valenjess/CubeSat/README.md

# CubeSat
El proyecto consiste en diseñar el hardware electrónico de un nanosatélite académico de formato 1U, tipo CubeSat.
