valenjess/CubeSat/P4/README.md

Esta sección presenta la segunda entrega del proyecto CubeSat.

OBJETIVOS

• Seleccionar y dimensionar los componentes y circuitos de la PCB asignada, justificando su capacidad para cumplir con las especificaciones y las interfaces definidas en la práctica 3.

• Capturar y verificar el diseño electrónico en Altium Designer mediante una estructura jerárquica que facilite su comprensión y reutilización, utilizando símbolos y huellas de componentes validados.

• Establecer las restricciones eléctricas y de fabricación que orientarán el diseño de la PCB, documentarlas en el proyecto y estimar el costo de sus componentes para diferentes volúmenes de producción.

CONTENIDO

• Proyecto nativo de Altium con todas las hojas esquemáticas y las dependencias necesarias para abrirlo.

• Librerías propias editables y modelos utilizados, con símbolos y huellas verificados.

• Todas las hojas de datos y las notas de aplicación utilizadas como soporte.

• Matriz de restricciones, cálculos y análisis de costos en formato editable, con fórmulas cuando corresponda.

• BOM exportada en formato tabular editable y esquemas completos en PDF.

• Informe final.
