valenjess/CubeSat/P3/Diagrama_Arquitectura.pptx

CubeSat 1U — Diagrama funcional de referencia

Arquitectura seleccionada · Trazabilidad con interfaces IF-01 a IF-15

LEYENDA

Potencia

ESTACIÓN
TERRESTRE

IF-15: C&DH ↔ estación terrestre
(a través de TT&C)

IF-14

ANTENA

IF-15

PCB 2 — AVIÓNICA

IF-13

IF-12

TRANSCEPTOR
TT&C

Datos / control

RF

HW + software futuro

C&DH
centralizado

IF-08

ALMACENAMIENTO

IF-04

Trazabilidad:
IF-01 … IF-15
conexiones principales
definidas en la tabla.

IF-11

IF-07

IF-05

CÁMARA
MULTIESPECTRAL

IF-09

ADCS
SENSORES

IF-10

IF-06

PANELES
SOLARES

IF-01

BATERÍA

IF-02

PCB 1 — EPS
Potencia

IF-03

DRIVERS /
MAGNETORQUERS

Nota: protocolos, tensiones y componentes concretos permanecen TBD cuando la documentación de esta etapa no permite cerrarlos.
