valenjess/CubeSat/P4/Entregables/LAB4_DPE.pdf

Diseno electr ˜ | onico y captura esquem ´ | atica de una ´

# tarjeta ADCS para un CubeSat 1U

Valentina Gaviria Samboni¹

, Sebastian Zuluaga Correa¹
1Departamento de Ingeniería Electronica y Telecomunicaciones, Programa de Ingenier ´ | ía Electronica, ´
Universidad de Antioquia, Medellín, Colombia
Abstract—Este informe presenta el diseno electr ˜ | onico y la ´
captura esquematica de una tarjeta dedicada al sistema de deter- ´ minacion y control de actitud (ADCS) de un CubeSat 1U. A partir ´ de la arquitectura definida en la practica anterior, se restringe el ´ alcance a una PCB ADCS autonoma que adquiere variables de ´ actitud, ejecuta el procesamiento necesario para la determinacion´ y el control, acciona tres ruedas de reaccion y tres magnetorquers, ´ y entrega informacion de estado a una tarjeta principal externa. ´ El diseno integra un microcontrolador STM32G474RET6, una ˜ IMU ICM-42670-P, un magnetometro MMC5983MA, seis sen- ´ sores solares BPW34 con acondicionamiento transimpedancia, un ADC ADS8166, controladores DRV8833 para los magnetorquers,
interfaces para ruedas de reaccion, memoria FRAM, supervisi ´ | on´
de reset, alimentacion local y una interfaz externa CAN-FD. Se ´ documentan las decisiones de seleccion, los circuitos auxiliares, el ´ presupuesto preliminar de potencia, las restricciones electricas y ´
de fabricacion, la validaci ´ | on ERC y la BOM. El costo estimado ´
de componentes por tarjeta disminuye de USD 71.57 para un lote de 10 unidades a USD 49.81 para 1000 unidades, bajo el criterio de compra documentado. El resultado corresponde al cierre del
diseno esquem ˜ | atico de la tarjeta; el enrutamiento y la fabricaci ´ | on´
física permanecen como etapas posteriores.
Index Terms—CubeSat 1U, ADCS, determinacion de actitud, ´ control de actitud, STM32G474, magnetometro, IMU, sensores ´ solares, CAN-FD, Altium Designer.
I. INTRODUCCION Y ALCANCE ´

La Practica 4 establece como objetivo seleccionar y di- ´ mensionar los componentes de la PCB asignada, justificar su capacidad frente a las especificaciones e interfaces de la
practica anterior, capturar y verificar el dise ´ | no en Altium ˜
Designer y documentar las restricciones que condicionaran´ la futura implementacion f ´ ísica [1]. La entrega debe permitir que otra persona comprenda la tarjeta y continue con el ´
diseno de PCB, manteniendo expl ˜ | ícitos los límites del trabajo
academico. ´
En esta practica el alcance fue redefinido por el profesor ´ para concentrarse exclusivamente en la tarjeta ADCS. Por tanto, la tarjeta principal externa no se disena: ˜ unicamente ´ se define la interfaz que permitira intercambiar comandos, ´
configuracion, estado y telemetr ´ | ía. Quedan fuera del alcance
el payload, camara, TT&C/RF, almacenamiento de im ´ | agenes, ´
OBC completo, EPS completo del CubeSat, antena y estacion´ terrestre. Esta delimitacion es fundamental para evitar incor- ´ porar funciones que pertenecen a otras tarjetas del sistema.
La solucion final se implement ´ | o como una PCB ADCS ´
dedicada, con un procesamiento centralizado y bloques de
sensado, actuacion, alimentaci ´ | on, supervisi ´ | on y comunicaci ´ | on. ´
La Figura I debe corresponder al diagrama funcional final del
diseno y mostrar expl ˜ | ícitamente la frontera entre la ADCS y
la tarjeta principal externa.

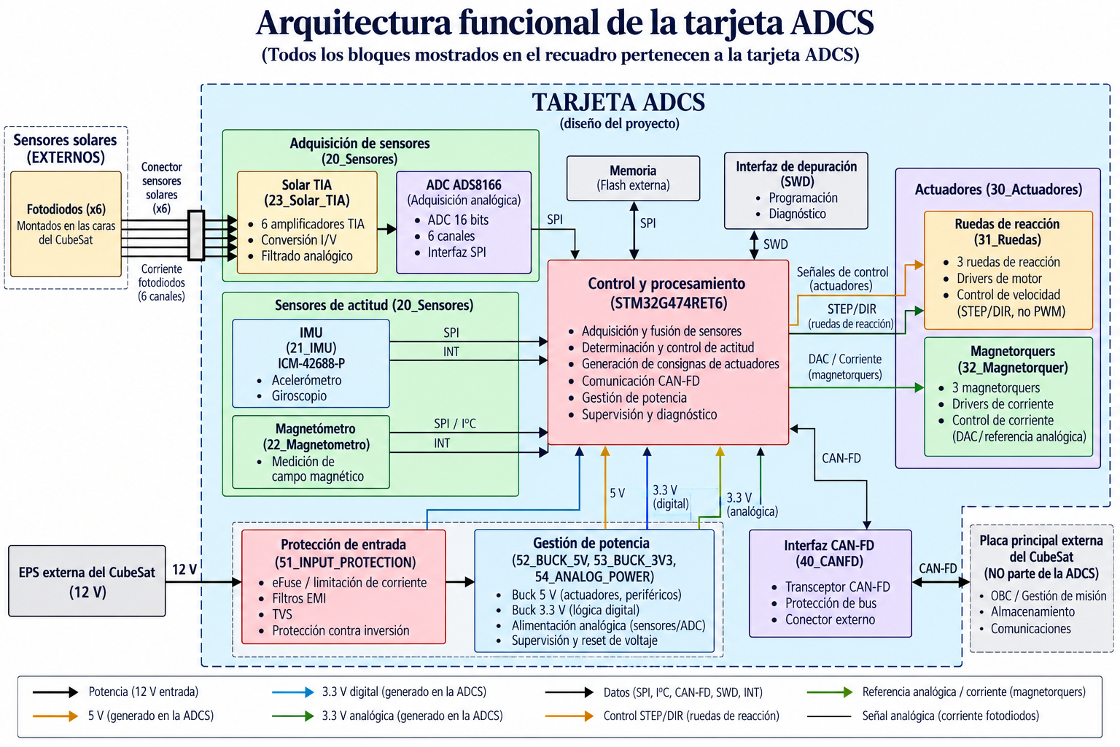
[picture p20: figure]

Fig. 1. Arquitectura funcional de la tarjeta ADCS y su interfaz con la tarjeta principal externa.

II. REQUISITOS APLICABLES Y TRAZABILIDAD CON LA
PRACTICA ´ | 3

La línea base de P4 conserva los requisitos de P3 que afectan directamente a la ADCS. En particular, RF-007 exige
la determinacion de actitud, RF-008 el control y estabilizaci ´ | on, ´
RF-018 la deteccion y recuperaci ´ | on de fallos, RF-019 la ´
supervision, y ET-35, ET-38, ET-39 y ET-40 condicionan ´ interfaces, rieles, niveles logicos y protocolos. ET-45 se utiliza ´ como criterio funcional de cierre del control de actitud y ET-
46 mantiene la consideracion del entorno de radiaci ´ | on en la ´
evaluacion de componentes. ´
La principal modificacion frente a P3 es el cambio de nivel ´
de abstraccion: mientras P3 establec ´ | ía una arquitectura global
del CubeSat, P4 convierte el bloque ADCS en una tarjeta
electronica concreta. En consecuencia, par ´ | ametros globales ´
como el desempeno angular final, el perfil orbital completo o el ˜ enlace TT&C no se vuelven requisitos electricos de esta PCB; ´ unicamente se conservan como entradas para dimensionar la ´ funcion ADCS y su interfaz. ´

III. DESCRIPCION FUNCIONAL Y ARQUITECTURA DE LA ´

TARJETA
La arquitectura seleccionada es un ADCS integrado en una
unica PCB dedicada. El MCU central concentra adquisici ´ | on, ´

TABLE I
TRAZABILIDAD DE REQUISITOS DE P3 APLICABLES AL DISENÕ ADCS
ID | Requisito / especificacion | Aplicaci ´ | on en la PCB ADCS | Tratamiento en P4 ´
RF-007 | Determinacion de actitud | Sensores inerciales, magnet ´ | ometro, sensores solares, ´
adquisicion y procesamiento ´

Seleccion de sensores, ADC, MCU e inter- ´ faces; captura de los circuitos asociados.
RF-008 | Control y estabilizacion de actitud | Procesamiento, drivers y actuadores | Tres ruedas de reacci ´ | on y tres magnetorquers; ´
drivers y temporizacion definidos. ´
RF-009 | Apuntamiento de la camara | Objetivo global de desempe ´ | no del ADCS | Se conserva como criterio de desempe ˜ | no; no ˜
genera hardware de camara en esta PCB. ´
RF-018 | Deteccion, aislamiento y recuperaci ´ | on | Fallos propios de la tarjeta | Supervisor de tensi ´ | on, reset, watchdog in- ´
| | | | | | terno, senales de fallo y telemetr ˜ | ía.
RF-019 | Supervision de subsistemas | Estado y salud del ADCS | Entrega de estado, mediciones y telemetr ´ | ía a
| | | | | | la tarjeta principal.
RNF-006 | Interfaces y compatibilidad | Sensores, actuadores y enlace externo | Verificacion de niveles, protocolos y compat- ´
| | | | | | ibilidad electrica. ´
RNF-007 | Robustez / operacion | Protecci ´ | on y supervisi ´ | on | Protecci ´ | on de entrada, supervisi ´ | on de poten- ´
| | | | | | cia y estados seguros.
RNF-008 | Mantenibilidad / verificabilidad | Debug, pruebas y diagnostico | SWD, test points y separaci ´ | on de funciones ´
| | | | | | de verificacion. ´
ET-35 | Interfaces críticas | Interconexiones internas y externas | Interfaces reales derivadas de los compo-
| | | | | | nentes seleccionados.
ET-38 | Rieles de alimentacion | Entrada y regulaci ´ | on local | +12V ´ | PROT, +5V ACT, +5V ANA y +3V3.
ET-39 | Niveles logicos | MCU y perif ´ | ericos digitales | Verificaci ´ | on de compatibilidad de 3.3 V y 5 ´
V segun dispositivo. ´
ET-40 | Protocolos | SPI, I²C, FDCAN y GPIO/timers | Definidos a partir de los componentes final-
| | | | | | mente seleccionados.
ET-45 | Capacidad funcional de control de actitud | Procesamiento + actuacion | Arquitectura cerrada y verificada a nivel es- ´
quematico. ´
ET-46 | Entorno de radiacion | Componentes cr ´ | íticos ADCS | Considerado como criterio de evaluacion; no ´
| | | | | | constituye certificacion espacial. ´
determinacion/estimaci ´ | on, control, gesti ´ | on de actuadores y ´
comunicacion externa. El flujo funcional es: ´

Sensores → Adquisicion´ → Estimacion´
→ Control → Drivers → Actuadores.

(1)

La informacion de estado y telemetr ´ | | ía se entrega a la tarjeta
principal mediante la interfaz externa CAN-FD.

TABLE II
BLOQUES FUNCIONALES DE LA PCB ADCS
Bloque | Interfaz principal | Funcion´
Procesamiento | SPI, | I²C, | FDCAN,
GPIO, timers

Determinacion, control, estados y ´ comunicacion. ´
Sensado
inercial
| SPI1 + INT | | IMU de 6 ejes.
Sensado magnetico ´ | SPI1 + DRDY | | Campo magnetico terrestre en 3 ´
ejes.
Sensado solar | TIA + ADC/SPI2 | Seis canales de irradiancia.
Ruedas | de
reaccion´
SPI3 + CS/ENABLE | Interfaz de tres RW0.
Magnetorquers | PWM/GPIO + H-bridge | Accionamiento de tres torquer.
Interfaz externa | FDCAN1 | | Comunicacion bidireccional con tar- ´ jeta principal.
Alimentacion | +12 V, +5 V, +3.3 V | Protecci ´ | on y regulaci ´ | on local. ´
Supervision/debug NRST, | SWD, | test ´
| points
Reset, diagnostico y programaci ´ | on. ´

La estructura jerarquica se organiza en hojas funcionales ´ para facilitar lectura y reutilizacion. Las hojas de sen- ´
sores, actuadores, alimentacion, adquisici ´ | on y comunicaci ´ | on´
se conectan mediante puertos jerarquicos y nombres de red ´ consistentes. Esta estrategia reduce conexiones largas, facilita
la revision por bloques y permite que el dise ´ | no f ˜ | ísico posterior
mantenga una correspondencia directa con el esquematico. ´

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
D | D
C | C
B | B
A | A

Title

Size | Number | Revision

A4

Date: | 10/26/2026 | Sheet of
File: | C:\Users\..\00_ADCS_TOP.SchDoc | Drawn By:

CTRL_10
10_Control.SchDoc

SNS_20
20_Sensores.SchDoc

ACTS_30
30_Actuadores.SchDoc

CAN_40
40_CANFD.SchDoc

PWR_50
50_POWER.SchDoc

ADCS ESTRUCTURA PCB

Cannot open file ClipboardPicture24/10/2026 9:08:14 p. m.. File does not exist.

Fig. 2. Hoja superior y estructura jerarquica del proyecto ADCS exportada ´ directamente desde Altium Designer.

IV. SELECCION DE COMPONENTES ´

El criterio de seleccion seguido fue consolidar primero las ´ necesidades de sensores y actuadores y, a partir de ellas, derivar los recursos requeridos por el MCU. De esta manera, el procesador no se selecciono arbitrariamente antes de conocer ´ los buses, temporizadores, GPIO, interrupciones, memoria y recursos de comunicacion exigidos por el ADCS. ´

A. Procesamiento y memoria

El STM32G474RET6 fue seleccionado como nucleo de ´ procesamiento. La eleccion se sustenta en la disponibilidad ´ de SPI multiples, I ´

2C, FDCAN, temporizadores para PWM,

GPIO, interrupciones, watchdog, SWD y recursos de procesamiento suficientes para la funcion de ADCS. La memoria ´ FRAM MB85RC256V se incorpora mediante I²C para almacenar parametros, calibraciones, sesgos, eventos y otros datos ´ no volatiles. ´

B. Sensores de actitud
La IMU ICM-42670-P proporciona acelerometro y ´
giroscopo de tres ejes mediante SPI. El magnet ´ | ometro ´
MMC5983MA proporciona medicion magn ´ | etica de tres ´
ejes y comparte SPI1 con la IMU mediante líneas CS
independientes. La separacion f ´ | ísica respecto a fuentes
magneticas y etapas de potencia queda como una restricci ´ | on´
crítica del futuro layout.

TABLE III
SENSORES SELECCIONADOS
Elemento | Seleccion | Justificaci ´ | on´
IMU | ICM-42670-P | Integracion de aceler ´ | ometro y gir ´ | oscopo, ´
interfaz SPI, bajo consumo y CAD
| | disponible.
Magnetometro | MMC5983MA | Alta sensibilidad para determinaci ´ | on de ´
actitud e interfaz digital compatible con
| | el MCU.
Sensores solares | 6 × BPW34 | Arquitectura discreta de coarse sun sen-
sors; permite implementar TIA y ADC
| | propios.
C. Sensado solar y adquisicion anal ´ | ogica ´
Se adoptan seis BPW34, uno por cara del CubeSat, como sensores solares gruesos. Cada fotodiodo entrega una corriente
fotoelectrica que se convierte a tensi ´ | on mediante un canal ´
de transimpedancia. Dos OPA4322AIPWR proporcionan ocho amplificadores disponibles, de los cuales seis se destinan a los canales solares y dos quedan como reserva. El valor preliminar
de la resistencia de realimentacion se fij ´ | o en ´ | Rf = 220 Ω y el
capacitor Cf permanece DNP hasta validar estabilidad, ruido y ancho de banda mediante simulacion o ensayo. ´
El ADC ADS8166IRHBT convierte los seis canales y conserva dos entradas adicionales disponibles. Se emplea SPI2
para datos y control, con una senal ADC ˜ | READY hacia PA15
que debe verificarse durante la revision final de asignaci ´ | on de ´
funciones alternativas.
D. Actuadores y drivers
Se integran tres ruedas de reaccion NanoAvionics RW0 ´ como modulos externos y tres magnetorquers CubeSpace ´ CR0002. Las ruedas utilizan una interfaz SPI compartida, con CS y ENABLE individuales. Para los magnetorquers se utilizan dos DRV8833PWPR, proporcionando tres puentes H efectivos para las tres bobinas. Cada puente recibe dos senales ˜ de entrada y se dispone de nSLEEP y nFAULT para estados seguros y diagnostico. ´
E. Interfaz externa CAN-FD
La interfaz externa se implementa mediante el transceptor TCAN1042HGVDRQ1, con VCC de 5 V y VIO de 3.3 V. Se adopta una velocidad de arbitraje de 500 kbit/s y una

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
D | D
C | C
B | B
A | A

Title

Size | Number | Revision

A4

Date: | 10/26/2026 | Sheet of
File: | C:\Users\..\31_Ruedas.SchDoc | Drawn By:

RUEDAS DE REACCIÓN

IN 1

NC 4

ON 3

OUT | 6
QOD | 5
GND | 2

SW1

TPS22919DCKR

IN 1

NC 4

ON 3

OUT | 6
QOD | 5
GND | 2

SW2

TPS22919DCKR

IN 1

NC 4

ON 3

OUT | 6
QOD | 5
GND | 2

SW3

TPS22919DCKR

1 2 R18

1 2 R19

1 2 R20

1 2 R21

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
Cannot open file ClipboardPicture25/10/2026 1:31:44 p. m.. File does not exist.

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
530470710

+5V_ACT

+5V_ACT

+5V_ACT

GND

GND

GND

10_Control[3B] | RW1_PWR_EN
10_Control[3B] | RW2_PWR_EN
10_Control[3B] | RW3_PWR_EN

+5V_RW1

+5V_RW2

+5V_RW3

+5V_RW1

GND

GND

GND

GND

Cannot open file ClipboardPicture25/10/2026 7:43:58 p. m.. File does not exist.

10_Control[1C] | RW1_ENABLE
10_Control[3B], 31_Ruedas[3C], 31_Ruedas[4B] | SPI3_MISO
10_Control[3B], 31_Ruedas[2C], 31_Ruedas[4B] | SPI3_MOSI
10_Control[3B], 31_Ruedas[2C], 31_Ruedas[4B] | SPI3_SCK
10_Control[1C] | RW1_CS

GND

1 2 R23

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
530470710

+5V_RW3

GND

10_Control[1C] | RW3_ENABLE
10_Control[3B], 31_Ruedas[3B], 31_Ruedas[4B] | SPI3_MISO
10_Control[3B], 31_Ruedas[3B], 31_Ruedas[4B] | SPI3_MOSI
10_Control[3B], 31_Ruedas[2B], 31_Ruedas[4B] | SPI3_SCK
10_Control[1C] | RW3_CS

GND

1 2 R22

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
530470710

+5V_RW2

GND

10_Control[1C] | RW2_ENABLE
10_Control[3B], 31_Ruedas[3B], 31_Ruedas[3C] | SPI3_MISO
10_Control[3B], 31_Ruedas[2C], 31_Ruedas[3B] | SPI3_MOSI
10_Control[3B], 31_Ruedas[2B], 31_Ruedas[2C] | SPI3_SCK
10_Control[1C] | RW2_CS

GND

Fig. 3. Etapa de ruedas de reaccion y conexiones hacia los m ´ | odulos externos. ´

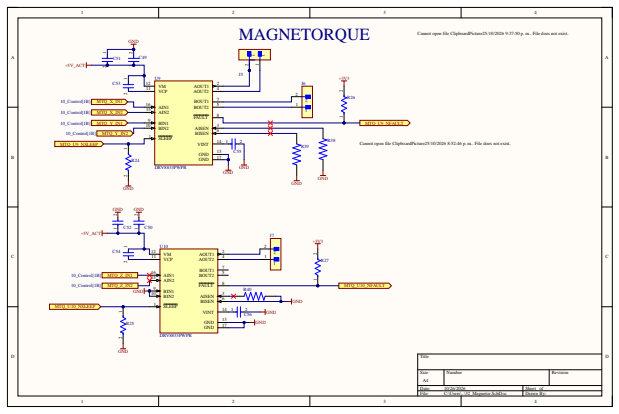
[picture p21: figure]
Title; Size; Number; Revision; Date:; Sheet of; File:; C:\Users\..\32_Magnetor.SchDoc; Drawn By:; MAGNETORQUE; VINT; AOUT1; AOUT2; BOUT1; BOUT2; BIN1 9 BIN2 10; AIN1 16 AIN2 15; FAULT; SLEEP 1; AISEN; BISEN; VCP 11; GND; DRV8833PWPR; 10_Control[1B]; MTQ_X_IN1; MTQ_X_IN2; MTQ_Y_IN2; MTQ_Y_IN1; MTQ_Z_IN1; MTQ_Z_IN2; MTQ_U9_NSLEEP; MTQ_U10_NSLEEP; MTQ_U9_NFAULT; MTQ_U10_NFAULT; +5V_ACT

Cannot open file ClipboardPicture25/10/2026 8:52:46 p. m.. File does not exist.

Cannot open file ClipboardPicture25/10/2026 9:37:50 p. m.. File does not exist.

Fig. 4. Etapa de magnetorquers y sus drivers de potencia.

velocidad de datos de 2 Mbit/s. La cadena física incorpora una
CMC, proteccion ESD, terminaci ´ | on de 120 ´ | Ω seleccionable y
conector externo. La terminacion se implementa mediante R28 ´ y un selector R29 de 0 Ω/DNP.
V. DISENO ELECTR ˜ | ONICO DE LOS BLOQUES CR ´ | ÍTICOS
A. Mapa de recursos del MCU

La asignacion principal de recursos se muestra en la ´ Tabla V. La distribucion mantiene buses independientes donde ´ la arquitectura lo requiere y evita compartir senales de se- ˜ leccion entre dispositivos con necesidades distintas. ´

B. Reset, arranque y supervision´

El supervisor TPS3839K33DBZR genera el reset del MCU sin requerir un pull-up externo en NRST, de acuerdo con la configuracion push-pull adoptada. PB8 se utiliza como ´ I

2C1 SCL; por ello no se utiliza como configuracion de ´ BOOT0 y la dependencia de arranque se gestiona mediante option bytes. El watchdog interno IWDG queda disponible para recuperacion ante bloqueo del software futuro. ´

TABLE IV
ACTUADORES Y ELECTRONICA DE ACCIONAMIENTO ´
Elemento | Seleccion | Cantidad | Interfaz / electr ´ | onica | Observaci ´ | on´
Rueda de reaccion | NanoAvionics RW0 | 3 | SPI3 | compartido | + | CS/ENABLE ´
individual; | alimentacion | mediante ´
TPS22919DCKR

El modulo incorpora su propia ´ electronica de control; el ICD de ´ harness debe cerrarse antes del layout.
Magnetorquer | CubeSpace CubeTorquer CR0002 | 3 | H-bridge DRV8833, PWM/GPIO | El driver de potencia se imple-
menta localmente; deben verificarse los límites electricos y el ICD defini- ´ tivo.
Driver MTQ | DRV8833PWPR | 2 | Seis IN1/IN2, nSLEEP y nFAULT | Se utilizan tres de los cuatro puentes
disponibles.
Load switch RW | TPS22919DCKR | 3 | PWR EN individual | Permite conmutacion y aislamiento ´
de cada rueda.

TABLE V
ASIGNACION PRINCIPAL DE PINES E INTERFACES DEL ´ | STM32G474RET6
Recurso | Pines / senales | Destino | Funci ˜ | on´
SPI1 | PA5/PA6/PA7 | ICM-42670-P + MMC5983MA | Bus de sensores de actitud; CS independientes en PC0/PC1.
Interrupciones | PC2, PC4, PC5 | Magnetometro / IMU | DRDY e INT1/INT2. ´
SPI2 | PB13/PB14/PB15 + PB12 | | ADS8166 | Conversion solar; ADC ´ | READY en PA15.
SPI3 | PC10/PC11/PC12 | RW1–RW3 | Comunicacion con ruedas de reacci ´ | on. ´
I
2C1 | PB8/PB9 | | MB85RC256V | FRAM de parametros/calibraciones. ´
FDCAN1 | PA11/PA12 | TCAN1042HGVDRQ1 | Interfaz CAN-FD externa.
PWM/timers | PA0–PA3, PB0/PB1 | DRV8833 U9/U10 | Seis comandos IN1/IN2 para tres magnetorquers.
Supervision | PC3/PA4/PB7 | PG ´ | 5V, PG 3V3, POWER FAULT | Supervision de alimentaci ´ | on. ´
SWD | PA13/PA14 | | ST-LINK | Programacion y depuraci ´ | on. ´
Reset | PG10 | | TPS3839K33DBZR | Reset supervisado.

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
D | D
C | C
B | B
A | A

Title

Size | Number | Revision

A4

Date: | 10/26/2026 | Sheet of
File: | C:\Users\..\40_CANFD.SchDoc | Drawn By:
VCC 3 | CANH | 7
| CANL | 6

RXD 4

STB 8

TXD 1

VIO | 5
GND | 2

U11

TCAN1042HGVDRQ1

1

2 | 3

4 L1

ACT1210D-101-2P-TL00

2

1

3

D7
NUP2105LT1G

R28
RC0402FR-07120RL

1 2 R29

RC0402FR-070RL

R30
RC0402FR-0710KL

C57
GRM155R71A104KA01J

C58
GRM155R71A104KA01J

1 2
C59
CL10A475KP8NNNC

2
1

3

J8

TSW-103-07-T-S +3V3

GND

+5_ACT

10_Control[1B] | FDCAN1_TX
10_Control[1B] | FDCAN1_RX

CAN_H

CAN_L

Fig. 5. Interfaz física CAN-FD con transceptor, proteccion, terminaci ´ | on y ´
conector externo.
C. Entrada de alimentacion y protecci ´ | on´

La tarjeta recibe una alimentacion externa nominal de +12 ´ V, con un rango de diseno de 10–15 V. La entrada incor- ˜ pora TVS, capacitor bulk, capacitor de alta frecuencia y un eFuse TPS26600RHFR segun la BOM exportada. El eFuse ´
proporciona proteccion frente a sobrecorriente, subtensi ´ | on, ´
sobretension y polaridad inversa. La red RILIM se dimension ´ | ó
preliminarmente en 6.78 kΩ para un límite cercano a 1.8 A; las redes de UVLO/OVLO utilizan 357 kΩ, 18.0 kΩ y 30.1 kΩ. Nota de consistencia documental: el inventario actualizado del proyecto identifica U12 como TPS26601RHFR, mientras

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
D | D
C | C
B | B
A | A

Title

Size | Number | Revision

A4

Date: | 10/26/2026 | Sheet of
File: | C:\Users\..\10_Control.SchDoc | Drawn By:

CONTROL

VDD 16
VDD 32
VDD 48
VDD 64
VDDA 29
PC0 | 8
PC1 | 9
PC2 | 10
PC3 | 11
PC4 | 22
PC5 | 23
PC6 | 38
PC7 | 39
PC8 | 40
PC9 | 41
PC10 | 52
PC11 | 53
PC12 | 54
PC13 | 2
PC14-OSC32 IN | 3
PC15-OSC32 OUT | 4
PF0-OSC IN | 5
PF1-OSC OUT | 6

PA0 12
PA1 13
PA2 14
PA3 17
PA4 18
PA5 19
PA6 20
PA7 21
PA8 42
PA9 43
PA10 44
PA11 45
PA12 46
PA13 49
PA14 50
PA15 51
PD2 | 55
PG10/RST | 7

VBAT 1

VREF+ 28

PB0 24
PB1 25
PB2 26
PB3 56
PB4 57
PB5 58
PB6 59
PB7 60
PB8-BOOT0 61
PB9 62
PB10 30
PB11 33
PB12 34
PB13 35
PB14 36
PB15 37
VSS | 15
VSS | 31
VSS | 47
VSS | 63
VSSA | 27

U1

STM32G474RET6

GND | 1
RESET_N | 2 VDD 3

U2

TPS3839K33DBZR

WP | 7
VSS | | 4
SDA | 5 SCL | 6

VDD 8

A0 1
A1 2
A2 3

U3

FM24W256-GTR

1 2
C7

1 2
C5

1 2
C3

1 2

C2 ¹ 2
C4 | 1 2
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
01 01
02 02
03 03
04 04
05 05

J1

TSW-105-07-L-S

+3V3

GND

GND

AGND

Capacitores de 0.1uF para respuestas rápidas de HF, y el de 4.7uF para desacoplo general y reserva de energía

1 2
C78

+3V3A

AGND
AGND
+3V3A | +3V3

+3V3

GND

GND

+3V3

GND

+3V3

GND

I2C1_SCL | 10_Control[1C]
I2C1_SDA | 10_Control[1C]
10_Control[4A] | I2C1_SDA

I2C1_SCL

10_Control[4A]

R1

R2

+3V3

+3V3

10_Control[3C] | SWDIO
10_Control[3C] | SWCLK
10_Control[1B] | SWDIO
10_Control[1C] | SWCLK

GND

PG10-NRST
10_Control[3C], 10_Control[4B], Adquicision_Analogica[4A]

PG10-NRST
10_Control[2C], 10_Control[4B], Adquicision_Analogica[4A]
1 | 2

D1

PG10-NRST
10_Control[2C], 10_Control[3C], Adquicision_Analogica[4A]

1 2
C11
IMU_CS | 21_IMU[2A]
MAG_CS | 22_Magnetometro[2A]
MAG_DRDY | 22_Magnetometro[2A]
IMU_INT1 | 21_IMU[2A]
IMU_INT2 | 21_IMU[2A]
21_IMU[3A], 22_Magnetometro[2A] | SPI1_SCK
21_IMU[3A], 22_Magnetometro[3A] | SPI1_MISO
21_IMU[3A], 22_Magnetometro[2B] | SPI1_MOSI
Adquicision_Analogica[4B] | ADC_CS
Adquicision_Analogica[4B] | SPI2_SCK
Adquicision_Analogica[4A] | SPI2_MISO
Adquicision_Analogica[4B] | SPI2_MOSI
Adquicision_Analogica[4A] | ADC_READY
40_CANFD[1B] | FDCAN1_RX
40_CANFD[1B] | FDCAN1_TX
51_INPUT_PROTECTION[4A] | POWER_FAULT
RW1_PWR_EN | 31_Ruedas[1A]
RW2_PWR_EN | 31_Ruedas[1C]
RW3_PWR_EN | 31_Ruedas[1D]
SPI3_SCK | 31_Ruedas[2B], 31_Ruedas[2C], 31_Ruedas[4B]
31_Ruedas[2B] | RW1_ENABLE
31_Ruedas[3B] | RW2_ENABLE
31_Ruedas[2C] | RW3_ENABLE
SPI3_MISO | 31_Ruedas[3B], 31_Ruedas[3C], 31_Ruedas[4B]
SPI3_MOSI | 31_Ruedas[2C], 31_Ruedas[3B], 31_Ruedas[4B]
31_Ruedas[3B] | RW1_CS
31_Ruedas[4B] | RW2_CS
31_Ruedas[3C] | RW3_CS

32_Magnetor[1A] MTQ_X_IN1
32_Magnetor[1B] MTQ_X_IN2
32_Magnetor[1B] MTQ_Y_IN1
32_Magnetor[1B] | MTQ_Y_IN2
32_Magnetor[1C] | MTQ_Z_IN1
32_Magnetor[1C] | MTQ_Z_IN2

Fig. 6. Hoja de control con el STM32G474RET6, buses y senales principales. ˜

que la BOM exportada identifica TPS26600RHFR. Antes del commit final debe verificarse el MPN real colocado en el esquematico y sincronizar ambos documentos. Esta verifi- ´ cacion es obligatoria para mantener la correspondencia BOM– ´ esquematico. ´

D. Regulacion de potencia ´

El riel +12V PROT alimenta dos convertidores buck. U13 TPS62133A-Q1 genera +5V ACT y U14 TPS62162DSGT
genera +3V3. El riel analogico +5V ´ | ANA se obtiene medi-
ante una ferrita desde +5V ACT y se filtra localmente para alimentar los amplificadores y el ADC.

TABLE VI
Á RBOL DE ALIMENTACION DE LA TARJETA ´
Etapa | | Salida | Carga principal
Entrada + proteccion | +12V ´ | PROT | Toda la tarjeta.
Buck U13 | | +5V ACT | Ruedas, magnetorquers, drivers y logica de 5 V. ´
Filtro analogico | +5V ´ | ANA | OPA4322 y ADS8166.
Buck U14 | +3V3 | MCU, sensores, FRAM, transceptor y
| | | logica. ´
E. Presupuesto preliminar de potencia
El peor caso conservador de las ruedas de reaccion domina ´ el presupuesto. Para tres RW0 se consideran hasta 0.65 A por unidad a 5 V, resultando:
PRW = 3(5 V)(0.65 A) = 9.75W. | (2)

Para tres CR0002 se adopta preliminarmente una corriente promedio equivalente a 5/51 A por actuador con un ciclo de trabajo del 80%, resultando aproximadamente 1.18
W. Sumando OPA4322, ADS8166, drivers, MCU, sensores, FRAM, CAN y logica se obtiene un presupuesto preliminar ´ de aproximadamente 11.36 W antes de perdidas. Con 20% de ´

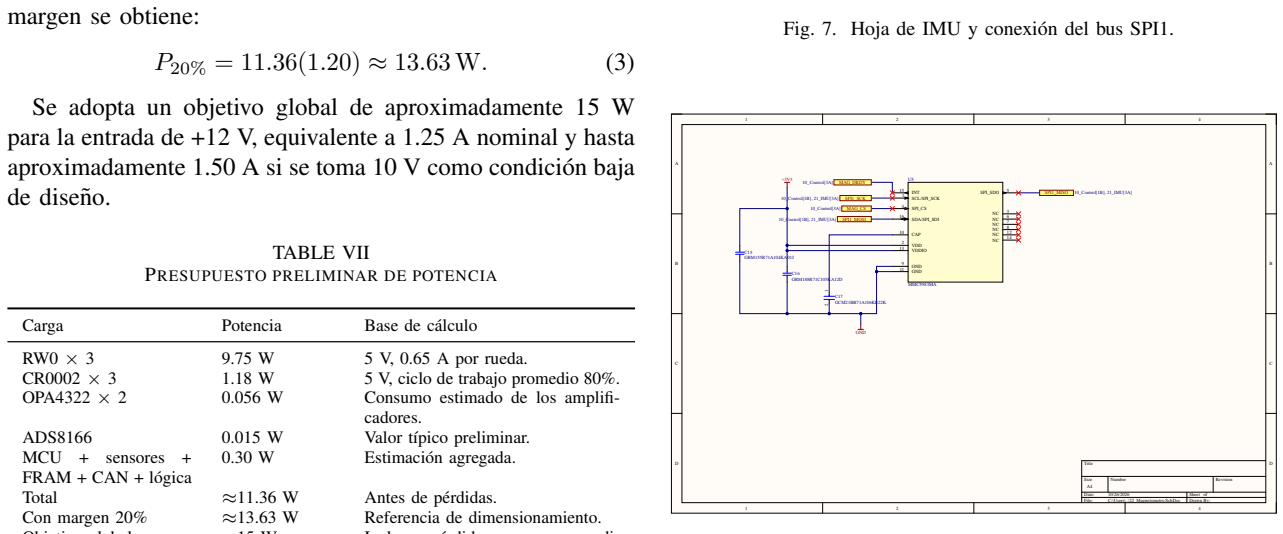
[picture p22: figure]
margen se obtiene:; de diseno. ˜; TABLE VII; PRESUPUESTO PRELIMINAR DE POTENCIA; Carga; Potencia; Base de calculo ´; 5 V, 0.65 A por rueda.; OPA4322 × 2; Consumo estimado de los amplifi-; cadores.; ADS8166; Valor típico preliminar.; MCU + sensores + FRAM + CAN + logica ´; Estimacion agregada. ´; Total; Antes de perdidas. ´; Con margen 20%; Referencia de dimensionamiento.; Title; Size; Number; Revision; Date:; Sheet of; File:; C:\Users\..\22_Magnetometro.SchDoc; Drawn By:; INT 15 SCL/SPI_SCK 1; SPI_CS 4; SDA/SPI_SDI 16; CAP 10; VDD 2 VDDIO 13; GND 9 GND 11; SPI_SDO; MMC5983MA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

Se adopta un objetivo global de aproximadamente 15 W para la entrada de +12 V, equivalente a 1.25 A nominal y hasta aproximadamente 1.50 A si se toma 10 V como condicion baja ´

CR0002 × 3 | 1.18 W | 5 V, ciclo de trabajo promedio 80%.
Objetivo global | ≈15 W | Incluye perdidas y margen adi- ´ cional.
VI. ADQUISICION SOLAR Y C ´ | ALCULOS DE CIRCUITOS ´

Cada BPW34 se conecta a un canal de transimpedancia.
Para un canal ideal, la relacion de primera aproximaci ´ | on es: ´
Vout ≈ −IphRf , | (4)
donde Iph es la corriente fotoelectrica y ´ | Rf = 220 Ω es
el valor preliminar adoptado. El capacitor Cf permanece DNP porque su valor depende de la capacitancia total del fotodiodo, capacitancias parasitas, estabilidad del OPA4322, ´ ruido y ancho de banda deseado. Esta decision evita fijar un ´ valor sin una validacion suficiente. ´
Los seis canales llegan al ADS8166, un ADC SAR de 16 bits y ocho entradas. La capacidad de dos canales adicionales permite reservar entradas para futuras necesidades o mediciones auxiliares. La referencia y los desacoplos se implemen-
tan segun las recomendaciones de aplicaci ´ | on del fabricante: ´
REFIO y REFby2 con 1 µF, y red REFP–REFM con 22 µF.
El ADC incorpora ademas el capacitor de desacoplo de 1 ´ | µF
indicado en la arquitectura del proyecto.

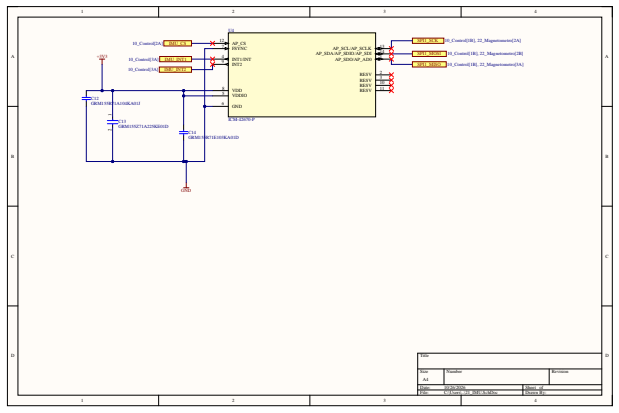
[picture p23: figure]
Title; Size; Number; Revision; Date:; Sheet of; File:; C:\Users\..\21_IMU.SchDoc; Drawn By:; AP_CS 12 FSYNC 7; INT1/INT 4 INT2 9; VDD 8 VDDIO 5; GND 6; AP_SCL/AP_SCLK; AP_SDA/AP_SDIO/AP_SDI; AP_SDO/AP_AD0; RESV; ICM-42670-P; C12 GRM155R71A104KA01J; C13 GRM155Z71A225KE01D; C14 GRM155R71E103KA01D; GND; SPI1_SCK; 10_Control[1B], 22_Magnetometro[2A]; SPI1_MOSI; 10_Control[1B], 22_Magnetometro[2B]; SPI1_MISO; 10_Control[1B], 22_Magnetometro[3A]; 10_Control[2A]; IMU_CS; 10_Control[3A]; IMU_INT1; IMU_INT2

Fig. 7. Hoja de IMU y conexion del bus SPI1. ´

Fig. 8. Hoja de magnetometro y conexi ´ | on al bus SPI1. ´

VII. RESTRICCIONES DE PCB Y CONDICIONES DE FABRICACION´

La guía exige distinguir entre límites del fabricante y
criterios de diseno. Para el proyecto se seleccion ˜ | o PCBWay ´
como referencia de fabricacion. Se adopta una PCB r ´ | ígida
de cuatro capas, FR-4, espesor de 1.60 mm y cobre de 1 oz en capas exteriores e interiores. El stackup preliminar es
L1 senales/componentes, L2 GND, L3 potencia y L4 se ˜ | nales ˜
secundarias. El stackup dielectrico definitivo debe confirmarse ´ antes de cerrar cualquier regla dependiente de impedancia. El criterio de ancho de pistas de potencia se derivo del ´ presupuesto de corriente, no del mínimo de fabricacion. Con ´ cobre de 1 oz, capa externa y un criterio termico preliminar ´

TABLE VIII
CONDICIONES PRINCIPALES DE FABRICACION Y DISE ´ | NO ADOPTADAS ˜
Parametro | Capacidad / l ´ | ímite | Objetivo ADCS | Aplicacion´
Capas | 1–14 disponibles | 4 capas | Separacion de se ´ | nales, GND y potencia. ˜
Material | FR-4 | FR-4 | PCB rígida academica. ´
Espesor | 0.2–3.2 mm | 1.60 mm | Valor estandar de referencia. ´
Cobre | 1–8 oz exterior | 1 oz | Base del calculo de potencia. ´
Trace mínimo | 0.10 mm | ≥0.20 mm | No disenar al l ˜ | ímite manufacturable.
Clearance mínimo | 0.10 mm | ≥0.20 mm | Margen DFM.
Taladro mínimo | 0.15 mm | ≥0.25 mm | Evitar taladros innecesariamente pequenos. ˜
Anillo anular | 0.15 mm | ≥0.15 mm | Mantener margen de fabricacion. ´
Cobre a borde | 0.25 mm publicado | ≥0.50 mm | Margen mecanico adicional. ´
Vías | Through-via | Through-via | No se requieren microvías inicialmente.
Acabado | ENIG disponible | ENIG | Adecuado para SMD y contactos.
Impedancia | Servicio disponible | No requerida preliminarmente | Se recalculara si el layout posterior la exige. ´

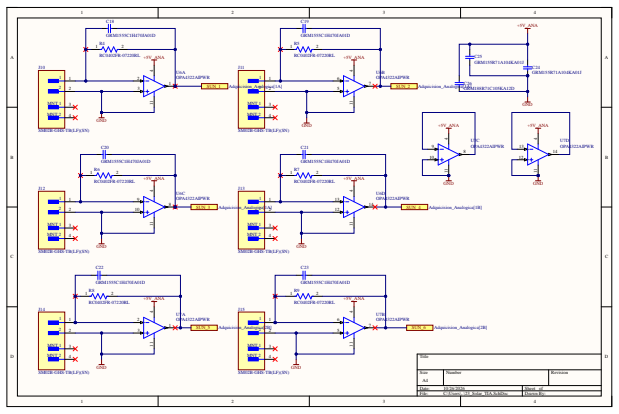
[picture p24: figure]
Title; Size; Number; Revision; Date:; Sheet of; File:; C:\Users\..\23_Solar_TIA.SchDoc; Drawn By:; MNT 1; MNT 2; SM02B-GHS-TB(LF)(SN); U6A OPA4322AIPWR; U6B OPA4322AIPWR; U6C OPA4322AIPWR; U6D OPA4322AIPWR; U7A OPA4322AIPWR; U7B OPA4322AIPWR; U7C OPA4322AIPWR; U7D OPA4322AIPWR; GRM1555C1H470JA01D; C24 GRM155R71A104KA01J; C25 GRM155R71A104KA01J; GRM188R71C105KA12D SUN_1; Adquicision_Analogica[1A]; GND; +5V_ANA; SUN_2; SUN_3; SUN_5; Adquicision_Analogica[2B]; SUN_4; Adquicision_Analogica[1B]; SUN_6

Fig. 9. Acondicionamiento analogico de los sensores solares y adquisici ´ | on´
mediante ADC.

de ∆T = 10 ◦C, se obtuvieron aproximadamente 0.166 mm para 0.65 A y 0.755 mm para 1.95 A. Por margen se adoptan ≥0.20 mm para ramas de hasta 0.65 A y ≥0.80 mm para la troncal +5V ACT de 1.95 A.

I5V,trunk = 3(0.65 A) = 1.95 A. | (5)

La caída de tension no se considera cerrada: debe calcularse ´ cuando se conozca la longitud real de cada tramo, incluyendo vías, conectores y retornos. De forma general,

∆V = IR, | (6)
por lo que la verificacion final requiere la geometr ´ | | ía física.
Las restricciones de colocacion m ´ | as cr ´ | íticas son la proximi-
dad de los capacitores de entrada/salida a los convertidores, la
compactacion de los lazos SW, el aislamiento de las se ´ | | nales ˜
VOS/FB respecto a nodos de alto dV /dt, la continuidad de
retornos, la separacion de sensores magn ´ | | eticos respecto a ´
actuadores y potencia, y la ubicacion local de los desacoplos ´ de IMU, magnetometro, ADC y drivers. ´

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
D | D
C | C
B | B
A | A

Title

Size | Number | Revision

A4

Date: | 10/26/2026 | Sheet of
File: | C:\Users\..\50_POWER.SchDoc | Drawn By:

PWR51
51_INPUT_PROTECTION.SchDoc

PWR52
52_BUCK_5V.SchDoc

PWR53
53_BUCK_3V3.SchDoc

PWR54
54_ANALOG_POWER.SchDoc

POTENCIA

Fig. 10. Hoja de potencia, proteccion de entrada y distribuci ´ | on de rieles. ´

VIII. INCORPORACION DE RESTRICCIONES AL ´ ESQUEMATICO ´

Las restricciones de diseno se clasificaron seg ˜ | un el mecan- ´
ismo disponible en Altium Designer. Las condiciones que pueden comprobarse electricamente se expresan mediante re- ´ glas/directivas asociadas a las redes y tipos de pin cuando corresponde; las condiciones que dependen de la geometría física, la ubicacion o el stackup permanecen en la matriz ´ de restricciones como requisitos para la etapa de PCB. Esta separacion evita confundir una nota descriptiva con una regla ´ efectivamente comprobable.
La matriz consolidada es, por tanto, la fuente de control para las restricciones que no pueden cerrarse en el esquematico. ´ En particular, los anchos de pista de potencia de 0.20 mm y 0.80 mm son objetivos preliminares derivados de corriente y cobre, no simples copias del mínimo manufacturable del proveedor.
IX. VERIFICACION EL ´ | ECTRICA Y REVISI ´ | ON MANUAL ´

La guía exige ejecutar la validacion del proyecto, corregir ´ errores reales, documentar excepciones y complementar ERC
con una revision manual [1]. En el dise ´ | no se realiz ˜ | o la ´
validacion el ´ | ectrica y se corrigieron conexiones incorrectas y ´
asociaciones de terminales. Tambien se ajustaron reglas ERC ´

TABLE IX
TRATAMIENTO DE RESTRICCIONES EN EL PROYECTO
Categoría | Mecanismo | Estado para P4

Tipos de pin y alimentacion´

Reglas ERC / configuracion el ´ ectrica ´

Aplicado y revisado durante la validacion. ´
Redes y buses | Nombres | jerarquicos, ´
puertos | y | reglas | de
conectividad

Incorporado en las hojas
esquematicas. ´
Ancho de pistas | Matriz de restricciones /
regla de PCB posterior
Objetivo | definido;
pendiente de configuracion´ física.
Clearance y taladros Matriz / reglas DRC posteriores

Objetivos definidos segun´ fabricante; pendiente de
PCB.
Ubicacion | y ´
desacoplamiento

Notas de diseno y matriz Debe verificarse durante ˜ placement.
Retornos y separacion´
magnetica ´
Matriz de restricciones | Pendiente | de
implementacion f ´ | ísica.
Stackup e impedancia | Matriz / configuracion de ´
PCB
Stackup | preliminar
definido; valores finales
pendientes.

para controlar condiciones de tipos de pin y alimentacion que ´ no estaban suficientemente definidas en determinados nodos. Los unicos warnings residuales aceptados corresponden a ´ puertos fuera de cuadrícula (Off grid Port). Estos mensajes
son geometricos/documentales y no indican una desconexi ´ | | on´
electrica. Se mantuvieron como excepci ´ | on expl ´ | ícita en lugar
de desactivar globalmente ERC. El mensaje de U1 relacionado
con la validacion de estado de revisi ´ | on frente al servidor de ´
Altium no se contabiliza como error electrico. ´

TABLE X
RESUMEN DE VERIFICACION DEL ESQUEM ´ | ATICO ´
Verificacion | Resultado | Evidencia / observaci ´ | on´
ERC del proyecto | Ejecutado y depurado | Mensajes revisados.
Errores | electricos ´
reales
Corregidos | Conexiones incorrectas corregi-
das.
Terminales / asociaciones
Corregidas | Revision ERC + manual. ´

Reglas de tipos de
pin
Aplicadas | Reglas adicionales configuradas.
Revision manual | Completada | Alimentaci ´ | on, | se ´ | nales, | pines, ˜
buses y auxiliares.
Off grid Port | Aceptados | Excepcion geom ´ | etrica documen- ´
tada.
Estado final | Cerrado | | Sin errores electricos pendientes. ´

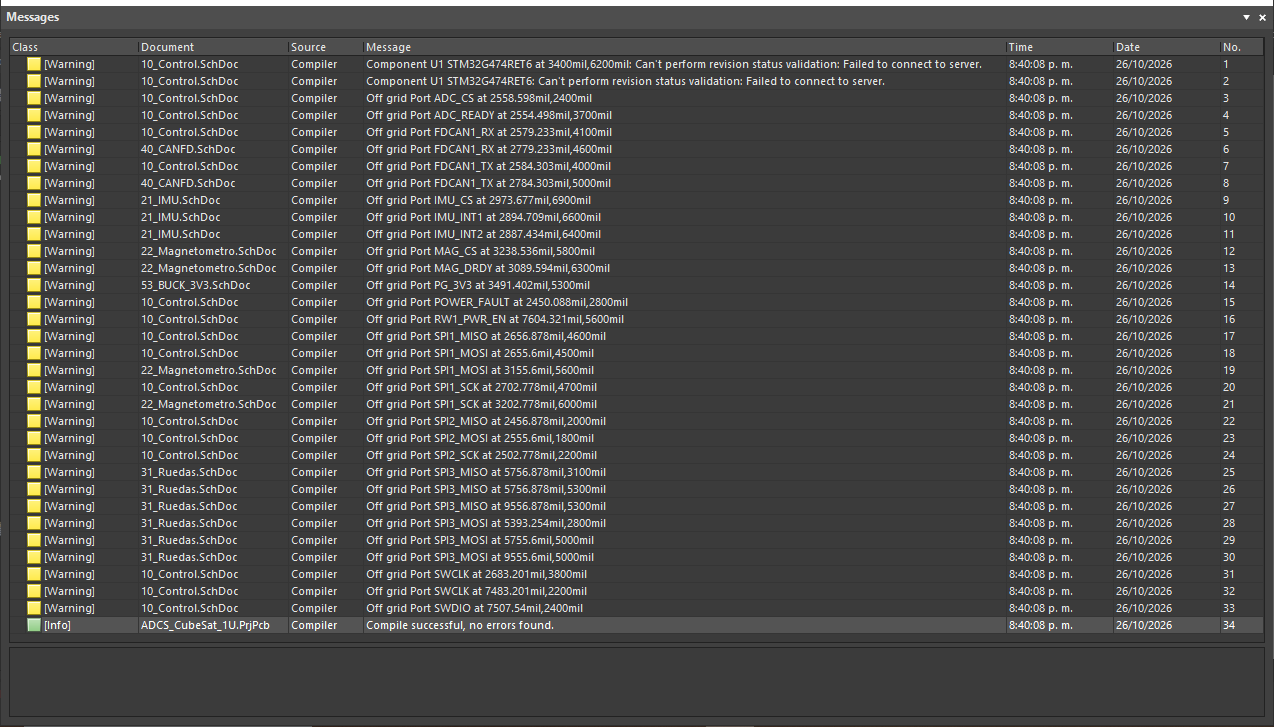
[picture p25: figure]

Fig. 11. Evidencia de validacion ERC y warnings residuales aceptados. ´

La verificacion no equivale a una demostraci ´ | on de fun- ´
cionamiento físico. La guía establece que un esquema sin mensajes de error no demuestra por sí solo que el circuito funcione; por ello, la validacion realizada se interpreta como ´
cierre del diseno esquem ˜ | atico y no como certificaci ´ | on de ´
desempeno. ˜
X. BOM Y ANALISIS DE COSTOS ´
La BOM se genero desde Altium con 62 l ´ | | íneas agrupadas
y un total de 151 componentes por tarjeta. Se incluyeron designadores, descripcion, cantidad, fabricante, MPN exacto, ´ footprint y LibRef. El analisis de costos utiliza solamente ´ componentes de la PCB; no incluye fabricacion, ensamblaje, ´ transporte ni impuestos, de acuerdo con la guía [1].

TABLE XI
RESUMEN DE COSTOS DE COMPONENTES
Lote | Costo lote [USD] | USD/tarjeta | Observacion´
10 | 715.69 | 71.57 | Compra de componentes para 10 tar-
| | | jetas.
100 | 5850.21 | 58.50 | Escalones de cantidad aplicados.
1000 | 49810.60 | 49.81 | Escalones de cantidad y multiplos ´
| | | aplicados.

La reduccion del costo unitario se explica principalmente ´ por los escalones de precio de los componentes de mayor valor. Para el lote de 10 unidades, los mayores contribuyentes son el ADS8166, el STM32G474RET6, el inductor XFL4020, los DRV8833, el eFuse, los OPA4322 y el magnetometro. ´ En lotes grandes, el ADS8166 continua siendo el compo- ´ nente dominante del costo. Esta concentracion implica que ´ una revision futura de alternativas del ADC puede tener un ´ impacto economico considerable, siempre que no se degrade ´ el desempeno requerido. ˜

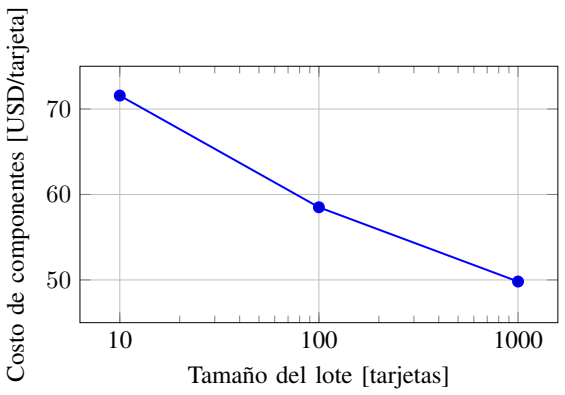
[picture p26: figure]
Costo de componentes [USD/tarjeta]; Tamano del lote [tarjetas] ˜

Fig. 12. Costo estimado de componentes por tarjeta frente al tamano del lote. ˜

La metodología de compra considera MOQ y multiplos ´ cuando se conocen. Los componentes sin precio exacto no se asignan a cero: se marcan como estimados/interpolados. En el
analisis actual, 43 l ´ | íneas tienen precio publicado o exacto y 19
utilizan una estimacion expl ´ | ícita. El MPN generico SMBJ18A ´

permanece con fabricante pendiente. Esta separacion evita ´
presentar una estimacion como una cotizaci ´ | on firme. ´

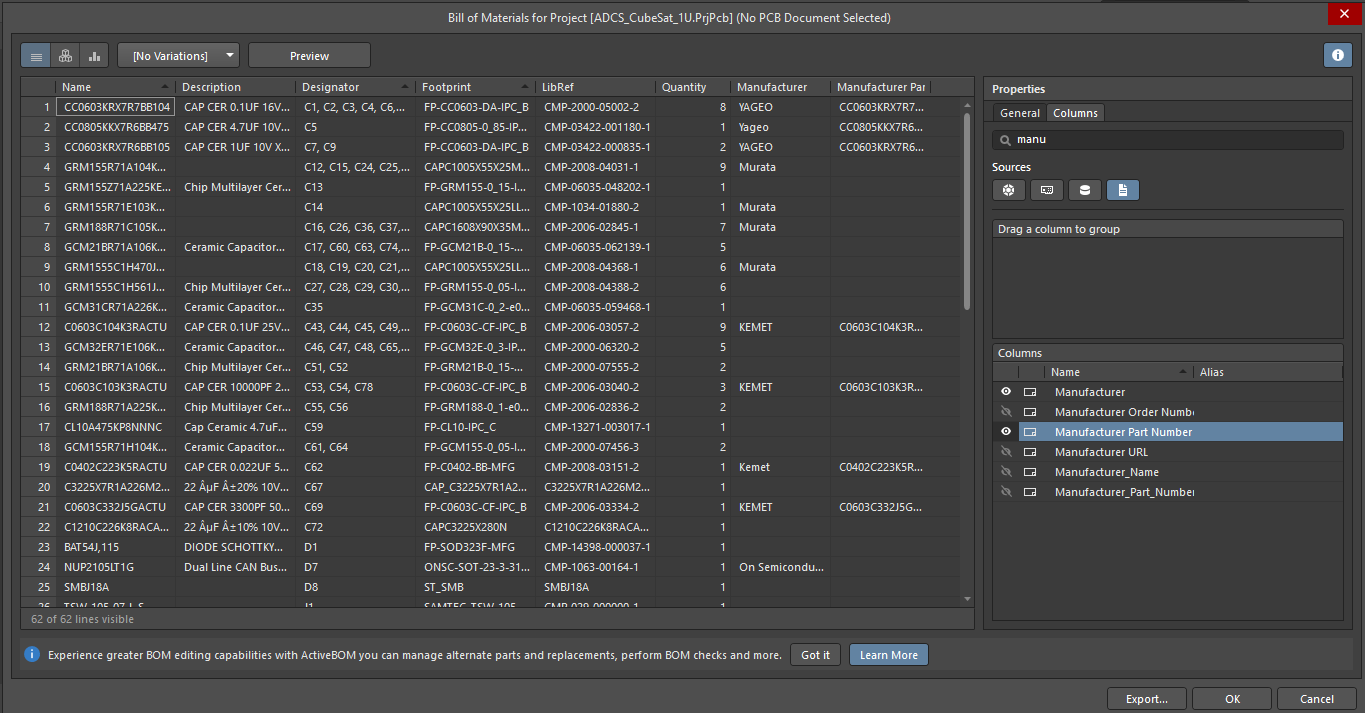
[picture p27: figure]

Fig. 13. Ventana BOM de Altium con fabricante, MPN, footprint, designadores y cantidades.

XI. COHERENCIA DOCUMENTAL Y ASUNTOS PENDIENTES
El cierre de P4 no significa que todos los parametros de ´ diseno f ˜ ísico esten congelados. Permanecen abiertos aquellos ´ que dependen del ICD mecanico de conectores y actuadores, ´ del stackup real, de la geometría del layout o de validaciones experimentales. Los principales son:
- verificar la asignacion definitiva de funciones alternativas ´
del STM32G474, especialmente senales de temporizaci ˜ | on´
para los DRV8833 y ADC READY;
- cerrar el ICD de los conectores de RW0 y CR0002 antes de crear keepouts y posiciones mecanicas; ´
- validar Rf y Cf de los TIA mediante simulacion/ensayo; ´
- verificar el encapsulado y la correspondencia de footprint del DRV8833PWPR antes del layout;
- calcular la caída de tension de las redes de potencia con ´ longitudes reales;
- confirmar el stackup de cuatro capas antes de definir reglas dependientes de impedancia;
- sincronizar el MPN de U12 entre inventario y BOM, ya que el inventario registra TPS26601RHFR y la BOM exportada registra TPS26600RHFR.
El ultimo punto es especialmente importante para la traz- ´ abilidad de fabricacion. El informe adopta como referencia ´ de costos el MPN presente en la BOM exportada, pero el esquematico y el inventario deben ser consistentes antes de la ´ entrega final.
XII. EVIDENCIA DE ORGANIZACION Y REUTILIZACI ´ | ON´

La estructura jerarquica de Altium separa control, sensores, ´
actuadores, alimentacion, adquisici ´ | on y CAN-FD. Esta sepa- ´
racion permite reutilizar bloques funcionales y simplifica la ´
revision. Los componentes seleccionados tienen s ´ | ímbolo y
footprint asociados cuando se dispone de modelo verificado, mientras que los elementos externos como RW0 y CR0002 se representan mediante sus interfaces y conectores, sin convertir
sus modulos mec ´ | anicos en huellas arbitrarias de la PCB. ´
La estrategia de reutilizacion tambi ´ | en se refleja en el ´
uso de buses compartidos con seleccion individual: SPI1 ´
para IMU/magnetometro, SPI3 para las ruedas de reacci ´ | on´
y FDCAN1 para la interfaz externa. Las etapas de potencia se mantienen como bloques independientes para facilitar el
analisis t ´ | ermico y de retorno durante el dise ´ | no f ˜ | ísico.

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
D | D
C | C
B | B
A | A

Title

Size | Number | Revision

A4

Date: | 10/26/2026 | Sheet of
File: | C:\Users\..\00_ADCS_TOP.SchDoc | Drawn By:

CTRL_10
10_Control.SchDoc

SNS_20
20_Sensores.SchDoc

ACTS_30
30_Actuadores.SchDoc

CAN_40
40_CANFD.SchDoc

PWR_50
50_POWER.SchDoc

ADCS ESTRUCTURA PCB

Cannot open file ClipboardPicture24/10/2026 9:08:14 p. m.. File does not exist.

Fig. 14. Vista general de la hoja superior del esquematico ADCS y sus ´ interconexiones jerarquicas. ´

XIII. LIMITACIONES DEL RESULTADO

El diseno corresponde a una soluci ˜ | on acad ´ | emica de captura ´
esquematica y no constituye una demostraci ´ | on de aptitud ´
para vuelo espacial. La guía de P4 establece explícitamente que no se exige enrutar la PCB ni generar archivos de
fabricacion, y que las simplificaciones acad ´ | emicas deben man- ´
tenerse explícitas [1]. Por ello, no se presenta el diseno como ˜ una PCB fabricable o calificada para vuelo.
Asimismo, la seleccion de componentes se realiz ´ | o para ´
cumplir las funciones y facilitar el diseno electr ˜ | onico dentro ´
del alcance academico. La calificaci ´ | on espacial, radiaci ´ | on, vi- ´
bracion, vac ´ | ío, outgassing, confiabilidad de mision y disponi- ´
bilidad de largo plazo requieren analisis espec ´ | íficos que exce-
den esta practica. ´

XIV. CONCLUSIONES

Se completo el dise ´ | no esquem ˜ | atico de una tarjeta ADCS ´
dedicada para un CubeSat 1U. La solucion integra sensores ´ inerciales y magneticos, seis sensores solares con acondi- ´
cionamiento analogico, ADC, memoria no vol ´ | atil, proce- ´
samiento central, tres ruedas de reaccion, tres magnetorquers, ´
drivers de potencia, supervision, protecci ´ | on de entrada, regu- ´
lacion local y una interfaz CAN-FD con la tarjeta principal ´ externa.
La seleccion del STM32G474RET6 se realiz ´ | o despu ´ | es de ´
consolidar los recursos exigidos por los bloques del ADCS. La arquitectura de interfaces utiliza SPI1 para los sensores de actitud, SPI2 para adquisicion solar, SPI3 para las ruedas, ´ I

2C para FRAM y FDCAN1 para la interfaz externa. El
arbol de potencia se cerr ´ | o preliminarmente con +12V ´ | PROT,
+5V ACT, +5V ANA y +3V3, y el presupuesto de diseno se ˜
establecio alrededor de 15 W incluyendo m ´ | argenes. ´

Las restricciones de fabricacion se documentaron tomando ´ PCBWay como referencia y diferenciando claramente los mínimos manufacturables de los objetivos de diseno. Para las ˜ redes de potencia se adoptaron anchos preliminares de 0.20 mm para ramas de hasta 0.65 A y 0.80 mm para la troncal de
1.95 A, quedando la caída de tension para verificaci ´ | on durante ´
el layout.
La validacion el ´ | ectrica y la revisi ´ | on manual permitieron ´
cerrar los errores reales del esquematico y documentar las ´
unicas excepciones residuales. Finalmente, la BOM qued ´ | ó
estructurada con 62 líneas agrupadas y 151 componentes por tarjeta, con costos estimados de USD 71.57, USD 58.50 y USD 49.81 por tarjeta para lotes de 10, 100 y 1000 unidades, respectivamente. El resultado constituye una línea base coherente para continuar con el diseno f ˜ ísico de la PCB.

REFERENCIAS

[1] Universidad de Antioquia, Departamento de Ingeniería Electronica, ´
Practica 4 – Dise ´ | no Electr ˜ | onico y Captura Esquem ´ | atica ´ | , guía sum-
inistrada para el curso, 2026.
[2] V. Gaviria Samboni y S. Zuluaga Correa, P4 ADCS – Entregable
completo, puntos 1–11, hoja de calculo de dise ´ | no, 2026. ˜
[3] STMicroelectronics, STM32G474xx Datasheet and Reference Manual,
documentacion t ´ | ecnica del fabricante. ´
[4] TDK InvenSense, ICM-42670-P Datasheet, documentacion t ´ | ecnica del ´
fabricante.
[5] MEMSIC, MMC5983MA Datasheet, documentacion t ´ ecnica del fabri- ´ cante.
[6] Vishay, BPW34 PIN Photodiode, documentacion t ´ ecnica del fabricante. ´
[7] Texas Instruments, OPA4322 Low-Noise, Rail-to-Rail I/O CMOS Operational Amplifier, documentacion t ´ ecnica del fabricante. ´
[8] Texas Instruments, ADS8166 16-bit, 250-kSPS, 8-Channel SAR ADC, documentacion t ´ ecnica del fabricante. ´
[9] Texas Instruments, DRV8833 Dual H-Bridge Motor Driver, documentacion t ´ ecnica del fabricante. ´
[10] Texas Instruments, TCAN1042HGV High-Speed CAN FD Transceiver,
documentacion t ´ | ecnica del fabricante. ´
[11] Texas Instruments, TPS2660x 60-V eFuse, documentacion t ´ | ecnica del ´
fabricante.
[12] Texas Instruments, TPS62133A-Q1 3-A Step-Down Converter, documentacion t ´ ecnica del fabricante. ´
[13] Texas Instruments, TPS62162 1-A Step-Down Converter, documentacion´ tecnica del fabricante. ´
[14] PCBWay, PCB Capabilities, capacidades de fabricacion consultadas para ´ la practica, 2026. Disponible en: https://www.pcbway.com/capabilities. (https://www.pcbway.com/capabilities.html) ´ html (https://www.pcbway.com/capabilities.html)
