valenjess/CubeSat/P3/README.md

En esta sección se detalla la primera entrega del proyecto CubeSat.

Objetivos:

• Derivar, a partir de la descripción del proyecto, requisitos verificables y especificaciones técnicas que orienten el diseño del hardware electrónico del CubeSat.

• Proponer y comparar alternativas de arquitectura, considerando la distribución de funciones entre hardware y software, la división del sistema en PCBs y las restricciones de potencia, 
de procesamiento, de almacenamiento, de comunicaciones, de masa y de volumen.

• Definir una arquitectura electrónica coherente mediante diagramas de bloques, presupuestos preliminares e interfaces que proporcionen una base suficiente para iniciar el diseño esquemático.

Contenido:

• La hoja de cálculo editable con las matrices, comparaciones y presupuestos.

• Los Diagramas de arquitectura en formato editable y exportados como imagen o en formato PDF.

• Hoja de cálculos para justificar decisiones.

• Las fuentes técnicas consultadas.
