valenjess/CubeSat/P3/Fuentes_Tecnicas_Consultadas_CubeSat_1U.docx

FUENTES TÉCNICAS CONSULTADAS

CubeSat 1U – Monitoreo multiespectral de cultivos de café

Laboratorio 3 – Requisitos, especificaciones y arquitectura electrónica

# 1. Propósito

Este documento reúne las fuentes técnicas utilizadas como base para la definición de requisitos, especificaciones, arquitectura, presupuestos y sustentaciones del Laboratorio 3. Se separan las fuentes entregadas por el curso de las fuentes técnicas externas consultadas.

Los enlaces externos corresponden a páginas oficiales o documentos oficiales de las organizaciones responsables. Las referencias internas se identifican mediante el nombre exacto del archivo y la sección o contenido relevante para que puedan localizarse directamente en el material del proyecto.

# 2. Documentación base proporcionada por el curso

Ref. | Documento | Ubicación / identificación | Uso en el proyecto
INT-01 | lab003_2598575_20262.pdf | Práctica 3 – Requisitos, especificaciones y arquitectura; especialmente descripción, procedimiento y entregables. | Define el método de trabajo, etapas, criterios de requisitos, especificaciones, arquitectura, presupuestos y fuentes que deben utilizarse.
INT-02 | Proyecto CubeSat UD34 2026.pdf | Descripción del proyecto; misión, sistemas electrónicos principales, restricciones y alcance académico. | Fuente primaria de la misión: CubeSat 1U, vida nominal, órbita de referencia, estación en Medellín, cámara multiespectral, energía solar, baterías, ADCS, comunicaciones y ausencia de propulsión.
INT-03 | CDS+REV14_1+2022-02-09.pdf | CubeSat Design Specification Rev. 14.1, Cal Poly SLO; secciones de especificaciones generales y mecánicas. | Sustenta restricciones y criterios CubeSat utilizados en masa/volumen, integración, materiales, venteo y otras condiciones aplicables.
INT-04 | Sustentacion_Especificaciones_Tecnicas_CubeSat(1).docx | Documento de sustentación de especificaciones técnicas; secciones de auditoría, cálculos y fuentes. | Registra la revisión del trabajo previo, correcciones, cálculos preliminares, TBD y trazabilidad utilizada para cerrar la matriz.

# 3. Fuentes técnicas externas oficiales

Ref. | Fuente / referencia | Organización | Localización precisa | Enlace oficial
EXT-01 | ECSS-E-ST-10C Rev.1 – System engineering general requirements (15 February 2017) | European Cooperation for Space Standardization (ECSS) | Documento completo; especialmente requisitos generales de ingeniería de sistemas, especificaciones, arquitectura, trazabilidad y presupuestos técnicos. | https://ecss.nl/standard/ecss-e-st-10c-rev-1-system-engineering-general-requirements-15-february-2017/
EXT-02 | ECSS-E-ST-20C Rev.2 – Electrical and electronic (8 April 2022) | European Cooperation for Space Standardization (ECSS) | Documento completo; requisitos y principios para ingeniería eléctrica, electrónica, EMC, alimentación y equipos electrónicos. | https://ecss.nl/standard/ecss-e-st-20c-rev-2-electrical-and-electronic-8-april-2022/
EXT-03 | CubeSat 101: Basic Concepts and Processes for First-Time CubeSat Developers, Revision dated October 2017 | NASA CubeSat Launch Initiative | Documento completo; conceptos CubeSat, subsistemas, ADCS, interfaces, integración y proceso de desarrollo. | https://science.nasa.gov/wp-content/uploads/2023/06/nasa_csli_cubesat_101_508.pdf
EXT-04 | CubeSat Design Specification Rev. 14.1 | The CubeSat Program, Cal Poly SLO | Sección 1.4 (Non-compliance), 1.6 (terminología normativa), sección 2 (CubeSat Specification), incluidas restricciones generales y mecánicas. | https://www.nasa.gov/kennedy/launch-services-program/cubesat-launch-initiative/cubesat-launch-initiative-resources/
EXT-05 | THEIA – Miniature. Multispectral. Calibrated. | Tartu Observatory Space Exploration Group | Descripción y especificaciones del instrumento THEIA: GSD, FOV, resolución, número de bandas, masa y compatibilidad 1U. | https://tospexgroup.space/projects/theia/
EXT-06 | What are the band designations for the Landsat satellites? | U.S. Geological Survey (USGS) | Tabla de bandas Landsat y rangos espectrales; referencia para la selección y justificación conceptual de bandas de observación. | https://www.usgs.gov/faqs/what-are-band-designations-landsat-satellites
EXT-07 | Sentinel-2 – Instrument | European Space Agency (ESA) | Descripción del instrumento MSI, concepto multiespectral, bandas, red edge, adquisición y datos para observación de vegetación. | https://www.esa.int/Applications/Observing_the_Earth/Copernicus/Sentinel-2/Instrument

# 4. Relación entre las fuentes y las decisiones del proyecto

Tema | Fuentes | Aplicación
Misión y alcance | INT-02 | La descripción oficial del proyecto es la fuente primaria.
Proceso de ingeniería y trazabilidad | INT-01 + EXT-01 | La guía define el procedimiento del laboratorio y ECSS aporta el marco general de ingeniería de sistemas.
Restricciones CubeSat | INT-03 + EXT-03 | CDS Rev. 14.1 y NASA CubeSat 101 sirven como referencias técnicas generales; las condiciones particulares de lanzamiento prevalecerían en una misión real.
Ingeniería eléctrica/electrónica | EXT-02 | Se utiliza como referencia para criterios eléctricos/electrónicos y EMC cuando tienen consecuencia directa en el diseño.
Payload multiespectral | INT-02 + EXT-05 + EXT-06 + EXT-07 | La misión define la necesidad de imagen multiespectral; THEIA aporta un referente de nanosatélite y USGS/ESA aportan contexto espectral y de observación de vegetación.
Cálculos preliminares | INT-04 + fuentes técnicas asociadas | Los cálculos se documentan en la sustentación y se mantienen como exploratorios cuando todavía no corresponden a una especificación cerrada.

# 5. Criterio de uso de fuentes

Las páginas comerciales, blogs y respuestas generadas por herramientas de inteligencia artificial no se utilizaron como sustituto de hojas de datos, normas, artículos técnicos o documentación oficial. Este criterio coincide con la propia guía del laboratorio, que indica que esas fuentes pueden orientar la búsqueda, pero no sustituyen la documentación técnica que sustenta una decisión.

En particular, las fuentes externas de este listado se conservaron porque corresponden a organismos, programas u organizaciones responsables de los documentos o instrumentos descritos. Los documentos INT-01 a INT-04 son los materiales de trabajo del propio curso/proyecto y constituyen la referencia principal para las decisiones específicas de esta práctica.

# 6. Nota sobre enlaces y versiones

Los documentos normativos pueden actualizarse o ser sustituidos por revisiones posteriores. Para esta práctica se conserva la revisión que corresponde a los documentos utilizados durante el desarrollo del Laboratorio 3. En una fase posterior de diseño, cualquier requisito que dependa de una misión de lanzamiento real deberá contrastarse además con el proveedor de lanzamiento y sus requisitos vigentes.

# 7. Referencias web verificadas

- ECSS-E-ST-10C Rev.1: página oficial ECSS con documento y anexos.
- ECSS-E-ST-20C Rev.2: página oficial ECSS con documento y anexos.
- NASA CubeSat Launch Initiative Resources: página oficial que enlaza CubeSat 101 y las CubeSat Design Specifications.
- NASA CubeSat 101: PDF oficial de NASA, revisión de octubre de 2017.
- THEIA: página oficial del Tartu Observatory Space Exploration Group.
- USGS Landsat band designations: página oficial del U.S. Geological Survey.
- ESA Sentinel-2 Instrument: página oficial de la European Space Agency.
