valenjess/CubeSat/P3/Sustentacion_Calculos_CubeSat.docx

CÁLCULOS Y SUSTENTACIÓN TÉCNICA

CubeSat 1U – Monitoreo multiespectral de cultivos de café

Laboratorio 3 – Requisitos, especificaciones y arquitectura

# 1. Objetivo del documento

Este documento reúne los cálculos utilizados para justificar decisiones, relaciones de dimensionamiento y estimaciones preliminares del proyecto. Se ha revisado contra la versión definitiva de la matriz y se separan explícitamente los cálculos que permanecen abiertos de los cálculos exploratorios que no deben interpretarse como valores finales.

La guía solicita que los presupuestos sean consistentes y sustentados y que se entregue cualquier cálculo adicional utilizado para justificar decisiones. Por ello, las ecuaciones de datos, almacenamiento, comunicaciones, potencia, energía, masa, volumen y procesamiento se documentan aquí junto con su trazabilidad.

# 2. Criterio de cierre y control de versiones

La versión definitiva de la matriz mantiene como TBD los parámetros que todavía dependen de la selección de componentes, del plan de observación, del enlace o de la arquitectura detallada. No se introducen valores externos para forzar el cierre de esos parámetros.

Una consecuencia importante de la revisión es que la sustentación anterior no debe presentarse como si 30 m/píxel, las bandas rojo/NIR, 16 bits por muestra o 2.765 MB/imagen fueran especificaciones definitivas. Esos valores se conservan únicamente como cálculos exploratorios auditados, porque la matriz definitiva mantiene ET-02, ET-06 y ET-41–ET-43 abiertos.

# 3. Cadena de cálculo de la arquitectura

La cadena de dependencia utilizada es:

Payload → datos por adquisición → almacenamiento → tiempo de contacto → tasa de bajada → potencia/energía → EPS/batería → procesamiento e interfaces

Esto evita seleccionar memoria, radio, batería u OBC de manera independiente. Los cálculos posteriores deben alimentar las decisiones de arquitectura y mantenerse trazables a las especificaciones correspondientes.

# 4. Cálculos de presupuesto — versión definitiva

ID | Magnitud | Ecuación | Resultado | Trazabilidad | Criterio de cierre
CALC-01 | Datos por imagen | D_img = N_x × N_y × N_bandas × bits/muestra ÷ 8 | TBD | ET-06 | La resolución del sensor, bandas, profundidad radiométrica, formato y eventual compresión todavía deben cerrarse.
CALC-02 | Capacidad de almacenamiento | S_req ≥ D_img × N_capturas_entre_descargas + datos_aux + margen | TBD | ET-07 | No se fija capacidad hasta conocer el volumen por imagen y el número máximo de adquisiciones entre descargas.
CALC-03 | Tasa mínima de bajada | R_min ≥ D_acumulados / t_contacto; posteriormente se incorporan eficiencia y margen | TBD | ET-10 | Depende del volumen acumulado y de la duración efectiva de los pases sobre Medellín.
CALC-04 | Potencia total | P_total = Σ P_subsistemas + pérdidas + margen | TBD | ET-36 / ET-37 | No se adopta como consumo final ninguna cifra de una etapa anterior.
CALC-05 | Energía por modo | E_modo = P_modo × t_modo | TBD | ET-11 / ET-37 | Se requiere el perfil de potencia y duración de cada modo operativo.
CALC-06 | Batería utilizable | E_bat,usable ≥ E_eclipse + margen | TBD | ET-11 / ET-37 | Debe incorporar demanda durante eclipse, eficiencia, profundidad de descarga y margen definido.
CALC-07 | Masa total | M_total = Σ m_componentes + estructura + cableado + margen | ≤ 2.00 kg | ET-12 | La suma real se cerrará cuando existan componentes y distribución física; el límite es una restricción 1U.
CALC-08 | Volumen total | V_total ≤ volumen útil 1U, considerando interfaces, montaje y márgenes | ≤ 1U | ET-13 | La comprobación física se hará con la distribución final de PCB, cámara, batería, radio, antenas y estructura.
CALC-09 | Margen de potencia/energía | P_generación,usable ≥ P_cargas + pérdidas + margen | TBD | ET-27 / ET-36 / ET-37 | El arreglo solar no se dimensiona hasta cerrar el balance energético.
CALC-10 | Margen de procesamiento | Capacidad disponible ≥ demanda prevista × (1 + margen) | TBD | ET-28 / ET-29 | Se cierra con la arquitectura OBC y la carga computacional, memoria y throughput de las interfaces.

# 5. Cálculos exploratorios auditados — NO son especificaciones finales

Estos cálculos provienen de la sustentación previa y se conservan para que quede documentado de dónde salieron determinadas cifras y por qué no se congelaron. No deben utilizarse como valores finales de diseño.

## 5.1 Escalamiento preliminar del GSD

Como ejercicio de referencia se utilizó el valor de 35 m de GSD a 650 km atribuido a THEIA en la sustentación anterior y se escaló proporcionalmente a 550 km:

GSD(550 km) = 35 × (550 / 650) = 29.62 m/píxel ≈ 30 m/píxel.

Estado: EXPLORATORIO. La matriz definitiva no congela 30 m/píxel; ET-02 permanece TBD hasta cerrar cámara, óptica, FOV y criterio de observación.

## 5.2 IFOV asociado al escenario de 30 m/píxel

Para observación nadir y aproximación de ángulo pequeño:

IFOV ≈ GSD / H = 30 / 550000 = 5.454545e-05 rad ≈ 54.5 µrad/píxel.

Estado: EXPLORATORIO. Se utiliza únicamente como condición de diseño preliminar y no como valor final de ET-02/ET-03.

## 5.3 Swath de referencia

Para una cámara con FOV conocido:

Swath = 2H tan(FOV/2)

Usando únicamente como referencia el FOV de THEIA de 2.1° × 2.7° a H = 550 km:

Swath_x = 2(550)tan(2.1°/2) = 20.16 km

Swath_y = 2(550)tan(2.7°/2) = 25.92 km

Resultado exploratorio: aproximadamente 20.2 × 25.9 km. No representa el FOV definitivo de nuestra cámara.

## 5.4 Volumen de datos de un escenario anterior

Se documenta el escenario previamente utilizado de 943 × 733 píxeles, 2 bandas y 16 bits por muestra:

D_img = 943 × 733 × 2 × 16 / 8 = 2764876 bytes ≈ 2.765 MB (decimal).

Estado: EXPLORATORIO. La matriz definitiva mantiene ET-06 como TBD y no congela este volumen.

## 5.5 Periodo orbital y eclipse simplificado

Con radio terrestre R_T = 6378 km, altura H = 550 km y parámetro gravitacional μ = 398600.4418 km³/s²:

r = R_T + H = 6378 + 550 = 6928 km

T = 2π√(r³/μ) = 95.65 min

Para un caso simplificado de eclipse máximo, la aproximación utilizada es t_eclipse = (T/π)·arcsin(R_T/r), que produce 35.61 min.

Estado: EXPLORATORIO. Estos valores sirven para iniciar el presupuesto de energía, pero no cierran ET-08 ni la capacidad de batería; se requiere posteriormente una geometría orbital y una máscara de elevación consistentes con la misión.

## 5.6 Referencia parcial de potencia

En una estimación anterior se sumaron C&DH = 0.46 W, un sensor = 0.04 W y tres magnetorquers de 0.25 W cada uno:

P_parcial = 0.46 + 0.04 + 3(0.25) = 1.25 W

Estado: REFERENCIA PARCIAL. No representa P_total del CubeSat porque faltan cámara, TT&C, otros sensores, pérdidas, conversiones y márgenes, y los componentes aún no están seleccionados. La matriz definitiva mantiene CALC-04 y ET-36/ET-37 abiertos.

# 6. Cálculos que NO deben forzarse en esta etapa

- Latencia de telecomando: depende del OBC, protocolo y carga computacional (ET-01).
- Error de apuntamiento y conocimiento de actitud: dependen de FOV, sensores y estimador ADCS (ET-04 y ET-05).
- Duración efectiva del pase sobre Medellín: requiere máscara de elevación y geometría orbital (ET-08).
- Margen y tasa de enlace: requieren potencia RF, ganancias, pérdidas, sensibilidad, tasa, modulación/codificación y tiempo de contacto (ET-09 y ET-10).
- Batería y potencia solar: requieren perfil de cargas, eclipse, eficiencia, degradación, orientación y margen (ET-11, ET-36 y ET-37).
- Rieles de alimentación, niveles lógicos y protocolos: dependen de los componentes extremos y de la arquitectura final (ET-38 a ET-40).

# 7. Relación con la arquitectura seleccionada

Los cálculos muestran por qué las decisiones de arquitectura no pueden cerrarse de forma independiente. La cámara determina el volumen de datos; ese volumen condiciona almacenamiento y tasa de bajada; la tasa y el sistema TT&C afectan potencia; la potencia y la duración de los modos determinan energía y batería; y la arquitectura C&DH debe disponer de procesamiento, memoria e interfaces suficientes para coordinar estas funciones.

Por tanto, la arquitectura seleccionada mantiene deliberadamente algunos parámetros como TBD. Esto no representa una omisión: cada TBD tiene una dependencia explícita y un próximo paso de cierre.

# 8. Conclusión para el entregable

Con este documento quedan documentadas tanto las relaciones de cálculo utilizadas para el dimensionamiento como las estimaciones exploratorias que dieron origen a cifras anteriores. Las cifras exploratorias están separadas de los valores definitivos para evitar que se interpreten como requisitos congelados.

La versión definitiva debe entenderse como: restricciones cerradas donde existe fundamento documental; TBD justificados donde aún falta una selección o cálculo; y cálculos exploratorios conservados como antecedente auditable.

# 9. Fuentes documentales utilizadas

- lab003_2598575_20262.pdf — guía de la Práctica 3, especialmente presupuestos y revisión interna.
- Proyecto CubeSat UD34 2026.pdf — misión, configuración 1U, órbita de referencia, estación, payload y subsistemas.
- CDS REV14_1 2022-02-09.pdf — restricciones CubeSat de masa, integración, inhibiciones, materiales y venteo.
- ECSS-E-ST-20C-Rev.2 (8 April 2022).pdf — criterios de márgenes de potencia/energía, memoria, throughput y EMC.
- Sustentacion_Especificaciones_Tecnicas_CubeSat(1).docx — sustentación previa y cálculos exploratorios auditados.
- Cubesat_Valentina_Sebastian.xlsx — versión definitiva de matrices, especificaciones, arquitectura y presupuestos.
