valenjess/CubeSat/P3/Informe_LAB3_Diseno.pdf

Documentacion del dise ´ | no conceptual de un ˜

# CubeSat 1U para monitoreo multiespectral de

| cultivos de café

Valentina Gaviria Samboni¹

, Sebastian Zuluaga Correa¹
1Departamento de Ingeniería Electronica y Telecomunicaciones, Programa de Ingenier ´ | ía Electronica, ´
Universidad de Antioquia, Medellín, Colombia C.C. 1005968723 C.C. 1017241237

Abstract—Este documento presenta la documentacion del ´ diseno conceptual de un CubeSat 1U orientado al monitoreo ˜ multiespectral de cultivos de cafe. El trabajo organiza los ´
requisitos de mision, las especificaciones t ´ | ecnicas, la distribuci ´ | on´
de funciones entre hardware y software, las alternativas de
arquitectura, la seleccion de la arquitectura, la divisi ´ | on en tarje- ´
tas electronicas, las interfaces y los presupuestos preliminares. ´ La definicion se mantiene en el nivel conceptual establecido ´ para la Practica 3: las decisiones que pueden cerrarse con la ´ documentacion suministrada se consideran cerradas, mientras ´
que los parametros que dependen de selecci ´ | on de componentes, ´
diseno detallado o informaci ˜ | on todav ´ | ía no definida se conservan
como TBD. Se incluyen calculos de soporte y referencias cuan- ´ titativas de orden de magnitud provenientes exclusivamente de los documentos tecnicos suministrados para el proyecto. ´
Index Terms—CubeSat 1U, diseno conceptual, arquitectura ˜
electronica, monitoreo multiespectral, cultivos de caf ´ | e, requisitos, ´
trazabilidad, ADCS, EPS, C&DH.
I. INTRODUCCION´
El presente trabajo corresponde a la Practica 3 de docu- ´
mentacion y dise ´ | no conceptual de un sistema CubeSat 1U. La ˜
mision considerada tiene como prop ´ | osito realizar monitoreo ´
multiespectral de cultivos de cafe mediante un sistema espacial ´
de pequeno tama ˜ | no, integrando adquisici ˜ | on de im ´ | agenes, ´
procesamiento, almacenamiento, comunicaciones, control de actitud y suministro de energía.
El objetivo de esta etapa no es realizar todavía el disenõ electronico detallado ni seleccionar todos los componentes ´ comerciales. La guía de la practica establece un proceso ´ progresivo que [2] parte de la definicion de requisitos y ´ conduce hacia especificaciones, alternativas, seleccion y ar- ´ quitectura, dejando para etapas posteriores aquellas decisiones que requieren informacion de componentes, hojas de datos o ´ calculos de mayor detalle. ´
En consecuencia, el documento se construye a partir de una
línea base documental unica. El Excel definitivo de la pr ´ | actica ´
constituye la fuente principal para requisitos, especificaciones,
trazabilidad, distribucion HW/SW, alternativas, selecci ´ | on, ar- ´
quitectura, interfaces y presupuestos. Los documentos de
calculos y las fuentes t ´ | ecnicas se utilizan como soporte de las ´
decisiones, sin convertir resultados exploratorios en requisitos cerrados.
Las principales decisiones documentadas son una arquitectura con dos PCBs principales, la separacion entre PCB 1 – ´
EPS y PCB 2 – Avionica, la utilizaci ´ | on de un C&DH central- ´
izado, almacenamiento centralizado, ADCS basado conceptualmente en sensores, estimacion/control y magnetorquers, ´
una camara multiespectral y un enlace TT&C con estaci ´ | on´
terrestre. La arquitectura seleccionada permanece abierta en los aspectos que requieren seleccion posterior de componentes. ´
II. INTERPRETACION DEL PROBLEMA ´ | | , ALCANCE Y
| SUPUESTOS
A. Objetivo de la mision´

La mision se define como un CubeSat 1U para monitoreo ´ multiespectral de cultivos de cafe. El sistema debe permitir ´
la adquisicion de informaci ´ | on de inter ´ | es mediante una carga ´
util multiespectral, almacenar los datos generados, establecer ´
comunicacion bidireccional con una estaci ´ | | on terrestre y man- ´
tener las condiciones de actitud y energía necesarias para la
operacion. Los supuestos base conservados de la descripci ´ | on´
del proyecto son: formato 1U, vida nominal de 6 meses, orbita ´ de referencia aproximadamente circular y heliosíncrona a 550
km, estacion terrestre de referencia en Medell ´ | | ín, camara mul- ´
tiespectral para el analisis experimental de regiones o lotes de ´
cafe, generaci ´ | on mediante paneles solares y almacenamiento ´
en baterías recargables, sensores y actuadores para control de
orientacion, comunicaci ´ | on bidireccional con tierra, ausencia ´
de propulsion, y no implementaci ´ | on del software durante el ´
curso. La estacion terrestre, el veh ´ | ículo de lanzamiento y las
herramientas de analisis agron ´ | omico se consideran elementos ´
externos al alcance de diseno del CubeSat. ˜
B. Alcance de la Practica 3 ´

El alcance comprende la definicion de requisitos, especi- ´
ficaciones tecnicas, trazabilidad, descomposici ´ | | on funcional, ´
alternativas de arquitectura, seleccion de alternativas, arqui- ´ tectura seleccionada, interfaces y presupuestos preliminares.
Tambien comprende la sustentaci ´ | on de los c ´ | alculos utilizados ´
para apoyar las decisiones.
No se considera cerrado en esta etapa la seleccion definitiva ´
de componentes electronicos, el dise ´ | no esquem ˜ | atico completo, ´
el diseno de PCB a nivel de fabricaci ˜ | on, la selecci ´ | on definitiva ´
de camara y ´ | optica, las bandas espectrales concretas, la pro- ´
fundidad radiometrica definitiva, el formato final de imagen, ´

los valores finales de desempeno del ADCS y otros par ˜ | ametros ´
que dependen del diseno detallado. ˜
C. Criterio para parametros TBD ´

Un parametro se conserva como TBD cuando su cierre ´ requiere una decision posterior que no puede sustentarse con ´ la informacion disponible sin introducir supuestos arbitrarios. ´ El TBD no representa una ausencia de trabajo: cada parametro ´ abierto debe relacionarse posteriormente con una decision, ´
calculo, selecci ´ | on de componente o actividad de verificaci ´ | on. ´
| La estrategia de cierre utilizada es:
| Mision´ → Payload → Datos
→ Almacenamiento → TT&C
→ Potencia/Energía → Arquitectura.
| | (1)

Esta secuencia evita seleccionar componentes antes de conocer las necesidades que deben satisfacer.

III. REQUISITOS DEL SISTEMA

La matriz definitiva organiza los requisitos funcionales, no funcionales, ambientales y de restriccion. En el informe se re- ´ sumen aquellos que condicionan directamente la arquitectura; la matriz completa se conserva en el Excel entregable.
Los criterios de aceptacion se plantean mediante revisi ´ | on´
documental, analisis y pruebas posteriores cuando corre- ´
sponda. Los requisitos asociados a parametros todav ´ | ía TBD
no se consideran incumplidos: su cierre es una actividad explícitamente pendiente.

IV. ESPECIFICACIONES TECNICAS Y TRAZABILIDAD ´

Las especificaciones tecnicas traducen los requisitos en ´ parametros verificables. La matriz definitiva distingue entre ´ valores cerrados, criterios cerrados con parametros posteriores ´ TBD y especificaciones completamente TBD.
La trazabilidad se mantiene mediante la cadena:

Requisito → Especificacion´ → Funcion´
→ Arquitectura → Interfaz → Verificacion´ .

(2)

No se conserva como decision definitiva el escenario ex- ´
ploratorio de 30 m/píxel ni una combinacion espec ´ | ífica rojo–
NIR. Dichos valores pueden utilizarse para comprobaciones preliminares, pero la matriz definitiva mantiene GSD, bandas, profundidad radiometrica y formato como TBD. ´
A. ET-35: interfaces críticas

ET-35 se cierra como criterio de arquitectura. El 100% de las interfaces críticas debe documentarse con origen, destino,
senal o protocolo, caracter ˜ | ísticas electricas preliminares y tasa ´
o volumen cuando aplique. El conector físico específico puede permanecer TBD cuando dependa de componentes que todavía no han sido seleccionados.
B. ET-44, ET-45 y ET-46
ET-44 se incorpora para RF-002 y establece la capacidad de
controlar la adquisicion de la c ´ | amara, incluyendo inicio, con- ´
figuracion y finalizaci ´ | on. Las se ´ | nales y el protocolo concreto ˜
permanecen TBD hasta definir la interfaz de la camara. ´ ET-45 se incorpora para RF-008 y establece la capacidad funcional de control de actitud mediante sensores, esti-
macion/control y actuadores. El desempe ´ | no angular cuantita- ˜
tivo permanece TBD.
ET-46 se incorpora para RA-002 y establece una evaluacion´ preliminar de susceptibilidad de componentes críticos al entorno de radiacion y posibles mitigaciones. Los valores cuan- ´ titativos de TID y SEE permanecen TBD hasta la seleccion´
de componentes y el analisis espec ´ | ífico.
V. DISTRIBUCION´ HW/SW
La distribucion funcional identifica qu ´ | e funciones requieren ´
principalmente hardware, cuales requieren software y cu ´ | ales ´
dependen de la interaccion entre ambos. Aunque el software ´ de vuelo no se implementa durante esta practica, sus respon- ´ sabilidades se identifican para dimensionar procesamiento, memoria, almacenamiento, interfaces y temporizacion. ´
El C&DH centralizado concentra las funciones de gestion´ y procesamiento principales. La PCB 1 concentra generacion, ´
almacenamiento, conversion, distribuci ´ | on y protecci ´ | on de en- ´
ergía, mientras que la PCB 2 concentra las funciones de avionica, payload, almacenamiento, ADCS y TT&C. No se ´ fija todavía microcontrolador, frecuencia de reloj, RTOS ni componente específico.

VI. ALTERNATIVAS DE ARQUITECTURA
Las alternativas se construyeron por decisiones arqui-
tectonicas independientes. La comparaci ´ | on busca identificar ´
compromisos entre cumplimiento, complejidad, integracion, ´ potencia, masa/volumen, interfaces y riesgo, sin seleccionar componentes comerciales.
Las subdecisiones sobre paneles fijos/desplegables, filtros, protocolos internos, bandas/frecuencias de TT&C y niveles
logicos/rieles de alimentaci ´ | on se mantienen subordinadas a ´
la arquitectura y permanecen abiertas cuando dependen de seleccion o dimensionamiento posterior. ´
VII. CRITERIOS DE COMPARACION Y SELECCI ´ | ON´

Las alternativas se compararon mediante matrices ponderadas. Los criterios incluyen cumplimiento funcional, complejidad, integracion, potencia, interfaces, masa/volumen, modular- ´ idad, riesgo y distribucion de recursos. Los pesos constituyen ´ una herramienta de decision del equipo y no representan mag- ´ nitudes físicas ni una calificacion universal de las alternativas. ´ La arquitectura resultante es C&DH centralizado, dos PCB, comunicaciones internas centralizadas, payload integrado, EPS centralizado, un enlace TT&C bidireccional condicionado y ADCS basado en magnetorquers. La seleccion de componentes ´ concretos permanece fuera del cierre de esta practica. ´
Las calificaciones de cada matriz fueron acompanadas en el ˜
Excel por una justificacion espec ´ | ífica para ambas alternativas

TABLE I
RESUMEN DE REQUISITOS QUE CONDICIONAN LA ARQUITECTURA
ID | Tipo | Requisito resumido | Prioridad | Criterio de aceptacion / verificaci ´ | on´
RF-001 | Funcional | Recibir, validar, decodificar y ejecutar telecomandos autorizados
provenientes de la estacion terrena. ´
Alta | Analisis de capacidad del C&DH y pos- ´
terior prueba funcional.
RF-002 | Funcional | Iniciar, configurar y finalizar las adquisiciones de la camara multi- ´
| | espectral mediante el sistema de procesamiento. | | Alta | | Arquitectura e interfaces de control iden-
tificadas.
RF-003 | Funcional | Recibir los datos generados por la camara durante una adquisici ´ | on´
| | valida y entregarlos al almacenamiento. ´ | | Alta | | Compatibilidad entre camara, camino de ´
| | | | | | datos y almacenamiento.
RF-004 | Funcional | Almacenar imagenes y metadatos entre oportunidades de descarga sin ´
| | exceder la capacidad disponible. | | Alta | | Presupuesto de almacenamiento con mar-
gen.
RF-005 | Funcional | Gestionar los modos de operacion y sus transiciones. | Alta | M ´ | aquina de estados con modos y condi- ´
ciones de transicion. ´
RF-008 | Funcional | Modificar y estabilizar la orientacion mediante los actuadores selec- ´
| | cionados, sin propulsion. ´ | | Alta | | Arquitectura de sensores, control, actu-
| | | | | | adores, potencia e interfaces.
RF-010 | Funcional | Generar energía mediante paneles solares suficiente para las fases de
| | operacion definidas. ´ | | Alta | | Balance de potencia y energía con mar-
gen.
RF-011 | Funcional | Almacenar energía en baterías recargables para periodos sin gen-
| | eracion y picos de carga. ´
Alta | Presupuesto energetico del peor caso. ´
RF-013 | Funcional | Convertir, distribuir y proteger las tensiones requeridas por los sub-
| | sistemas. | | Alta | | Diagrama de distribucion y presupuesto ´
de potencia.
RF-015 | Funcional | Adquirir imagenes multiespectrales de regiones productoras de caf ´ | e. | Alta | Compatibilidad de c ´ | amara con ADCS, ´
| | | | | | almacenamiento, potencia y comunica-
ciones.
RF-016 | Funcional | Generar telemetría suficiente para supervisar el estado de los subsis-
| | temas. | | Alta | | Matriz de telemetría y variables de estado.
RF-018 | Funcional | Detectar condiciones de fallo relevantes y ejecutar acciones de recu-
| | peracion definidas. ´
Alta | FDIR y maquina de estados. ´
RA-002 | Ambiental | Considerar la susceptibilidad de componentes críticos al entorno de
| | radiacion. ´
Media | Evaluacion preliminar y mitigaciones doc- ´
umentadas.
RR-001 | Restriccion | Mantener el sistema dentro de las restricciones del formato CubeSat ´
| | 1U y del dispensador.
Alta | Verificacion dimensional, de masa e inter- ´
faces.
RR-002 | Restriccion | Especificar las funciones de software sin exigir su implementaci ´ | on´
| | durante esta practica. ´ | | Alta | | Matriz HW/SW completa.
RR-007 | Restriccion | Incorporar al menos tres inhibiciones independientes para transmisi ´ | on´
| | RF.
Alta | Revision del dise ´ | no RF y prueba fun- ˜
cional posterior.

TABLE II
ESPECIFICACIONES TECNICAS ´ | , TRAZABILIDAD Y VERIFICACION´
ID | Req. | Parametro | Valor / unidad | Estado | Fundamento | Verificaci ´ | on´
ET-01 | RF-001 | Ejecucion de telecomando | TBD ms | TBD | Depende de OBC, protocolo y temporizaci ´ | on. | An ´ | alisis/prueba ´
ET-02 | RF-015 | GSD | TBD m/píxel | TBD | Depende de camara, ´ | optica y FOV. | An ´ | alisis ´
ET-03 | RF-015 | Swath | TBD | TBD | Depende de FOV y geometría. | Analisis ´
ET-04 | RF-009 | Error de apuntamiento | TBD◦ | TBD | Se deriva de FOV y desempeno ADCS. | An ˜ | alisis/prueba ´
ET-05 | RF-007/RF-008 | Conocimiento de actitud | TBD◦ (3σ) | TBD | Depende de sensores y estimador. | Analisis/prueba ´
ET-06 | RF-003/RF-004 | Datos por imagen | TBD MB/imagen | TBD | Depende de resolucion, bandas, bits y formato. | An ´ | alisis ´
ET-07 | RF-004 | Almacenamiento | TBD MB/GB | TBD | Depende de datos y capturas entre descargas. | Analisis ´
ET-08 | RF-004/RF-015 | Pase efectivo sobre Medellín | TBD min/pase | TBD | Requiere geometría orbital y mascara. | An ´ | alisis ´
ET-10 | RF-004 | Tasa de bajada | TBD kbps | TBD | Depende de datos, contacto y eficiencia. | Analisis ´
ET-11 | RF-011 | Batería mínima | TBD Wh | TBD | Depende de perfil de carga, eclipse y margen. | Analisis ´
ET-12 | RR-001 | Masa maxima ´ | ≤ 2.00 kg | Cerrado | Restriccion CubeSat 1U suministrada. | Inspecci ´ | on´
ET-13 | RR-001 | Envolvente 1U | Segun CDS/dispensador | Cerrado | Restricci ´ | on geom ´ | etrica. | Inspecci ´ | on´
ET-27 | RNF-003 | Margen potencia/energía | ≥ 5% | Cerrado | Criterio de dimensionamiento adoptado. | Analisis ´
ET-35 | RF/RNF | Interfaces críticas documentadas | 100% | Cerrado | Origen, destino, senal/protocolo, el ˜ | ectricos y ´
tasa/volumen.

Inspeccion´

ET-44 | RF-002 | Control de adquisicion de c ´ | amara | Capacidad funcional | Cerrado | Inicio, configuraci ´ | on y finalizaci ´ | on; protocolo ´
TBD.

Analisis/prueba ´

ET-45 | RF-008 | Control de actitud | Capacidad funcional | Cerrado | Sensores, control y actuadores; desempeno TBD. | An ˜ | alisis/prueba ´
ET-46 | RA-002 | Evaluacion preliminar de radiaci ´ | on | Actividad requerida | Cerrado | Susceptibilidad y mitigaciones. | An ´ | alisis ´

y para cada criterio. Los criterios y pesos se definieron para
cada decision de forma independiente; las restricciones obli- ´
gatorias no se compensan mediante otros criterios y los TBD permanecen abiertos cuando la documentacion no permite ´ cerrarlos.

VIII. ARQUITECTURA SELECCIONADA Y DIVISION EN ´
PCBS

La arquitectura seleccionada se organiza en dos tarjetas principales, de acuerdo con la matriz definitiva del proyecto. [1]

A. PCB 1 – EPS
La PCB 1 concentra generacion/entrada solar, gesti ´ | on de ´
batería, conversion, distribuci ´ | on, protecci ´ | on y supervisi ´ | on de ´
potencia. La batería pertenece funcionalmente al EPS y la
alimentacion hacia la avi ´ | onica se realiza mediante IF-03. ´
B. PCB 2 – Avionica ´

La PCB 2 integra C&DH, almacenamiento, interfaces de payload, ADCS, EPS y TT&C. El C&DH actua como coor- ´ dinador central; los protocolos concretos se definiran posteri- ´ ormente.

TABLE III
DISTRIBUCION FUNCIONAL ´ | HW/SW
ID | Funcion | Impl. | Recursos HW | Responsabilidad SW futura | Recursos / observaci ´ | on´

HW/SW-01

Recepcion, decodificaci ´ | on y eje- ´
cucion de telecomandos ´
| | HW+SW | Unidad de procesamiento, inter- faz TT&C, memoria/buffers.
Recepcion, validaci ´ | on, identifi- ´
cacion, ejecuci ´ | on y confirmaci ´ | on. ´
Procesamiento | medio;
buffers y registros.
HW/SW-02
Gestion de modos, detecci ´ | on y recu- ´
| peracion de fallos ´ | HW+SW | C&DH y senales de EPS, ADCS, ˜ payload, almacenamiento y co- municaciones.
Maquina de estados, detecci ´ | on, ´
| | | | modo seguro, recuperacion y re- ´ porte. | | Procesamiento medio; esta-
dos y parametros. ´

HW/SW-03

Determinacion/estimaci ´ | on de actitud | HW+SW | Sensores, | adquisici ´ | on/interfaz, ´
| | | procesamiento y alimentacion. ´
Adquisicion, | validaci ´ | on, ´
estimacion/fusi ´ | on y actualizaci ´ | on´
| | | | de actitud. | | Procesamiento medio/alto.

HW/SW-04

Control de actitud | HW+SW | Actuadores, | drivers,
procesamiento e interfaces.

Calculo de error, algoritmo de ´ control y comandos a actuadores.

Procesamiento medio/alto.

HW/SW-05

Gestion y supervisi ´ | on de potencia | HW+SW | Solar, bater ´ | ía, carga, conversion, ´
distribucion, | protecci ´ | on | y ´
medicion. ´
Supervision, adquisici ´ | on, estados, ´
anomalías y coordinacion con ´ modo seguro.

Procesamiento bajo/medio.

HW/SW-06

Control y adquisicion de im ´ | agenes ´
multiespectrales
HW+SW | Camara, ´ | optica, elementos espec- ´
trales, interfaz, alimentacion y ´ camino de datos.
Configuracion, | ini- ´
cio/finalizacion, | recepci ´ | on | y ´
entrega al almacenamiento.

Procesamiento medio/alto;
almacenamiento alto.

HW/SW-07

Gestion y almacenamiento de datos | HW+SW | Memoria no vol ´ | atil, interfaz, ali- ´
mentacion y protecci ´ | on. ´

Lectura, escritura, organizacion, ´ espacio, integridad y preparacion´ para transmision. ´

Almacenamiento
alto/crítico.

HW/SW-08

Comunicacion TT&C | HW+SW | Transceptor(es), antena(s), RF, in- ´
terfaz digital y alimentacion. ´
Protocolo, | framing,
transmision/recepci ´ | on, comandos, ´
telemetría y datos.
Buffers | de | trans-
mision/recepci ´ | on. ´

HW/SW-09

Adquisicion | y | generaci ´ | on | de ´
telemetría
HW+SW | Canales de tension, corriente, ´
temperatura y estados.
Adquisicion, | conversi ´ | on, ´
validacion, | empaquetado | y ´
reporte.

Procesamiento bajo/medio.

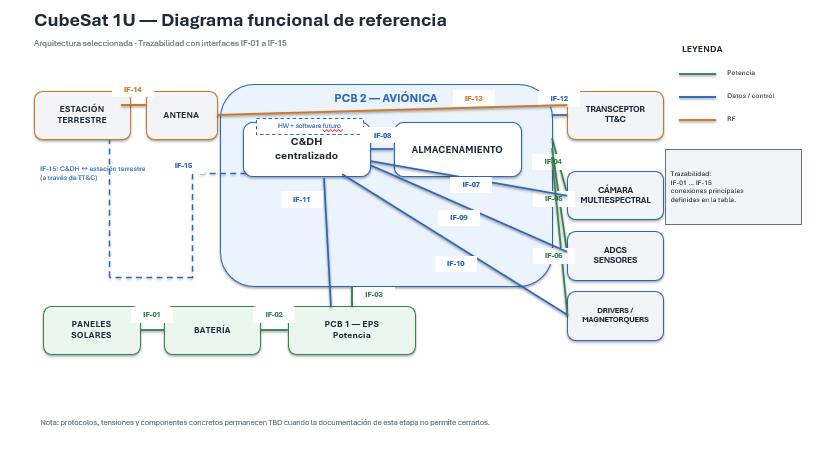
[picture p28: figure]

Fig. 1. Diagrama funcional de referencia de la arquitectura seleccionada.

IX. INTERFACES DEL SISTEMA

Las interfaces IF-01 a IF-15 representan las conexiones funcionales principales de la arquitectura. Los protocolos, niveles
electricos, tensiones y tasas que dependen de componentes a ´ | un´
no seleccionados permanecen TBD, de acuerdo con ET-35. IF-03 es la interfaz crítica de alimentacion entre las dos ´
tarjetas. IF-11 representa el enlace logico de supervisi ´ | on y ´
posibles comandos entre C&DH y EPS. IF-10 conecta directamente C&DH con los drivers de los magnetorquers. La tabla mantiene como TBD los parametros que dependen de ´ componentes aun no seleccionados. ´
X. PRESUPUESTOS PRELIMINARES Y CALCULOS DE ´

SOPORTE

Los presupuestos se mantienen en el nivel preliminar requerido para la practica. Los valores que dependen de deci- ´ siones todavía abiertas se conservan como TBD; por tanto, las tablas no representan todavía un dimensionamiento final de componentes.

A. Presupuesto preliminar de potencia y recursos
B. Presupuesto de informacion´
C. Relaciones de calculo y trazabilidad ´
La relacion general para el volumen de una imagen es: ´

Dimg = NxNyNb

b
8
, | (3)

donde Nx y Ny son las dimensiones de la imagen, Nb el
numero de bandas y ´ | b la profundidad en bits por muestra.
La capacidad de almacenamiento requerida se expresa como:
Sreq ≥ DimgNcapturas + Daux + M, | (4)

donde M representa el margen correspondiente.
La tasa mínima de bajada puede plantearse como:

Rmin ≥

Dacumulados

tcontacto

| , | (5)
para despues incorporar eficiencia de protocolo, codificaci ´ | on, ´
modulacion, p ´ | erdidas y margen. ´
La potencia total se representa mediante:

Ptotal =

∑︂Psubsistemas + Pperdidas + Pmargen, (6)

y la energía de cada modo mediante:

Emodo = Pmodotmodo. | (7)

Para la batería se utiliza como criterio conceptual:

Ebat,usable ≥ Eeclipse + Emargen. | (8)

Para masa y volumen se mantienen las restricciones:

Mtotal ≤ 2 kg, | Vtotal ≤ V1U, util. | (9)

TABLE IV
ALTERNATIVAS PRINCIPALES CONSIDERADAS
ID | Decision | Alternativa | Ventajas principales | Limitaciones / compromisos ´
A-01 | Procesamiento | C&DH centralizado | | Menor cantidad de procesadores y menor com-
plejidad de sincronizacion. ´
| | | | | | Mayor concentracion de funciones e in- ´
terfaces en C&DH.
A-02 | Procesamiento | C&DH central + procesamiento local
Distribuye carga y permite tareas locales. | Anade | electr ˜ | onica, | sincronizaci ´ | on, ´
FDIR e interfaces.
A-03 | HW/PCB | Arquitectura integrada de 2 PCB | Menos tarjetas y conectores; integracion directa. | Mayor densidad electr ´ | onica y concen- ´
tracion funcional. ´
A-04 | HW/PCB | Arquitectura modular de 3 o mas´ PCB
Mayor modularidad y separacion de dominios. | M ´ | as conectores, interconexiones y com- ´
plejidad.
A-05 | Comunicaciones internas | Organizacion centralizada | Estructura sencilla y coordinaci ´ | on central. | Mayor concentraci ´ | on de interfaces y ´
trafico en C&DH. ´
A-06 | Comunicaciones internas | Organizacion modular | Mayor modularidad y posibilidad de distribuir ´
trafico. ´
Mayor | arbitraje, | sincronizacion | y ´
gestion de fallos. ´
A-07 | Payload | Payload integrado | Menor electronica independiente y coordinaci ´ | on´
sencilla.
| | | | | | Mayor dependencia del C&DH y carga
central de datos.
A-08 | Payload | Electronica local | Descarga tareas del C&DH y permite preproce- ´
samiento local.
Mas electr ´ | onica, consumo e interfaces ´
de datos.
A-09 | EPS | Distribucion centralizada | Menor cantidad de bloques y supervisi ´ | on cen- ´
tralizada.
| | | | | | Mayor concentracion funcional en EPS. ´
A-10 | EPS | Modular/distribuido | Flexibilidad y posible aislamiento por carga. | Mas convertidores, componentes y com- ´
plejidad.
A-11 | TT&C | Un enlace bidireccional | | Menor hardware, consumo potencial y comple-
jidad.
| | | | | | La misma cadena atiende operacion y ´
datos de payload.
A-12 | TT&C | Enlaces diferenciados | Permite separar trafico cr ´ | ítico y datos de carga
util. ´
Mayor | hardware | RF, | consumo,
| | | | | | masa/volumen e integracion. ´
A-13 | ADCS | Activo con magnetorquers | Menor complejidad mecanica y ausencia de ´
actuadores rotativos.

Desempeno condicionado por campo ˜
magnetico y din ´ | amica orbital. ´
A-14 | ADCS | Magnetorquers + actuacion iner- ´ cial | | Mayor capacidad y flexibilidad potencial de
control.
| | | | | | Mayor masa, consumo, complejidad y
partes moviles. ´

TABLE V
RESULTADOS DE LAS COMPARACIONES Y DECISIONES DE ARQUITECTURA
ID | Decision | Puntaje A | Puntaje B | Resultado y condici ´ | on´
8.1 | Procesamiento | 4.60 | 3.60 | A-01, C&DH centralizado. Puede reabrirse si el dimensionamiento
posterior demuestra insuficiencia.
8.2 | Division HW/PCB | 4.10 | 4.00 | A-03, 2 PCB. El layout debe preservar dominios de potencia, digital, ´
camara, memoria y RF. ´
8.3 | Comunicaciones internas | 4.35 | 3.55 | A-05, organizacion centralizada. El protocolo concreto permanece TBD. ´
8.4 | Payload | 4.60 | 3.80 | A-07, payload integrado. Puede reabrirse si la carga supera la capacidad
razonable del C&DH.
8.5 | EPS | 4.40 | 3.95 | A-09, distribucion centralizada. No define todav ´ | ía paneles fijos o
| | | | desplegables.
8.6 | TT&C | 4.40 | 3.80 | A-11, un enlace bidireccional condicionado. Debe validarse con datos,
pases y tasa de bajada.
8.7 | ADCS | 4.60 | 3.40 | A-13, magnetorquers. El desempeno final debe demostrarse posterior- ˜
| | | | mente.

TABLE VI
DIVISION F ´ | ÍSICA DE LA ARQUITECTURA
Elemento | PCB | Justificacion´
Generacion y gesti ´ | on´
de potencia
PCB 1 – EPS | Separa la gestion de potencia y con- ´
centra conversion, distribuci ´ | on y pro- ´
teccion. ´
Batería / interfaz de
batería

PCB 1 – EPS Pertenece funcionalmente al sistema de potencia.
C&DH | PCB | 2 | –
| Avionica ´

Nucleo de procesamiento y coordi- ´ nacion del sistema. ´
Almacenamiento | PCB | 2 | –
| Avionica ´

Proximo al procesamiento y al flujo de ´ datos del payload.
Interfaces de camara | PCB | 2 | – ´
| Avionica ´

Proximas al procesamiento y almace- ´ namiento; requieren atencion a integri- ´ dad de senal. ˜
Interfaces ADCS | PCB | 2 | –
| Avionica ´

Centralizan adquisicion de sensores y ´ control de actuacion. ´
Interfaz TT&C | PCB | 2 | –
| Avionica ´

Centraliza comunicaciones y conexion´ al sistema RF/antena.

D. Calculos exploratorios auditados ´

Se conserva un escenario exploratorio de 943×733 píxeles, dos bandas y 16 bits por muestra, que produce aproximadamente 2.765 MB por imagen. Este resultado no cierra ET-
06 porque resolucion, n ´ | umero de bandas, profundidad ra- ´
diometrica y formato contin ´ | uan TBD. ´
Con parametros orbitales de referencia utilizados previa- ´ mente se estimaron aproximadamente 95.65 min de período orbital y 35.61 min de eclipse maximo simplificado. Estos ´ valores sirven como orden de magnitud para iniciar el presupuesto energetico, pero no sustituyen el escenario orbital ´ requerido para cerrar ET-08 y el dimensionamiento de batería.
Un calculo parcial de referencia utiliz ´ | o 0.46 W para C&DH, ´
0.04 W para un sensor y 0.25 W por cada uno de tres magnetorquers, obteniendo 1.25 W. Esta cifra se conserva
unicamente como referencia parcial porque faltan c ´ | amara, ´
TT&C, otros sensores, perdidas y m ´ | argenes, y no se han ´

TABLE VII
INTERFACES FUNCIONALES IF-01 A IF-15
ID | Origen | Destino | Funcion | Tipo | Se ´ | nal/protocolo | El ˜ | ectricas | Tasa/observaciones ´
IF-01 | Paneles solares | PCB 1 – EPS | Entrada de energía generada | Potencia | Interfaz electrica | TBD | V/I TBD; panel no selec- ´
cionado.
IF-02 | Batería | PCB 1 – EPS | Almacenamiento y entrega de
energía
| | | | | | | Potencia | | Interfaz de batería | TBD | | V/I TBD; batería no selec-
cionada.
IF-03 | PCB 1 – EPS | PCB 2 – Avionica | Alimentaci ´ | on de avi ´ | onica | Potencia | Riel(es) de alimentaci ´ | on | TBD | V/I TBD; rieles no congela- ´
dos.
IF-04 | PCB 2 – Avionica | C ´ | amara multiespectral | Alimentaci ´ | on de c ´ | amara | Potencia | Interfaz el ´ | ectrica | TBD | V/I TBD; depende de c ´ | amara. ´
IF-05 | PCB 2 – Avionica | ADCS / sensores | Alimentaci ´ | on de sensores | Potencia | Interfaz el ´ | ectrica | TBD | V/I TBD; sensores no selec- ´
cionados.
IF-06 | PCB 2 – Avionica | ADCS / actuadores | Alimentaci ´ | on de actuaci ´ | on | Potencia | Interfaz el ´ | ectrica | TBD | V/I/pulsos TBD; actuadores ´
no seleccionados.
IF-07 | C&DH | Camara multiespectral | Configuraci ´ | on, disparo y re- ´
cepcion´
| | | | | | | Datos/control | | Protocolo TBD | Niveles TBD | | Volumen TBD; depende de
camara. ´
IF-08 | C&DH | Almacenamiento | Escritura/lectura de imagenes ´
y datos
| | | | | | | Datos | | Protocolo TBD | Niveles TBD | | Volumen TBD; memoria no
seleccionada.
IF-09 | Sensores ADCS | C&DH | Mediciones | para
| | | | | determinacion de actitud ´ | | Datos | | Protocolo TBD | Niveles TBD | | Tasa TBD; sensores no selec-
cionados.
IF-10 | C&DH | Drivers / magnetorquers | Comandos de actuacion | Control | Interfaz TBD | Niveles TBD | Tasa TBD; driver no selec- ´
cionado.
IF-11 | C&DH | PCB 1 – EPS | Supervision y posibles coman- ´
| | | | | dos de potencia | | Datos/control | | Protocolo TBD | Niveles TBD | | Tasa TBD; control se detallara.´
IF-12 | C&DH | Transceptor TT&C | Telemetría, comandos y datos
| | | | | de payload | | Datos/control | | Interfaz TBD | Niveles TBD | | Tasa TBD; radio no selec-
cionado.
IF-13 | Transceptor TT&C | Antena | Transmision/recepci ´ | on RF | RF | Interfaz RF TBD | RF TBD | Tasa TBD; frecuencia no cer- ´
rada.
IF-14 | Antena | Estacion terrestre | Enlace TT&C | RF | Enlace inal ´ | ambrico TBD | RF TBD | Tasa TBD; estaci ´ | on externa. ´
IF-15 | C&DH | Estacion terrestre, v ´ | ía TT&C | Comandos y telemetría de sis-
tema
Datos/control | A traves de TT&C | N/A en tramo l ´ | ogico | Tasa TBD; conexi ´ | on l ´ | ogica ex- ´
tremo a extremo.

TABLE VIII
PRESUPUESTO PRELIMINAR DE POTENCIA Y RECURSOS
ID | Subsistema | Pnom | Pmax | Ciclo | Energía | Masa | Volumen | Fuente / estado
P10-01 | C&DH / OBC | TBD | TBD | Alta / segun modo | TBD | TBD | TBD | Arquitectura ´
+ | avionica; ´
TBD | por
OBC, | memoria,
interfaces | y
temporizacion. ´
P10-02 | EPS | TBD | TBD | Continua | TBD | TBD | TBD | Proyecto | +
arquitectura EPS
+ potencia; TBD
por | conversion, ´
distribucion | y ´
proteccion. ´
P10-03 | ADCS / sensores | TBD | TBD | Variable | TBD | TBD | TBD | Arquitectura
ADCS + GNC;
sensores | y
parametros ´
electricos TBD. ´
P10-04 | Magnetorquers | TBD | TBD | Intermitente | TBD | TBD | TBD | GNC
suministrado;
torque, actuador
y driver TBD.
P10-05 | Payload / camara | TBD | TBD | Adquisici ´ | on | TBD | TBD | TBD | Proyecto + matriz ´
definitiva; GSD,
bandas, formato,
datos y potencia
TBD.
P10-06 | Almacenamiento | TBD | TBD | Adquisicion / descarga | TBD | TBD | TBD | Matriz definitiva ´
+ C&DH; capacidad depende de
datos y descargas.
P10-07 | TT&C | TBD | TBD | Pases / transferencia | TBD | TBD | TBD | Proyecto + SOA
suministrado;
enlace
condicionado.
P10-08 | Batería | TBD | TBD | Carga/descarga | TBD | TBD | TBD | EPS + matriz; de-
pende de potencia, eclipse y margen.
P10-09 | Generacion solar | TBD | TBD | Iluminaci ´ | on | TBD | TBD | TBD | EPS + potencia; ´
depende de iluminacion, p ´ erdidas y ´
margen.
P10-10 | Estructura / integracion | – | – | – | – | TBD | TBD | Restricci ´ | on´
1U/CDS; depende
de componentes,
PCB y cableado.

TABLE IX
PRESUPUESTO PRELIMINAR DE INFORMACION PARA PAYLOAD Y COMUNICACIONES ´
ID | Fuente | Datos/adquisicion | Adquisiciones | Volumen | Almacenamiento | Tasa m ´ | ínima | Fuente | /
estado
D10-01 | Camara multiespectral | TBD MB/imagen | TBD | TBD MB | TBD MB/GB | TBD kbps | ET-06– ´
ET-10;
resolucion, ´
bandas,
bits,
formato,
compresion, ´
capturas y
contacto.
D10-02 | Telemetría | TBD | TBD | TBD | TBD | TBD | Arquitectura
C&DH/TT&C;
variables y
frecuencia
TBD.
D10-03 | Telecomandos / ACK | TBD | TBD | TBD | No aplica como payload | TBD | Arquitectura
C&DH/TT&C;
latencia
depende
de OBC,
protocolo
y carga.

seleccionado componentes.

E. Trazabilidad del presupuesto

TABLE X
TRAZABILIDAD DE LOS PRESUPUESTOS
Elemento | Estado | Proximo cierre ´
Camara | TBD | Seleccionar c ´ | amara/ ´ | optica y cerrar ´
GSD, datos e interfaz.
Almacenamiento | TBD | Definir capturas entre descargas y ca-
| | pacidad.
TT&C | Condicionado | Cerrar pase, volumen de datos y tasa
antes del transceptor.
ADCS | Condicionado | Cerrar sensores, estimador, actuadores
| | y desempeno. ˜
EPS | TBD | Cerrar perfil de potencia, energía,
batería y generacion solar. ´
Masa/volumen | Restriccion | Actualizar | al | seleccionar ´
| | componentes.
F. Referencias cuantitativas de orden de magnitud
Los siguientes datos se incorporan unicamente como refer- ´ encias documentales de escala y no constituyen seleccion de ´ componentes.

TABLE XI
REFERENCIAS CUANTITATIVAS DE ORDEN DE MAGNITUD
Area | Referencia documental | Dato ´
Procesamiento | NASA SOA 2026, Table 8-4 – C3S
| Electronics OBC

0.46 W

Procesamiento | NASA SOA 2026, Table 8-4 – Alen´
| Space DARA OBC

0.28 W maximo ´

ADCS | NASA SOA 2026, Table 5-4 – NewS-
pace Systems NCTR-M003

0.25 W

ADCS | NASA SOA 2026, Table 5-4 – ZARM
| Technik MT0.2-1

0.135–0.25 W

EPS | NASA SOA 2026, Table 3-8 –
| GomSpace P31U

30 W maximo; 96% ´
eficiencia maxima ´
Comunicaciones | NASA SOA 2025, Table 9-3 – ISIS-
| PACE TRXVU

9.6 kbps mínimo

Comunicaciones NASA SOA 2025, Table 9-3 –
NanoAvionics SatCOM UHF

2.4–38.4 kbps

Los valores anteriores se utilizan unicamente como com- ´ probaciones de orden de magnitud obtenidas de los documentos SOA suministrados. No representan componentes seleccionados, no sustituyen el presupuesto propio y no cierran especificaciones TBD.

XI. RIESGOS, LIMITACIONES Y ASUNTOS PENDIENTES

Los principales asuntos pendientes son la seleccion de ´
camara y ´ | optica, GSD, swath, bandas espectrales, profundidad ´
radiometrica, formato de imagen, almacenamiento final, tasa ´
de bajada, desempeno del ADCS, rango t ˜ | ermico, rieles de ´
alimentacion, niveles l ´ | ogicos, protocolos internos y selecci ´ | on´
de componentes.
El entorno de radiacion se incorpora mediante ET-46 como ´ actividad preliminar. La evaluacion se plantea al nivel re- ´
querido para esta practica y no como certificaci ´ | on espacial. ´
[6] El analisis cuantitativo de TID y SEE debe realizarse una ´ vez seleccionados los componentes críticos.
La arquitectura ADCS A-13 tambien requiere un an ´ | alisis de ´
desempeno para verificar que los magnetorquers y los sensores ˜ seleccionados permitan cumplir los objetivos de actitud que finalmente se definan.
La principal limitacion de esta etapa es que varios ´
parametros dependen de componentes a ´ | un no seleccionados. ´
Forzar valores definitivos introduciría supuestos que no estan´ respaldados por la documentacion suministrada. ´

XII. FUENTES TECNICAS Y TRAZABILIDAD DOCUMENTAL ´

La lista completa de fuentes tecnicas consultadas se entrega ´ como documento de soporte independiente, con identificacion, ´ localizacion precisa y enlaces oficiales. Las principales famil- ´ ias documentales utilizadas son:
- Documento de proyecto Proyecto CubeSat UD34 2026.
- Guía de la Practica 3: ´ | lab003 2598575 20262.
- CubeSat Design Specification Rev. 14.1.
- Documentos ECSS suministrados para requisitos y disenõ electrico. ´
- NASA Small Spacecraft State of the Art 2026: potencia, GNC y avionica. ´
- NASA Small Spacecraft State of the Art 2025: comunicaciones.

- NASA CubeSat 101 y documentacion de integraci ´ | on sum- ´
inistrada.
Las referencias cuantitativas comerciales incluidas en los presupuestos son unicamente referencias de orden de mag- ´
nitud. La seleccion definitiva y la consulta sistem ´ | atica de ´
hojas de datos corresponden a la etapa posterior de disenõ electronico. ´

XIII. CONCLUSIONES
La Practica 3 establece una l ´ | ínea base coherente para el
diseno conceptual de un CubeSat 1U destinado al monitoreo ˜
multiespectral de cultivos de cafe. La documentaci ´ | on integra ´
requisitos, especificaciones, trazabilidad, distribucion HW/SW, ´ alternativas, seleccion, arquitectura, interfaces y presupuestos ´ preliminares.
La arquitectura seleccionada se organiza en una PCB de EPS y una PCB de avionica, con C&DH centralizado, al- ´ macenamiento, camara multiespectral, ADCS y TT&C. La ´ definicion de interfaces IF-01 a IF-15 permite mantener la traz- ´ abilidad entre los bloques funcionales y las especificaciones.
Los parametros que dependen de selecci ´ | on de componentes ´
o de analisis detallados se mantienen expl ´ | | | | | | ícitamente como
TBD. De esta forma, el resultado de esta practica constituye ´ una línea base de diseno conceptual sin adelantar decisiones ˜ que corresponden a etapas posteriores.

REFERENCIAS

[1] Proyecto CubeSat UD34 2026, documento de proyecto suministrado para la Practica 3, 2026. ´
[2] Practica 3 – Requisitos, especificaciones y arquitectura electr ´ | onica ´ | , guía
suministrada para el curso, 2026.
[3] Cal Poly SLO, CubeSat Design Specification Rev. 14.1, 2022. Disponible en: https://www.cubesat.org/cds-announcement
[4] European | Cooperation | for | Space | Standardization, | ECSS-E-ST-
20C | Rev. | 2, | 2022. | Disponible | en: | https://ecss.nl/standards/
ecss-e-st-20c-rev-2-electrical-and-electronic-engineering/ (https://ecss.nl/standards/ecss-e-st-20c-rev-2-electrical-and-electronic-engineering/)
[5] European Cooperation for Space Standardization, ECSS-E-ST-20-07C Rev. 2, 2022.
[6] European Cooperation for Space Standardization, ECSS-Q-ST-70-12C Rev. 1, 2025.
[7] NASA, Small Spacecraft State of the Art – Power Systems, 2026. Documento suministrado para el proyecto.
[8] NASA, Small Spacecraft State of the Art – Guidance, Navigation and Control, 2026. Documento suministrado para el proyecto.
[9] NASA, Small Spacecraft State of the Art – Avionics, 2026. Documento suministrado para el proyecto.
[10] NASA, Small Spacecraft State of the Art – Communications, 2025. Documento suministrado para el proyecto.
[11] NASA, CubeSat 101: Basic Concepts and Processes for First-Time CubeSat Developers.
