valenjess/CubeSat/P4/BOM_Costos/BOM_ADCS_CubeSat_1U_COMPLETADO.xlsx

Sheet: BOM_ADCS_CubeSat_1U
Name | Description | Designator | Footprint | LibRef | Quantity | Manufacturer | Manufacturer Part Number
CC0603KRX7R7BB104 | CAP CER 0.1UF 16V X7R 0603 | C1, C2, C3, C4, C6, C8, C10, C11 | FP-CC0603-DA-IPC_B | CMP-2000-05002-2 | 8 | YAGEO | CC0603KRX7R7BB104
CC0805KKX7R6BB475 | CAP CER 4.7UF 10V X7R 0805 | C5 | FP-CC0805-0_85-IPC_C | CMP-03422-001180-1 | 1 | YAGEO | CC0805KKX7R6BB475
CC0603KRX7R6BB105 | CAP CER 1UF 10V X7R 0603 | C7, C9 | FP-CC0603-DA-IPC_B | CMP-03422-000835-1 | 2 | YAGEO | CC0603KRX7R6BB105
GRM155R71A104KA01J | CAP CER 0.1UF 10V X7R 0402 | C12, C15, C24, C25, C41, C42, C57, C58, C76 | CAPC1005X55X25ML05T10 | CMP-2008-04031-1 | 9 | Murata Electronics | GRM155R71A104KA01J
GRM155Z71A225KE01D | Chip Multilayer Ceramic Capacitors for General Purpose, 0402, 2.2uF, X7R, 15%, 10%, 10V | C13 | FP-GRM155-0_15-IPC_A | CMP-06035-048202-1 | 1 | Murata Electronics | GRM155Z71A225KE01D
GRM155R71E103KA01D | CAP CER 10000PF 25V X7R 0402 | C14 | CAPC1005X55X25LL05T10 | CMP-1034-01880-2 | 1 | Murata Electronics | GRM155R71E103KA01D
GRM188R71C105KA12D | CAP CER 1UF 16V X7R 0603 | C16, C26, C36, C37, C38, C39, C40 | CAPC1608X90X35ML10T15 | CMP-2006-02845-1 | 7 | Murata Electronics | GRM188R71C105KA12D
GCM21BR71A106KE22K | Ceramic Capacitor for Automotive 10uF ±10% 10VDC X7R 0805 Embossed T/R | C17, C60, C63, C74, C75 | FP-GCM21B-0_15-MFG | CMP-06035-062139-1 | 5 | Murata Electronics | GCM21BR71A106KE22K
GRM1555C1H470JA01D | CAP CER 47PF 50V C0G/NP0 0402 | C18, C19, C20, C21, C22, C23 | CAPC1005X55X25LL05T10 | CMP-2008-04368-1 | 6 | Murata Electronics | GRM1555C1H470JA01D
GRM1555C1H561JA01D | Chip Multilayer Ceramic Capacitors for General Purpose, 0402, 560pF, C0G, 30ppm/°C, 5%, 50V | C27, C28, C29, C30, C31, C32 | FP-GRM155-0_05-IPC_C | CMP-2008-04388-2 | 6 | Murata Electronics | GRM1555C1H561JA01D
GCM31CR71A226KE02K | Ceramic Capacitor for Automotive 22uF ±10% 10VDC X7R 1206 Embossed T/R | C35 | FP-GCM31C-0_2-e0_3_0_8-IPC_A | CMP-06035-059468-1 | 1 | Murata Electronics | GCM31CR71A226KE02K
C0603C104K3RACTU | CAP CER 0.1UF 25V X7R 0603 | C43, C44, C45, C49, C50, C66, C68, C71, C73 | FP-C0603C-CF-IPC_B | CMP-2006-03057-2 | 9 | KEMET | C0603C104K3RACTU
GCM32ER71E106KA57K | Ceramic Capacitor for Automotive 10uF ±10% 25VDC X7R 1210 Embossed T/R | C46, C47, C48, C65, C70 | FP-GCM32E-0_3-IPC_B | CMP-2000-06320-2 | 5 | Murata Electronics | GCM32ER71E106KA57K
GRM21BR71A106KA73L | Chip Multilayer Ceramic Capacitors for General Purpose, 0805, 10uF, X7R, 15%, 10%, 10V | C51, C52 | FP-GRM21B-0_15-MFG | CMP-2000-07555-2 | 2 | Murata Electronics | GRM21BR71A106KA73L
C0603C103K3RACTU | CAP CER 10000PF 25V 10% X7R 0603 | C53, C54, C78 | FP-C0603C-CF-IPC_B | CMP-2006-03040-2 | 3 | KEMET | C0603C103K3RACTU
GRM188R71A225KE15D | Chip Multilayer Ceramic Capacitors for General Purpose, 0603, 2.2uF, X7R, 15%, 10%, 10V | C55, C56 | FP-GRM188-0_1-e0_2_0_5-IPC_A | CMP-2006-02836-2 | 2 | Murata Electronics | GRM188R71A225KE15D
CL10A475KP8NNNC | Cap Ceramic 4.7uF 10V X5R ±10% Pad SMD 0603 +85°C T/R | C59 | FP-CL10-IPC_C | CMP-13271-003017-1 | 1 | Samsung Electro-Mechanics | CL10A475KP8NNNC
GCM155R71H104KE02D | Ceramic Capacitor for Automotive 100nF ±10% 50VDC X7R 0402 Paper T/R | C61, C64 | FP-GCM155-0_05-IPC_A | CMP-2000-07456-3 | 2 | Murata Electronics | GCM155R71H104KE02D
C0402C223K5RACTU | CAP CER 0.022UF 50V 10% X7R 0402 | C62 | FP-C0402-BB-MFG | CMP-2008-03151-2 | 1 | KEMET | C0402C223K5RACTU
C3225X7R1A226M230AC | 22 µF Â±20% 10V Ceramic Capacitor X7R 1210 (3225 Metric) | C67 | CAP_C3225X7R1A226M230AC | C3225X7R1A226M230AC | 1 | TDK | C3225X7R1A226M230AC
C0603C332J5GACTU | CAP CER 3300PF 50V 5% NP0 0603 | C69 | FP-C0603C-CF-IPC_B | CMP-2006-03334-2 | 1 | KEMET | C0603C332J5GACTU
C1210C226K8RACAUTO | 22 µF Â±10% 10V Ceramic Capacitor X7R 1210 (3225 Metric) | C72 | CAPC3225X280N | C1210C226K8RACAUTO | 1 | KEMET | C1210C226K8RACAUTO
BAT54J,115 | DIODE SCHOTTKY 30V 200MA SOD323F | D1 | FP-SOD323F-MFG | CMP-14398-000037-1 | 1 | Nexperia | BAT54J,115
NUP2105LT1G | Dual Line CAN Bus Protector, 3-Pin SOT-23, Pb-Free, Tape and Reel | D7 | ONSC-SOT-23-3-318-08_V | CMP-1063-00164-1 | 1 | onsemi | NUP2105LT1G
SMBJ18A | TVS DIODE 18V SMB | D8 | ST_SMB | SMBJ18A | 1 | PENDIENTE — fabricante no determinado por el MPN genérico | SMBJ18A
TSW-105-07-L-S | CONN HEADER VERT 5POS 2.54MM | J1 | SAMTEC_TSW-105-07-L-S | CMP-029-000000-1 | 1 | Samtec | TSW-105-07-L-S
530470710 | Conn Shrouded Header (4 Sides) HDR 7 POS 1.25mm Solder ST Top Entry Thru-Hole PicoBladeâ„¢ Tray | J2, J3, J4 | CONN07_530470710_MOL | 530470710 | 3 | Molex | 530470710
53047-0210 | CONN HEADER VERT 2POS 1.25MM | J5, J6, J7 | FP-53047-0210-MFG | CMP-2000-05628-3 | 3 | Molex | 53047-0210
TSW-103-07-T-S | 0.025" SQ Post Header, Through-hole, Vertical, -55 to 105 degC, 2.54 mm Pitch, 3-Pin, Male, RoHS | J8 | SMTC-TSW-103-07-X-S | CMP-1024-00332-1 | 1 | Samtec | TSW-103-07-T-S
TSW-102-07-T-S | CONN HEADER VERT 2POS 2.54MM | J9 | CON2_1X2_TU_TSW | TSW-102-07-T-S | 1 | Samtec | TSW-102-07-T-S
SM02B-GHS-TB(LF)(SN) | CONN HEADER SMD R/A 2POS 1.25MM | J10, J11, J12, J13, J14, J15 | FP-SM02B-GHS-TB_LF_SN-MFG | CMP-2000-07076-2 | 6 | JST | SM02B-GHS-TB(LF)(SN)
ACT1210D-101-2P-TL00 | CMC 100UH 150MA 2LN SMD AEC-Q200 | L1 | FP-ACT1210D-MFG | CMP-08256-000008-1 | 1 | TDK | ACT1210D-101-2P-TL00
XFL4020-222MEC | INDUCTOR, 2.2UH, 8A, 20%, 38MHZ, REEL | L2 | FP-XFL4020-MFG | CMP-2000-05090-4 | 1 | Coilcraft | XFL4020-222MEC
VLS3012HBX-2R2M-N | INDUCTORS FOR POWER CIRCUITS, WO | L3 | IND_VLS3012HBX-2R2M-N | VLS3012HBX-2R2M-N | 1 | TDK | VLS3012HBX-2R2M-N
BLM31PG121SN1L | Chip Ferrite Bead Array, 1206, 120Ω @ 100MHz, 0.02Ω, 25%, 3.5A | L4 | FP-BLM31-0_2-t1_1-MFG | CMP-0686-00732-3 | 1 | Murata Electronics | BLM31PG121SN1L
RC0603FR-074K7L | Chip Resistor, 4.7 KOhm, +/- 1%, 0.1 W, -55 to 155 degC, 0603 (1608 Metric), RoHS, Tape and Reel | R1, R2 | RESC1608X55X25NL10T15 | CMP-2000-06942-1 | 2 | YAGEO | RC0603FR-074K7L
RC0402FR-07220RL | RES 220 OHM 1% 1/16W 0402 | R4, R5, R6, R7, R8, R9 | FP-RC0402-0_4-MFG | CMP-2002-07511-2 | 6 | YAGEO | RC0402FR-07220RL
RC0402FR-07107RL | RES 107 OHM 1% 1/16W 0402 | R10, R11, R12, R13, R14, R15 | RESC1005X40X25ML05T10 | CMP-2002-07349-1 | 6 | YAGEO | RC0402FR-07107RL
RC0603FR-07100KL | RES SMD 100K OHM 1% 1/10W 0603 | R18, R19, R20, R21, R22, R23, R36, R37 | FP-RC0603-0_55-MFG | CMP-2100-03662-2 | 8 | YAGEO | RC0603FR-07100KL
RC0603FR-0747KL | RES SMD 47K OHM 1% 1/10W 0603 | R24, R25 | FP-RC0603FR-0747KL-MFG | CMP-1659-00055-2 | 2 | YAGEO | RC0603FR-0747KL
RC0603FR-0710KL | RES 10K OHM 1% 1/10W 0603 | R26, R27 | FP-RC0603-0_55-IPC_B | CMP-2100-03664-2 | 2 | YAGEO | RC0603FR-0710KL
RC0402FR-07120RL | RES 120 OHM 1% 1/16W 0402 | R28 | RESC1005X40X25NL05T10 | CMP-2002-07370-1 | 1 | YAGEO | RC0402FR-07120RL
RC0402FR-070RL | RES SMD 0 OHM JUMPER 1/16W 0402 | R29 | FP-RC0402-0_4-IPC_A | CMP-2002-07342-2 | 1 | YAGEO | RC0402FR-070RL
RC0402FR-0710KL | RES 10K OHM 1% 1/16W 0402 | R30, R35 | RESC1005X40X25LL05T10 | CMP-2002-07353-1 | 2 | YAGEO | RC0402FR-0710KL
RC0402FR-076K8L | RES 6.8K OHM 1% 1/16W 0402 | R31 | RESC1005X40X25ML05T10 | CMP-2002-07004-1 | 1 | YAGEO | RC0402FR-076K8L
RC0402FR-07357KL | RES 357K OHM 1% 1/16W 0402 | R32 | RESC1005X40X25LL05T10 | CMP-2002-07627-1 | 1 | YAGEO | RC0402FR-07357KL
RC0402FR-0718KL | RES 18K OHM 1% 1/16W 0402 | R33 | RESC1005X40X25LL05T10 | CMP-1011-00650-2 | 1 | YAGEO | RC0402FR-0718KL
RC0402FR-0730K1L | RES 30.1K OHM 1% 1/16W 0402 | R34 | RESC1005X40X25NL05T10 | CMP-2002-07600-1 | 1 | YAGEO | RC0402FR-0730K1L
RL1206FR-070R4L | 400 mOhms Â±1% 0.25W, 1/4W Chip Resistor 1206 (3216 Metric) Automotive AEC-Q200, Current Sense, Moisture Resistant Thick Film | R38, R39, R40 | RESC3116X65N | RL1206FR-070R4L | 3 | YAGEO | RL1206FR-070R4L
TPS22919DCKR | POWER MANAGEMENT | SW1, SW2, SW3 | FP-DCK0006A-IPC_A | CMP-04912-000027-1 | 3 | Texas Instruments | TPS22919DCKR
STM32G474RET6 | MCU 32-bit ARM Cortex M4 RISC 512KB Flash 1.8V/2.5V/3.3V 64-Pin LQFP Tray | U1 | FP-LQFP64-5W-IPC_C | CMP-00030-00001-1 | 1 | STMicroelectronics | STM32G474RET6
TPS3839K33DBZR | Ultra-low power, supply voltage supervisor 3-SOT-23 -40 to 85 | U2 | DBZ0003A_N | CMP-022-000000-1 | 1 | Texas Instruments | TPS3839K33DBZR
FM24W256-GTR | 256-Kbit Serial I2C F-RAM | U3 | SOIC127P602X173-8N-1-V | FM24W256-GTR | 1 | Infineon Technologies | FM24W256-GTR
ICM-42670-P | 6-axis MEMS IMU, 3-axis gyroscope + 3-axis accelerometer | U4 | LGA14_2.5X3X0.76_IVS | ICM-42670-P | 1 | TDK InvenSense | ICM-42670-P
MMC5983MA | 3-axis magnetic sensor / magnetometer | U5 | MMC5983MA_MEM | MMC5983MA | 1 | MEMSIC | MMC5983MA
OPA4322AIPWR | 20 MHz, Low Noise, RRIO, CMOS Operational Amplifier, 1.8 to 5.5 V, -40 to 125 degC, 14-pin SOP (PW14), Green (RoHS & no Sb/Br) | U6, U7 | PW0014A_N | CMP-0272-01739-3 | 2 | Texas Instruments | OPA4322AIPWR
ADS8166IRHBT | 16-bit, 250-kSPS, 8-ch SAR ADC with VREF, VREF buffer and direct sensor interface 32-VQFN -40 to 125 | U8 | RHB32_TEX | ADS8166IRHBT | 1 | Texas Instruments | ADS8166IRHBT
DRV8833PWPR | IC MOTOR DRIVER PAR 16HTSSOP | U9, U10 | FP-PWP0016C-IPC_A | CMP-1529-00004-3 | 2 | Texas Instruments | DRV8833PWPR
TCAN1042HGVDRQ1 | IC TRANSCEIVER 1/1 8SOIC | U11 | FP-D0008B-IPC_A | CMP-04872-000094-1 | 1 | Texas Instruments | TCAN1042HGVDRQ1
TPS26600RHFR | IC PWR MGMT EFUSE 60V 24VQFN | U12 | FP-RHF0024A-IPC_A | CMP-04913-000047-1 | 1 | Texas Instruments | TPS26600RHFR
TPS62133AQRGTRQ1 | 3V - 17V 3A AUTOMOTIVE Step-Down Converter In 3X3 QFN Package | U13 | QFN50P300X300X100-17N | TPS62133AQRGTRQ1 | 1 | Texas Instruments | TPS62133AQRGTRQ1
TPS62162DSGT | Buck Step Down Regulator with 3 to 17 V Input and 3.3 V Output, -40 to 85 degC, 8-Pin WSON (DSG), Green (RoHS & no Sb/Br) | U14 | DSG0008A_V | CMP-0323-00319-3 | 1 | Texas Instruments | TPS62162DSGT

Sheet: Verificación comercial
Name | Designator | Manufacturer | Manufacturer Part Number | Estado | Base de identificación
CC0603KRX7R7BB104 | C1, C2, C3, C4, C6, C8, C10, C11 | YAGEO | CC0603KRX7R7BB104 | IDENTIFICADO POR MPN | Fabricante determinado por la referencia comercial/serie del componente; revisar contra la fuente de selección original antes de compra.
CC0805KKX7R6BB475 | C5 | YAGEO | CC0805KKX7R6BB475 | IDENTIFICADO POR MPN | Fabricante determinado por la referencia comercial/serie del componente; revisar contra la fuente de selección original antes de compra.
CC0603KRX7R6BB105 | C7, C9 | YAGEO | CC0603KRX7R6BB105 | IDENTIFICADO POR MPN | Fabricante determinado por la referencia comercial/serie del componente; revisar contra la fuente de selección original antes de compra.
GRM155R71A104KA01J | C12, C15, C24, C25, C41, C42, C57, C58, C76 | Murata Electronics | GRM155R71A104KA01J | VERIFICADO | DigiKey exact MPN
GRM155Z71A225KE01D | C13 | Murata Electronics | GRM155Z71A225KE01D | VERIFICADO | DigiKey exact MPN
GRM155R71E103KA01D | C14 | Murata Electronics | GRM155R71E103KA01D | VERIFICADO | DigiKey exact MPN
GRM188R71C105KA12D | C16, C26, C36, C37, C38, C39, C40 | Murata Electronics | GRM188R71C105KA12D | IDENTIFICADO POR MPN | Fabricante determinado por la referencia comercial/serie del componente; revisar contra la fuente de selección original antes de compra.
GCM21BR71A106KE22K | C17, C60, C63, C74, C75 | Murata Electronics | GCM21BR71A106KE22K | IDENTIFICADO POR MPN | Fabricante determinado por la referencia comercial/serie del componente; revisar contra la fuente de selección original antes de compra.
GRM1555C1H470JA01D | C18, C19, C20, C21, C22, C23 | Murata Electronics | GRM1555C1H470JA01D | VERIFICADO | DigiKey exact MPN
GRM1555C1H561JA01D | C27, C28, C29, C30, C31, C32 | Murata Electronics | GRM1555C1H561JA01D | VERIFICADO | DigiKey exact MPN
GCM31CR71A226KE02K | C35 | Murata Electronics | GCM31CR71A226KE02K | VERIFICADO | DigiKey exact MPN
C0603C104K3RACTU | C43, C44, C45, C49, C50, C66, C68, C71, C73 | KEMET | C0603C104K3RACTU | IDENTIFICADO POR MPN | Fabricante determinado por la referencia comercial/serie del componente; revisar contra la fuente de selección original antes de compra.
GCM32ER71E106KA57K | C46, C47, C48, C65, C70 | Murata Electronics | GCM32ER71E106KA57K | VERIFICADO | DigiKey exact MPN
GRM21BR71A106KA73L | C51, C52 | Murata Electronics | GRM21BR71A106KA73L | VERIFICADO | LCSC exact MPN
C0603C103K3RACTU | C53, C54, C78 | KEMET | C0603C103K3RACTU | IDENTIFICADO POR MPN | Fabricante determinado por la referencia comercial/serie del componente; revisar contra la fuente de selección original antes de compra.
GRM188R71A225KE15D | C55, C56 | Murata Electronics | GRM188R71A225KE15D | VERIFICADO | DigiKey exact MPN
CL10A475KP8NNNC | C59 | Samsung Electro-Mechanics | CL10A475KP8NNNC | VERIFICADO | DigiKey exact MPN
GCM155R71H104KE02D | C61, C64 | Murata Electronics | GCM155R71H104KE02D | IDENTIFICADO POR MPN | Fabricante determinado por la referencia comercial/serie del componente; revisar contra la fuente de selección original antes de compra.
C0402C223K5RACTU | C62 | KEMET | C0402C223K5RACTU | IDENTIFICADO POR MPN | Fabricante determinado por la referencia comercial/serie del componente; revisar contra la fuente de selección original antes de compra.
C3225X7R1A226M230AC | C67 | TDK | C3225X7R1A226M230AC | VERIFICADO | TDK official exact MPN
C0603C332J5GACTU | C69 | KEMET | C0603C332J5GACTU | IDENTIFICADO POR MPN | Fabricante determinado por la referencia comercial/serie del componente; revisar contra la fuente de selección original antes de compra.
C1210C226K8RACAUTO | C72 | KEMET | C1210C226K8RACAUTO | VERIFICADO | LCSC exact MPN
BAT54J,115 | D1 | Nexperia | BAT54J,115 | VERIFICADO | LCSC exact MPN
NUP2105LT1G | D7 | onsemi | NUP2105LT1G | IDENTIFICADO POR MPN | Fabricante determinado por la referencia comercial/serie del componente; revisar contra la fuente de selección original antes de compra.
SMBJ18A | D8 | PENDIENTE — fabricante no determinado por el MPN genérico | SMBJ18A | PENDIENTE | El MPN SMBJ18A es genérico y puede ser fabricado por varios fabricantes; no se fija uno sin la fuente de selección original.
TSW-105-07-L-S | J1 | Samtec | TSW-105-07-L-S | VERIFICADO | DigiKey exact MPN
530470710 | J2, J3, J4 | Molex | 530470710 | VERIFICADO | Molex official exact MPN
53047-0210 | J5, J6, J7 | Molex | 53047-0210 | IDENTIFICADO POR MPN | Fabricante determinado por la referencia comercial/serie del componente; revisar contra la fuente de selección original antes de compra.
TSW-103-07-T-S | J8 | Samtec | TSW-103-07-T-S | VERIFICADO | Samtec official/DigiKey exact MPN
TSW-102-07-T-S | J9 | Samtec | TSW-102-07-T-S | VERIFICADO | Samtec official/DigiKey exact MPN
SM02B-GHS-TB(LF)(SN) | J10, J11, J12, J13, J14, J15 | JST | SM02B-GHS-TB(LF)(SN) | IDENTIFICADO POR MPN | Fabricante determinado por la referencia comercial/serie del componente; revisar contra la fuente de selección original antes de compra.
ACT1210D-101-2P-TL00 | L1 | TDK | ACT1210D-101-2P-TL00 | VERIFICADO | TDK official/DigiKey exact MPN
XFL4020-222MEC | L2 | Coilcraft | XFL4020-222MEC | VERIFICADO | LCSC exact MPN
VLS3012HBX-2R2M-N | L3 | TDK | VLS3012HBX-2R2M-N | VERIFICADO | TDK official exact MPN
BLM31PG121SN1L | L4 | Murata Electronics | BLM31PG121SN1L | VERIFICADO | DigiKey exact MPN
RC0603FR-074K7L | R1, R2 | YAGEO | RC0603FR-074K7L | IDENTIFICADO POR MPN | Fabricante determinado por la referencia comercial/serie del componente; revisar contra la fuente de selección original antes de compra.
RC0402FR-07220RL | R4, R5, R6, R7, R8, R9 | YAGEO | RC0402FR-07220RL | VERIFICADO | LCSC exact MPN
RC0402FR-07107RL | R10, R11, R12, R13, R14, R15 | YAGEO | RC0402FR-07107RL | IDENTIFICADO POR MPN | Fabricante determinado por la referencia comercial/serie del componente; revisar contra la fuente de selección original antes de compra.
RC0603FR-07100KL | R18, R19, R20, R21, R22, R23, R36, R37 | YAGEO | RC0603FR-07100KL | IDENTIFICADO POR MPN | Fabricante determinado por la referencia comercial/serie del componente; revisar contra la fuente de selección original antes de compra.
RC0603FR-0747KL | R24, R25 | YAGEO | RC0603FR-0747KL | IDENTIFICADO POR MPN | Fabricante determinado por la referencia comercial/serie del componente; revisar contra la fuente de selección original antes de compra.
RC0603FR-0710KL | R26, R27 | YAGEO | RC0603FR-0710KL | IDENTIFICADO POR MPN | Fabricante determinado por la referencia comercial/serie del componente; revisar contra la fuente de selección original antes de compra.
RC0402FR-07120RL | R28 | YAGEO | RC0402FR-07120RL | VERIFICADO | YAGEO official/DigiKey exact MPN
RC0402FR-070RL | R29 | YAGEO | RC0402FR-070RL | IDENTIFICADO POR MPN | Fabricante determinado por la referencia comercial/serie del componente; revisar contra la fuente de selección original antes de compra.
RC0402FR-0710KL | R30, R35 | YAGEO | RC0402FR-0710KL | VERIFICADO | DigiKey exact MPN
RC0402FR-076K8L | R31 | YAGEO | RC0402FR-076K8L | VERIFICADO | LCSC/DigiKey exact MPN
RC0402FR-07357KL | R32 | YAGEO | RC0402FR-07357KL | VERIFICADO | DigiKey exact MPN
RC0402FR-0718KL | R33 | YAGEO | RC0402FR-0718KL | VERIFICADO | DigiKey exact MPN
RC0402FR-0730K1L | R34 | YAGEO | RC0402FR-0730K1L | VERIFICADO | DigiKey exact MPN
RL1206FR-070R4L | R38, R39, R40 | YAGEO | RL1206FR-070R4L | VERIFICADO | LCSC exact MPN
TPS22919DCKR | SW1, SW2, SW3 | Texas Instruments | TPS22919DCKR | VERIFICADO | TI EVM BOM exact MPN
STM32G474RET6 | U1 | STMicroelectronics | STM32G474RET6 | IDENTIFICADO POR MPN | Fabricante determinado por la referencia comercial/serie del componente; revisar contra la fuente de selección original antes de compra.
TPS3839K33DBZR | U2 | Texas Instruments | TPS3839K33DBZR | VERIFICADO | DigiKey exact MPN
FM24W256-GTR | U3 | Infineon Technologies | FM24W256-GTR | VERIFICADO | Infineon official exact MPN
ICM-42670-P | U4 | TDK InvenSense | ICM-42670-P | IDENTIFICADO POR MPN | Fabricante determinado por la referencia comercial/serie del componente; revisar contra la fuente de selección original antes de compra.
MMC5983MA | U5 | MEMSIC | MMC5983MA | IDENTIFICADO POR MPN | Fabricante determinado por la referencia comercial/serie del componente; revisar contra la fuente de selección original antes de compra.
OPA4322AIPWR | U6, U7 | Texas Instruments | OPA4322AIPWR | IDENTIFICADO POR MPN | Fabricante determinado por la referencia comercial/serie del componente; revisar contra la fuente de selección original antes de compra.
ADS8166IRHBT | U8 | Texas Instruments | ADS8166IRHBT | VERIFICADO | DigiKey exact MPN
DRV8833PWPR | U9, U10 | Texas Instruments | DRV8833PWPR | VERIFICADO | DigiKey exact MPN
TCAN1042HGVDRQ1 | U11 | Texas Instruments | TCAN1042HGVDRQ1 | IDENTIFICADO POR MPN | Fabricante determinado por la referencia comercial/serie del componente; revisar contra la fuente de selección original antes de compra.
TPS26600RHFR | U12 | Texas Instruments | TPS26600RHFR | VERIFICADO | DigiKey exact MPN
TPS62133AQRGTRQ1 | U13 | Texas Instruments | TPS62133AQRGTRQ1 | VERIFICADO | DigiKey exact MPN
TPS62162DSGT | U14 | Texas Instruments | TPS62162DSGT | VERIFICADO | DigiKey exact MPN
