valenjess/CubeSat/P4/Matriz/ADCS_P4_Listado_Componentes_Esquematico.xlsx

Sheet: Listado Esquemático
PRÁCTICA 4 — CUBESAT 1U UD34 | TARJETA ADCS
LISTADO MAESTRO PARA CONSTRUIR EL ESQUEMÁTICO EN ALTIUM
Fase / función | Tipo | Referencia / designador Altium | Componente | MPN / código | Valor / especificación | Cantidad | Función / conexión | Estado
01 Procesamiento / supervisión | MCU | U1 | STM32G474RET6 | STM32G474RET6 | Cortex-M4F 170 MHz; 512 KB Flash; 128 KB SRAM; LQFP-64 | 1 | Procesamiento ADCS; SPI/I²C/FDCAN/PWM; SWD; watchdog | CERRADO PARA ESQUEMÁTICO
01 Procesamiento / supervisión | Supervisor | U2 | TPS3839K33DBZR | TPS3839K33DBZR | Supervisor 3.3 V; RESET activo bajo push-pull; 200 ms typ. | 1 | +3V3 → NRST (PG10) | CERRADO PARA ESQUEMÁTICO
01 Procesamiento / supervisión | FRAM -> REEMPLAZADO (No hay modelos para descargar) | U3 | MB85RC256V | MB85RC256VPNF-G-AMERE2 / FM24W256-GTR | 256 kbit I²C; 3.3 V | 1 | Calibración, sesgos, parámetros y contadores; A0-A2 y WP a GND | CERRADO PARA ESQUEMÁTICO
01 Procesamiento / supervisión | Resistencia | R1 | Resistencia | TBD | 4.7 kΩ 1% | 1 | Pull-up I²C SDA → +3V3 | CERRADO PARA ESQUEMÁTICO
01 Procesamiento / supervisión | Resistencia | R2 | Resistencia | TBD | 4.7 kΩ 1% | 1 | Pull-up I²C SCL → +3V3 | CERRADO PARA ESQUEMÁTICO
01 Procesamiento / supervisión | Capacitor | C1-C4 | Capacitores | TBD | 100 nF X7R | 4 | Desacoplo individual VDD MCU | CERRADO PARA ESQUEMÁTICO
01 Procesamiento / supervisión | Capacitor | C5 | Capacitor | TBD | 4.7 µF X7R | 1 | Bulk VDD MCU | CERRADO PARA ESQUEMÁTICO
01 Procesamiento / supervisión | Capacitor | C6 | Capacitor | TBD | 100 nF X7R | 1 | Desacoplo VDDA | CERRADO PARA ESQUEMÁTICO
01 Procesamiento / supervisión | Capacitor | C7 | Capacitor | TBD | 1 µF X7R | 1 | Bulk VDDA | CERRADO PARA ESQUEMÁTICO
01 Procesamiento / supervisión | Capacitor | C8 | Capacitor | TBD | 100 nF X7R | 1 | Desacoplo VREF+ | CERRADO PARA ESQUEMÁTICO
01 Procesamiento / supervisión | Capacitor | C9 | Capacitor | TBD | 1 µF X7R | 1 | Bulk/estabilidad VREF+ | CERRADO PARA ESQUEMÁTICO
01 Procesamiento / supervisión | Capacitor | C10 | Capacitor | TBD | 100 nF X7R | 1 | Desacoplo FRAM | CERRADO PARA ESQUEMÁTICO
01 Procesamiento / supervisión | Capacitor | C11 | Capacitor | TBD | 100 nF X7R | 1 | Desacoplo supervisor | CERRADO PARA ESQUEMÁTICO
01 Procesamiento / supervisión | Conector | J1 | Conector SWD | TBD — ICD SWD | SWDIO/SWCLK/NRST/+3V3/GND | 1 | Programación y debug | CERRADO PARA ESQUEMÁTICO
01 Procesamiento / supervisión | Capacitor | C78 | Capacitor |  | 10nF 25V
01 Procesamiento / supervisión | Diodo |  |  | Schottky Nexperia BAT54
02 Sensado inercial | IMU | U4 | ICM-42670-P | ICM-42670-P | 6 ejes; SPI; LGA-14; VDD/VDDIO 1.71–3.6 V | 1 | Acelerómetro + giróscopo; SPI1; INT1/INT2 | CERRADO PARA ESQUEMÁTICO
02 Sensado inercial | Capacitor | C12 | Capacitor | TBD | 100 nF X7R | 1 | Desacoplo VDD | CERRADO PARA ESQUEMÁTICO
02 Sensado inercial | Capacitor | C13 | Capacitor | TBD | 2.2 µF X7R | 1 | Bulk VDD | CERRADO PARA ESQUEMÁTICO
02 Sensado inercial | Capacitor | C14 | Capacitor | TBD | 10 nF X7R | 1 | Desacoplo VDDIO | CERRADO PARA ESQUEMÁTICO
03 Sensado magnético | Magnetómetro | U5 | MMC5983MA | MMC5983MA | 3 ejes; 18 bit; SPI 10 MHz; LGA-16 | 1 | Campo magnético; SPI1; MAG_DRDY | CERRADO PARA ESQUEMÁTICO
03 Sensado magnético | Capacitor | C15 | Capacitor | TBD | 100 nF X7R | 1 | Desacoplo VDD/VDDIO | CERRADO PARA ESQUEMÁTICO
03 Sensado magnético | Capacitor | C16 | Capacitor | TBD | 1 µF X7R | 1 | Desacoplo VDD | CERRADO PARA ESQUEMÁTICO
03 Sensado magnético | Capacitor | C17 | Capacitor | TBD | 10 µF low-ESR | 1 | CAP; mínimo recomendado | CERRADO PARA ESQUEMÁTICO
04 Sensado solar / TIA | Fotodiodo EXTERNOS | EXTERNOS | BPW34 EXTERNOS | BPW34 EXTERNOS | Fotodiodo PIN Si; 430–1100 nm; área ~7 mm² | 6 | Sensores solares EXTERNOS | CERRADO PARA ESQUEMÁTICO
04 Sensado solar / TIA | Conector | J1–J6 | Conector 2 pines | TBD |  | 6 | Entrada de SUN_1…SUN_6 desde sensores externos
04 Sensado solar / TIA | Op-amp quad | U6-U7 | OPA4322AIPWR | OPA4322AIPWR | Quad RRIO; 20 MHz; 1.8–5.5 V; TSSOP-14 | 2 | 6 TIA + 2 buffers de reserva | CERRADO PARA ESQUEMÁTICO
04 Sensado solar / TIA | Resistencia | R4-R9 | Resistencias Rf | TBD | 220 Ω 1% | 6 | Retroalimentación TIA; preliminar conservador AM0 | CERRADO PARA ESQUEMÁTICO
04 Sensado solar / TIA | Capacitor DNP | C18-C23 | Capacitores Cf | TBD / DNP | Footprint 0–47 pF | 6 | Cf en paralelo con Rf; ajustar por estabilidad/ruido | CERRADO PARA ESQUEMÁTICO
04 Sensado solar / TIA | Capacitor | C24-C25 | Capacitores | TBD | 100 nF X7R | 2 | Desacoplo U6/U7 | CERRADO PARA ESQUEMÁTICO
04 Sensado solar / TIA | Capacitor | C26 | Capacitor | TBD | 1 µF X7R | 1 | Bulk +5V_ANA | CERRADO PARA ESQUEMÁTICO
05 Adquisición analógica | ADC | U8 | ADS8166IRHBT | ADS8166IRHBT | 16 bit; 8 canales; 250 kSPS; AVDD 5 V; DVDD 3.3 V; SPI | 1 | 6 sensores solares + 2 buffers reserva; SPI2; RST=NRST; READY→PA15; SDO-0→MISO; SDO-1/ALERT NC; AIN-COM a GND según configuración single-ended | CERRADO PARA ESQUEMÁTICO
05 Adquisición analógica | Resistencia | R10-R17 | Resistencias filtro | TBD | 107 Ω 1% | 8 | Filtro serie AIN0…AIN7 | CERRADO PARA ESQUEMÁTICO
05 Adquisición analógica | Capacitor | C27-C34 | Capacitores C0G/NP0 | TBD | 560 pF C0G/NP0 | 8 | Filtro AIN0…AIN7 | CERRADO PARA ESQUEMÁTICO
05 Adquisición analógica | Capacitor | C35 | Capacitor | TBD | 22 µF X7R ≥10 V | 1 | REFP–REFM | CERRADO PARA ESQUEMÁTICO
05 Adquisición analógica | Capacitor | C36 | Capacitor | TBD | 1 µF X7R | 1 | REFIO | CERRADO PARA ESQUEMÁTICO
05 Adquisición analógica | Capacitor | C37 | Capacitor | TBD | 1 µF X7R | 1 | REFby2 | CERRADO PARA ESQUEMÁTICO
05 Adquisición analógica | Capacitor | C38 | Capacitor | TBD | 1 µF X7R | 1 | AVDD | CERRADO PARA ESQUEMÁTICO
05 Adquisición analógica | Capacitor | C39 | Capacitor | TBD | 1 µF X7R | 1 | DVDD | CERRADO PARA ESQUEMÁTICO
05 Adquisición analógica | Capacitor | C40 | Capacitor | TBD | 1 µF X7R ≥6.3 V | 1 | DECAP | CERRADO PARA ESQUEMÁTICO
05 Adquisición analógica | Capacitor | C41-C42 | Capacitores | TBD | 100 nF X7R | 2 | HF adicional AVDD/DVDD | CERRADO PARA ESQUEMÁTICO
06 Ruedas de reacción | Load switch | SW1-SW3 | TPS22919DCKR | TPS22919DCKR | Load switch 1.5 A; SC-70-6 | 3 | Conmutación +5V RW1-RW3 | CERRADO PARA ESQUEMÁTICO
06 Ruedas de reacción | Módulo actuador | RW1-RW3 | NanoAvionics RW0 | RW0 | +5 V; 3.3 V digital; SPI/UART; ICD 7 pines | 3 | Actuadores actitud | CERRADO PARA ESQUEMÁTICO
06 Ruedas de reacción | Resistencia | R18-R20 | Resistencias | TBD | 100 kΩ 1% | 3 | Pulldown RW_PWR_EN | CERRADO PARA ESQUEMÁTICO
06 Ruedas de reacción | Resistencia | R21-R23 | Resistencias | TBD | 100 kΩ 1% | 3 | Pulldown RW_ENABLE | CERRADO PARA ESQUEMÁTICO
06 Ruedas de reacción | Capacitor | C43-C45 | Capacitores | TBD | 100 nF X7R | 3 | Desacoplo local RW0 | CERRADO PARA ESQUEMÁTICO
06 Ruedas de reacción | Capacitor | C46-C48 | Capacitores | TBD | 10 µF X7R | 3 | Bulk local RW0 | CERRADO PARA ESQUEMÁTICO
06 Ruedas de reacción | Conector | J2-J4 | Conectores | TBD — ICD RW0 | +5V/ENABLE/TX/RX/SCK/NSS/GND | 3 | Interfaces RW1-RW3 | CERRADO PARA ESQUEMÁTICO
07 Actuación magnética | H-bridge dual | U9-U10 | DRV8833PWPR | DRV8833PWPR | Dual H-bridge; 2.7–10.8 V; HTSSOP-16 | 2 | IN1/IN2: seis señales PWM; VM=+5V_ACT; nSLEEP MCU; nFAULT pull-up; VCP 10 nF; VINT 2.2 µF; PowerPAD→GND | CERRADO PARA ESQUEMÁTICO
07 Actuación magnética | Resistencia | R24-R25 | Resistencias | TBD | 47 kΩ 1% | 2 | Pulldown nSLEEP U9/U10 | CERRADO PARA ESQUEMÁTICO
07 Actuación magnética | Resistencia | R26-R27 | Resistencias | TBD | 10 kΩ 1% | 2 | Pull-up nFAULT U9/U10 | CERRADO PARA ESQUEMÁTICO
07 Actuación magnética | 07 Actuación magnética | R38-R39-R40 |  |  | 0.4Ω 1% | 3 | Sensado de corriente
07 Actuación magnética | Capacitor | C49-C50 | Capacitores | TBD | 100 nF X7R | 2 | VM local | CERRADO PARA ESQUEMÁTICO
07 Actuación magnética | Capacitor | C51-C52 | Capacitores | TBD | 10 µF X7R | 2 | Bulk VM | CERRADO PARA ESQUEMÁTICO
07 Actuación magnética | Capacitor | C53-C54 | Capacitores | TBD | 10 nF | 2 | VCP–VM | CERRADO PARA ESQUEMÁTICO
07 Actuación magnética | Capacitor | C55-C56 | Capacitores | TBD | 2.2 µF | 2 | VINT–GND | CERRADO PARA ESQUEMÁTICO
07 Actuación magnética | Conector | J5-J7 | Conectores | TBD — ICD CR0002 | MTQ+/MTQ− | 3 | Torquer X/Y/Z | CERRADO PARA ESQUEMÁTICO
08 Interfaz externa CAN-FD | Transceptor | U11 | TCAN1042HGVDRQ1 | TCAN1042HGVDRQ1 | Transceptor CAN-FD, 5 Mbps, VCC 5 V, VIO 3.3 V, SOIC-8, automotriz | 1 | FDCAN1 TX/RX; VCC=+5V_ACT; VIO=+3V3; STB pulldown 10 kΩ; CANH/CANL→CMC→ESD→J8; 120 Ω seleccionable | CERRADO PARA ESQUEMÁTICO
08 Interfaz externa CAN-FD | CMC | L1 | ACT1210D-101-2P-TL00 | ACT1210D-101-2P-TL00 | CMC CAN/CAN-FD; 115 mA | 1 | TCAN → CMC → ESD → conector | CERRADO PARA ESQUEMÁTICO
08 Interfaz externa CAN-FD | ESD TVS | D7 | NUP2105LT1G | NUP2105LT1G | CAN/CAN-FD; VRWM 24 V | 1 | Protección ESD | CERRADO PARA ESQUEMÁTICO
08 Interfaz externa CAN-FD | Terminación | R28 | Resistencia | TBD | 120 Ω 1% | 1 | Terminación seleccionable | CERRADO PARA ESQUEMÁTICO
08 Interfaz externa CAN-FD | Selector | R29 | Jumper/0 Ω | TBD | 0 Ω / DNP | 1 | Habilita/deshabilita terminación | CERRADO PARA ESQUEMÁTICO
08 Interfaz externa CAN-FD | Resistencia | R30 | Resistencia | TBD | 10 kΩ 1% | 1 | Pulldown STB | CERRADO PARA ESQUEMÁTICO
08 Interfaz externa CAN-FD | Capacitor | C57 | Capacitor | TBD | 100 nF X7R | 1 | VCC TCAN | CERRADO PARA ESQUEMÁTICO
08 Interfaz externa CAN-FD | Capacitor | C58 | Capacitor | TBD | 100 nF X7R | 1 | VIO TCAN | CERRADO PARA ESQUEMÁTICO
08 Interfaz externa CAN-FD | Capacitor | C59 | Capacitor | TBD | 4.7 µF X7R | 1 | Bulk TCAN | CERRADO PARA ESQUEMÁTICO
08 Interfaz externa CAN-FD | Conector | J8 | Conector | TBD — ICD principal | CANH/CANL/GND | 1 | CAN-FD externa | CERRADO PARA ESQUEMÁTICO
09 Alimentación / protección | Conector | J9 | Conector | TBD — ICD EPS | +12 V/GND | 1 | Entrada alimentación externa | CERRADO PARA ESQUEMÁTICO
09 Alimentación / protección | TVS | D8 | SMBJ18A-TR | SMBJ18A-TR | VRWM 18 V; 600 W | 1 | Protección transitorios entrada | CERRADO PARA ESQUEMÁTICO
09 Alimentación / protección | Capacitor | C60 | Capacitor | TBD | 10 µF / 25 V X7R | 1 | Bulk entrada | CERRADO PARA ESQUEMÁTICO
09 Alimentación / protección | Capacitor | C61 | Capacitor | TBD | 100 nF / 50 V X7R | 1 | HF entrada | CERRADO PARA ESQUEMÁTICO
09 Alimentación / protección | eFuse | U12 | TPS26601RHFR | TPS26601RHFR | 4.2–60 V; OCP/UVLO/OVLO/reverse polarity; VQFN-24 | 1 | +12V→+12V_PROT; SHDN=IN; MODE abierto para latch; UVLO/OVLO con R32-R34; FLT→PB7; ILIM R31; dV/dT C62 | CERRADO PARA ESQUEMÁTICO
09 Alimentación / protección | Resistencia | R31 | RILIM | TBD | 6.78 kΩ 1% | 1 | Límite ≈1.8 A | CERRADO PARA ESQUEMÁTICO
09 Alimentación / protección | Resistencia | R32 | Resistencia | TBD | 357 kΩ 1% | 1 | Red UVLO/OVLO | CERRADO PARA ESQUEMÁTICO
09 Alimentación / protección | Resistencia | R33 | Resistencia | TBD | 18.0 kΩ 1% | 1 | Red UVLO/OVLO | CERRADO PARA ESQUEMÁTICO
09 Alimentación / protección | Resistencia | R34 | Resistencia | TBD | 30.1 kΩ 1% | 1 | Red UVLO/OVLO | CERRADO PARA ESQUEMÁTICO
09 Alimentación / protección | Capacitor | C62 | Capacitor | TBD | 22 nF | 1 | dV/dT | CERRADO PARA ESQUEMÁTICO
09 Alimentación / protección | Resistencia | R35 | Resistencia | TBD | 10 kΩ 1% | 1 | Pull-up FLT → +3V3 | CERRADO PARA ESQUEMÁTICO
09 Alimentación / protección | Capacitor | C63 | Capacitor | TBD | 10 µF / 25 V X7R | 1 | Bulk +12V_PROT | CERRADO PARA ESQUEMÁTICO
09 Alimentación / protección | Capacitor | C64 | Capacitor | TBD | 100 nF / 50 V X7R | 1 | HF +12V_PROT | CERRADO PARA ESQUEMÁTICO
10 Regulación +5 V | Buck | U13 | TPS62133A-Q1 | TPS62133AQRGTRQ1 | 5 V fija; 3 A; 3–17 V; VQFN-16; AEC-Q100 | 1 | +12V_PROT→+5V_ACT; L2; VOS→VOUT; DEF/FSW a GND para nominal/default; SS/TR C69; PG→PA3 con R36 | CERRADO PARA ESQUEMÁTICO
10 Regulación +5 V | Inductor | L2 | Inductor | XFL4020-222MEC | 2.2 µH; Isat ≈3.8 A | 1 | Inductor buck | CERRADO PARA ESQUEMÁTICO
10 Regulación +5 V | Capacitor | C65 | Capacitor | TBD | 10 µF / 25 V X7R | 1 | CIN | CERRADO PARA ESQUEMÁTICO
10 Regulación +5 V | Capacitor | C66 | Capacitor | TBD | 100 nF | 1 | CIN HF | CERRADO PARA ESQUEMÁTICO
10 Regulación +5 V | Capacitor | C67 | Capacitor | C3225X7R1A226M230AC | 22 µF / 10 V X7R | 1 | COUT | CERRADO PARA ESQUEMÁTICO
10 Regulación +5 V | Capacitor | C68 | Capacitor | TBD | 100 nF | 1 | COUT HF | CERRADO PARA ESQUEMÁTICO
10 Regulación +5 V | Capacitor | C69 | Capacitor | TBD - C0603C332J5GACTU | 3.3 nF | 1 | SS/TR | CERRADO PARA ESQUEMÁTICO
10 Regulación +5 V | Resistencia | R36 | Resistencia PG | TBD RC0603FR-07100KL | 100 kΩ 1% | 1 | Pull-up PG_5V → +3V3 | CERRADO PARA ESQUEMÁTICO
11 Regulación +3.3 V | Buck | U14 | TPS62162DSGT | TPS62162DSGT | 3.3 V fija; 1 A; 3–17 V; WSON-8 | 1 | +12V_PROT→+3V3; L3; VOS→VOUT; FB→AGND en versión fija; EN=+12V_PROT; PG→PA4 con R37 | CERRADO PARA ESQUEMÁTICO
11 Regulación +3.3 V | Inductor | L3 | Inductor | VLS3012HBX-2R2M-N | 2.2 µH; Isat ≈3.1 A | 1 | Inductor buck | CERRADO PARA ESQUEMÁTICO
11 Regulación +3.3 V | Capacitor | C70 | Capacitor | TBD -GCM32ER71E106KA57K | 10 µF / 25 V X7R | 1 | CIN | CERRADO PARA ESQUEMÁTICO
11 Regulación +3.3 V | Capacitor | C71 | Capacitor | TBD-C0603C104K3RACTU | 100 nF | 1 | CIN HF | CERRADO PARA ESQUEMÁTICO
11 Regulación +3.3 V | Capacitor | C72 | Capacitor | TBD-C1210C226K8RACAUTO | 22 µF / 10 V X7R | 1 | COUT | CERRADO PARA ESQUEMÁTICO
11 Regulación +3.3 V | Capacitor | C73 | Capacitor | TBD | 100 nF | 1 | COUT HF | CERRADO PARA ESQUEMÁTICO
11 Regulación +3.3 V | Resistencia | R37 | Resistencia PG | TBD | 100 kΩ 1% | 1 | Pull-up PG_3V3 → +3V3 | CERRADO PARA ESQUEMÁTICO
12 Alimentación analógica | Ferrita | L4 | Ferrita | BLM31PG121SN1 | 120 Ω @100 MHz | 1 | +5V_ACT → +5V_ANA | CERRADO PARA ESQUEMÁTICO
12 Alimentación analógica | Capacitor | C74 | Capacitor | TBD | 10 µF X7R | 1 | Antes de ferrita | CERRADO PARA ESQUEMÁTICO
12 Alimentación analógica | Capacitor | C75 | Capacitor | TBD | 10 µF X7R | 1 | Después de ferrita | CERRADO PARA ESQUEMÁTICO
12 Alimentación analógica | Capacitor | C76 | Capacitor | TBD | 100 nF X7R | 1 | HF +5V_ANA | CERRADO PARA ESQUEMÁTICO

Sheet: MCU Pinout
Pin | MCU pad | Señal | Destino / nota
1 | VBAT | VBAT | 1.8–3.6 V / definir según uso RTC
2 | PC13 | NC | No usado
3 | PC14 | NC/LSE_IN | Sin LSE
4 | PC15 | NC/LSE_OUT | Sin LSE
5 | PF0 | NC/HSE_IN | HSE externo eliminado; HSI16+PLL
6 | PF1 | NC/HSE_OUT | HSE externo eliminado
7 | PG10 | NRST | Supervisor + SWD
8 | PC0 | IMU_CS | SPI1 CS
9 | PC1 | MAG_CS | SPI1 CS
10 | PC2 | MAG_DRDY | Interrupt
11 | PC3 | PG_5V | Power-good +5V
12 | PA0 | TORQ_X_IN1 / TIM2_CH1 | DRV8833 U9
13 | PA1 | TORQ_X_IN2 / TIM2_CH2 | DRV8833 U9
14 | PA2 | TORQ_Y_IN1 / TIM2_CH3 | DRV8833 U9
15 | VSS | GND | Ground
16 | VDD | +3V3 | Supply
17 | PA3 | TORQ_Y_IN2 / TIM2_CH4 | DRV8833 U9
18 | PA4 | PG_3V3 | Power-good +3V3
19 | PA5 | SPI1_SCK | IMU + magnetómetro
20 | PA6 | SPI1_MISO | IMU + magnetómetro
21 | PA7 | SPI1_MOSI | IMU + magnetómetro
22 | PC4 | IMU_INT1 | IMU
23 | PC5 | IMU_INT2 | IMU
24 | PB0 | TORQ_Z_IN1 / TIM3_CH3 | DRV8833 U10
25 | PB1 | TORQ_Z_IN2 / TIM3_CH4 | DRV8833 U10
26 | PB2 | DRV1_nFAULT | DRV8833 U9
27 | VSSA | AGND | Analog ground
28 | VREF+ | VREF+ | 100 nF + 1 µF
29 | VDDA | +3V3A | 100 nF + 1 µF
30 | PB10 | RW1_ENABLE | RW1
31 | VSS | GND | Ground
32 | VDD | +3V3 | Supply
33 | PB11 | RW2_ENABLE | RW2
34 | PB12 | ADC_CS / SPI2_NSS | ADS8166
35 | PB13 | SPI2_SCK | ADS8166
36 | PB14 | SPI2_MISO | ADS8166 SDO-0
37 | PB15 | SPI2_MOSI | ADS8166 SDI
38 | PC6 | RW1_PWR_EN | TPS22919 SW1
39 | PC7 | RW2_PWR_EN | TPS22919 SW2
40 | PC8 | RW3_PWR_EN | TPS22919 SW3
41 | PC9 | RW3_ENABLE | RW3
42 | PA8 | SPARE | Timer/GPIO spare
43 | PA9 | SPARE | Timer/GPIO spare
44 | PA10 | SPARE | Timer/GPIO spare
45 | PA11 | FDCAN1_RX | TCAN1042HGV
46 | PA12 | FDCAN1_TX | TCAN1042HGV
47 | VSS | GND | Ground
48 | VDD | +3V3 | Supply
49 | PA13 | SWDIO | SWD
50 | PA14 | SWCLK | SWD
51 | PA15 | ADC_READY | ADS8166 READY
52 | PC10 | SPI3_SCK | RW1-RW3
53 | PC11 | SPI3_MISO | RW1-RW3
54 | PC12 | SPI3_MOSI | RW1-RW3
55 | PD2 | DRV2_nFAULT | DRV8833 U10
56 | PB3 | SPARE | Debug-related
57 | PB4 | SPARE | Debug-related
58 | PB5 | DRV1_nSLEEP | DRV8833 U9
59 | PB6 | DRV2_nSLEEP | DRV8833 U10
60 | PB7 | POWER_FAULT | TPS26601 FLT
61 | PB8 | I2C1_SCL | FRAM; boot por option bytes
62 | PB9 | I2C1_SDA | FRAM
63 | VSS | GND | Ground
64 | VDD | +3V3 | Supply

Sheet: Correcciones y criterios
Bloque | Corrección aplicada | Decisión para esquemático | Base técnica
MCU/reset | Eliminar pull-up NRST | TPS3839 es push-pull; NRST directo al supervisor | TI TPS3839
BOOT0/PB8 | Eliminar pull-up BOOT0 | PB8 es I2C1_SCL; usar option bytes para ignorar PB8 durante boot | ST RM0440
MCU power | Añadir 1 µF en VREF+ | VREF+ con 100 nF + 1 µF | ST STM32G474
IMU | 100 nF + 2.2 µF VDD y 10 nF VDDIO | Circuito típico SPI | TDK ICM-42670-P
Magnetómetro | Eliminar pull-up CS; añadir pulldown DRDY | DRDY puede quedar Hi-Z; estado seguro | MEMSIC MMC5983MA
Magnetómetro | CAP 10 µF low-ESR + VDD 1 µF | CAP y VDD están internamente unidos | MEMSIC MMC5983MA
TIA | Eliminar Rbias 100 kΩ | No es necesario en la topología TIA | OPA4322
TIA | Rf = 220 Ω preliminar; Cf DNP | Valor conservador; Cf se valida por simulación | BPW34 + AM0 + OPA4322
ADC | Añadir DECAP 1 µF | Requerido por TI | TI ADS8166
ADC | REFIO 1 µF; REFby2 1 µF; REFP-REFM 22 µF | Valores de aplicación | TI ADS8166
DRV8833 | Eliminar Rsense | DRV8833 no tiene ISEN externo | TI DRV8833
DRV8833 | Seis entradas PWM para tres puentes | IN1/IN2 por torquer; seis canales de timer | Arquitectura H-bridge
RW0 | Pulldowns 100 kΩ en PWR_EN y ENABLE | Estado seguro durante reset | Diseño de seguridad
CAN-FD | TCAN1042HGV + CMC + ESD + 120 Ω seleccionable | Interfaz externa cerrada | TI/Nexperia/TDK
Entrada 12 V | Eliminar F1/PTC redundante | eFuse ya protege OCP/UVLO/OVLO/reverse | TI TPS26601
eFuse | RILIM 6.78 kΩ; 357k/18k/30.1k | ≈1.8 A; UVLO≈10 V; OVLO≈16 V | TI TPS2660 Rev G
Buck +5 | 2.2 µH, 10 µF, 22 µF, 3.3 nF | Circuito de aplicación | TI TPS62133A-Q1
Buck +3.3 | FB→AGND, VOS→VOUT en versión fija | Circuito 3.3 V fijo | TI TPS6216x
Cierre | Listado listo para esquemático | Solo quedan MPN de pasivos/conectores e ICD mecánico | Criterio P4

Sheet: Presupuesto de potencia
Bloque | Supuesto | Potencia estimada | Observación
RW0 ×3 | 5 V × 0.65 A ×3 | 9.75 W | Peor caso preliminar
CR0002 ×3 | 5 × (5/51) ×3 ×80% | 1.18 W | Promedio 80% duty
OPA4322 ×2 | 8×1.4 mA×5 V | 0.056 W | Típico TI
ADS8166 | ≈15 mW | 0.015 W | Típico TI
MCU+sensors+CAN+logic | Estimación | ≈0.30 W | Bloque digital
Total | — | ≈11.3 W | Antes de pérdidas
Margen 20% | 11.3×1.2 | ≈13.6 W | Margen
Objetivo | Pérdidas + margen adicional | ≈15 W | Base de entrada
+12 V @ 15 W | 15/12 | ≈1.25 A | Nominal
+12 V @ 10 V | 15/10 | ≈1.50 A | Peor tensión asumida; eFuse≈1.8 A
+5 V | RW + torquer + analógico + lógica | ≈2.65 A diseño | TPS62133A-Q1 3 A

Sheet: Notas de cierre
Tema | Decisión
Estado | LISTO PARA CONSTRUIR EL ESQUEMÁTICO
TBD no bloqueante | MPN exactos de pasivos/conectores; se completan al colocar librerías/ICD.
TIA | Cf DNP; Rf 220 Ω preliminar; validar por simulación/ensayo.
Conectores | J2-J9 dependen del ICD mecánico/harness.
CAN | R28=120 Ω + R29=0 Ω/DNP seleccionable.
PB8 | Configurar option bytes para que boot no dependa de PB8.
Reloj | Sin HSE externo; HSI16+PLL; PF0/PF1 NC.
P5 | Restricciones de layout pasan a P5; el esquemático ya contiene los circuitos necesarios.
