valenjess/CubeSat/P4/Matriz/Matriz_PCB_ADCS_Restricciones.xlsx

MATRIZ PCB | Restricciones de diseño – ADCS CubeSat 1U
Práctica 4 · Ítem 7 | 31 restricciones documentadas | Última ampliación: dimensionamiento, ΔV, retornos y advertencia sobre DRV8833 PWPR. Valores pendientes de stackup identificados.
ID de restricción PCB | Requisito de origen (P3) | Subsistema / circuito | Componente / red afectada | Categoría | Restricción técnica | Valor / unidad / tolerancia | Origen del criterio | Fuente y fundamento | Aplicación en la PCB | Método de verificación | Estado | Observaciones / pendientes
PCB-001 | RF-013 | Potencia / buck 5 V | U13, C65/C66, +12V_PROT | Desacoplamiento | Colocar capacitores cerámicos de entrada muy próximos a AVIN/PVIN y retorno de potencia; minimizar el lazo de corriente pulsante. | Sin distancia numérica prescrita | Recomendación TI | TI TPS6213xA-Q1 SLVSCC2E Rev.E, sección 12.1 y figura 55, pág. 30 | https://www.ti.com/lit/gpn/TPS62133A-Q1 | Priorizar C65/C66 junto al TPS; lazo VIN-cap-GND compacto. | Inspección de ubicación y trayecto; DRC. | Definida; pendiente de implementación
PCB-002 | RF-013 | Potencia / buck 5 V | U13 pines SW 1–3, L2 | EMI / potencia | Unir todos los pines SW y llevar al inductor L2 mediante nodo de conmutación compacto; separar nodo SW de señales sensibles. | Distancia por definir | Recomendación TI e inferencia física | TI TPS6213xA-Q1 SLVSCC2E Rev.E, sección 12.1 y figura 55, pág. 30 | https://www.ti.com/lit/gpn/TPS62133A-Q1 | L2 contiguo a U13; minimizar cobre expuesto de SW. | Inspección de PCB y conectividad. | Definida; pendiente de implementación | No separar SW1, SW2 y SW3; fueron unidos intencionalmente en esquema.
PCB-003 | RF-013 | Potencia / buck 5 V | U13 pin VOS, C67/C68, +5V_ACT | Realimentación | Conectar VOS por el recorrido más corto al potencial VOUT en capacitor de salida; mantener FB/VOS apartados de SW. | Sin longitud máxima indicada | Exigencia + recomendación TI | TI TPS6213xA-Q1 SLVSCC2E Rev.E, sección 12.1 y figura 55, pág. 30 | https://www.ti.com/lit/gpn/TPS62133A-Q1 | Toma VOS en lado salida de C67 y/o C68; routing independiente del nodo SW. | Inspección y comprobación de origen de net. | Definida; pendiente de implementación
PCB-004 | RF-013 | Potencia / buck 5 V | U13, AGND/PGND/EXP | Retorno / térmica | Conectar AGND y PGND al pad térmico y al plano de GND común; soldar pad expuesto a la PCB. | Conexión obligatoria; área cobre por cálculo | Exigencia TI | TI TPS6213xA-Q1 SLVSCC2E Rev.E, sección 12.1 y figura 55, pág. 30 | https://www.ti.com/lit/gpn/TPS62133A-Q1 | Pad térmico con unión de masa adecuada y cobre de disipación. | DRC de conectividad y revisión térmica. | Definida; pendiente de implementación | Número de vías térmicas condicionado al footprint y stackup.
PCB-005 | RF-013 | Potencia / buck 5 V | U13 SS/TR, C69 | Desacoplamiento / señal | Mantener capacitor SS/TR próximo al pin y retorno AGND de baja impedancia. | Sin distancia numérica | Recomendación TI | TI TPS6213xA-Q1 SLVSCC2E Rev.E, sección 12.1 y figura 55, pág. 30 | https://www.ti.com/lit/gpn/TPS62133A-Q1 | Ubicar C69 junto a U13 y sin compartir trayecto SW. | Inspección layout. | Definida; pendiente de implementación
PCB-006 | RF-013 | Potencia / buck 3V3 | U14, C70/C71, +12V_PROT | Desacoplamiento | Capacitor de entrada muy próximo a VIN/PGND mediante trazos cortos y anchos. | Sin distancia numérica prescrita | Recomendación TI | TI TPS6216x SLVSAM2E Rev.E, sección 11.1 y figura 42, pág. 26 | https://www.ti.com/lit/gpn/TPS62162 | Ubicar C70/C71 junto a U14 y retorno local. | Inspección visual / DRC. | Definida; pendiente de implementación
PCB-007 | RF-013 | Potencia / buck 3V3 | U14 SW, L3, C72/C73 | EMI / potencia | Situar inductor junto a SW y capacitor de salida próximo al trayecto de potencia; área del lazo conmutado mínima. | Sin distancia numérica | Recomendación TI | TI TPS6216x SLVSAM2E Rev.E, sección 11.1 y figura 42, pág. 26 | https://www.ti.com/lit/gpn/TPS62162 | L3 y C72 dispuestos para minimizar bucle SW-L-COUT-PGND. | Inspección de colocación/ruteo. | Definida; pendiente de implementación
PCB-008 | RF-013 | Potencia / buck 3V3 | U14 VOS/FB, +3V3 | Realimentación | Llevar VOS mediante conexión corta al nodo de VOUT en capacitor de salida; separar señales de retorno respecto de SW. | Sin longitud máxima indicada | Recomendación TI | TI TPS6216x SLVSAM2E Rev.E, sección 11.1 y figura 42, pág. 26 | https://www.ti.com/lit/gpn/TPS62162 | Pista VOS de señal, sin proximidad a SW. | Inspección de ruteo y revisión de nets. | Definida; pendiente de implementación
PCB-009 | RF-013 | Potencia / buck 3V3 | U14, AGND/PGND, pad | Térmica / retorno | Reunir AGND, PGND y pad térmico según esquema de retorno recomendado; soldar el pad térmico. | Ubicación y geometría por definir | Exigencia / recomendación TI | TI TPS6216x SLVSAM2E Rev.E, sección 11.1 y figura 42, pág. 26 | https://www.ti.com/lit/gpn/TPS62162 | Plano GND y continuidad térmica bajo U14. | DRC y verificación de huella de encapsulado. | Definida; pendiente de implementación
PCB-010 | RF-013 | Entrada / eFuse | U12 TPS26600, IN-GND | Desacoplamiento | Capacitor cerámico de 0,1 µF o mayor en IN-GND, colocado lo más próximo posible y minimizando área del lazo. | CIN ≥ 0,1 µF (recomendado) | Recomendación TI | TI TPS2660x SLVSDG2G Rev.G, sección 12.1, pág. 39 | https://www.ti.com/lit/ds/symlink/tps2660.pdf | Capacitor de entrada junto a pines IN/GND. | BOM/esquema y layout. | Definida; pendiente de implementación | Verificar valor y presencia en hoja 51_INPUT_PROTECTION.
PCB-011 | RF-013 | Entrada / eFuse | U12, +12V, +12V_PROT | Corriente / potencia | Caminos de potencia de alta corriente lo más cortos posible y dimensionados para conducir al menos dos veces la corriente plena de carga. | I_capacidad_pista ≥ 2 × I_plena_carga (criterio TI) | Exigencia de layout TI | TI TPS2660x SLVSDG2G Rev.G, sección 12.1, pág. 39 | https://www.ti.com/lit/ds/symlink/tps2660.pdf | Definir ancho de cobre con corriente final, espesor, ΔT y caída; trazar corto. | Cálculo IPC / hoja cálculos y DRC. | Definida; pendiente de implementación | No interpretar como corriente de operación nominal del componente.
PCB-012 | RF-013 | Entrada / eFuse | U12 RTN, ILIM, dVdT, IMON | Retorno / señal | Usar plano/isla de RTN y ubicar resistencias y elementos de soporte cerca de sus terminales, alejados de nodos conmutados. | Sin distancias numéricas | Recomendación TI | TI TPS2660x SLVSDG2G Rev.G, sección 12.1, pág. 39 | https://www.ti.com/lit/ds/symlink/tps2660.pdf | RTN definido según datasheet, sin retorno compartido de alta dI/dt. | Inspección de plano de retorno y layout. | Definida; pendiente de implementación
PCB-013 | RF-013 | Entrada / eFuse | U12 / protección entrada | Protección | Colocar TVS y componentes de protección tan cerca como sea posible del dispositivo/entrada protegida, con conexiones cortas. | Sin distancias numéricas | Recomendación condicionada TI | TI TPS2660x SLVSDG2G Rev.G, sección 12.1, pág. 39 | https://www.ti.com/lit/ds/symlink/tps2660.pdf | Posicionar protección junto a entrada si está presente en la arquitectura. | Comprobación del esquema de protección y layout. | Definida; pendiente de implementación | No implica añadir un TVS si el diseño no lo requiere.
PCB-014 | RF-007; RI-003 | Control / MCU | U1 STM32G474RET6, VDD/VSS | Desacoplamiento | Cada par VDD/VSS requiere filtrado cerámico cercano; referencia ST: 100 nF por par más 4,7 µF general. | 4 × 100 nF + 1 × 4,7 µF (LQFP64 con 4 VDD) | Exigencia y esquema de referencia ST | ST STM32G474xE DS12288 Rev.6, sección 5.1.6, figura 16, pág. 81/236 | https://www.st.com/resource/en/datasheet/stm32g474re.pdf | C1–C5 junto a pines VDD y retornos GND; vías próximas. | Confrontar BOM, conectividad y ubicación. | Definida; pendiente de implementación
PCB-015 | RF-007; RI-003 | Control / MCU | U1 VDDA/VSSA, VREF+ | Alimentación analógica | Desacoplar alimentación analógica y referencia según figura de ST, usando retorno VSSA y condensadores cercanos. | VDDA: 10 nF + 1 µF; VREF+: 100 nF + 1 µF (figura de referencia) | Referencia de fabricante ST | ST STM32G474xE DS12288 Rev.6, sección 5.1.6, figura 16, pág. 81/236 | https://www.st.com/resource/en/datasheet/stm32g474re.pdf | Zona limpia para VDDA/VREF+ y retorno VSSA; ruteo separado de SW. | Revisar condensadores, fuente +3V3A y retorno AGND. | Definida; pendiente de implementación | ATENCIÓN: la hoja 54_ANALOG_POWER descrita produce +5V_ANA pero no confirma fuente +3V3A; resolver antes de PCB. En esquema VREF+ actual C6/C9, comparar valores.
PCB-016 | RF-008 | Actuadores / magnetotorquers | U9/U10 DRV8833, VM | Desacoplamiento | Capacitor cerámico bajo ESR de 10 µF nominal próximo a VM/GND con conexión de baja impedancia. | 10 µF recomendado, tensión ≥ VM | Recomendación TI | TI DRV8833 SLVSAR1E Rev.E, sección 10.1 y figura 10, pág. 15 | https://www.ti.com/lit/ds/symlink/drv8833.pdf | C51/C52 cerca de U9/U10, respectivamente. | Verificar BOM, voltaje y layout. | Definida; pendiente de implementación
PCB-017 | RF-008 | Actuadores / magnetotorquers | U9/U10, VM–VCP | Desacoplamiento | Conectar capacitor cerámico de 0,01 µF entre VM y VCP lo más cerca posible de ambos pines. | 0,01 µF; ≥16 V recomendado | Recomendación TI | TI DRV8833 SLVSAR1E Rev.E, sección 10.1 y figura 10, pág. 15 | https://www.ti.com/lit/ds/symlink/drv8833.pdf | C53/C54 contiguos a pines VM/VCP. | Revisión esquema/BOM/PCB. | Definida; pendiente de implementación
PCB-018 | RF-008 | Actuadores / magnetotorquers | U9/U10, VINT | Desacoplamiento | Situar capacitor de 2,2 µF desde VINT hasta GND muy cercano al pin. | 2,2 µF; ≥6,3 V | Recomendación TI | TI DRV8833 SLVSAR1E Rev.E, sección 10.1 y figura 10, pág. 15 | https://www.ti.com/lit/ds/symlink/drv8833.pdf | C55/C56 adyacentes a VINT y GND. | Revisión de valor/tensión y layout. | Definida; pendiente de implementación
PCB-019 | RF-008 | Actuadores / magnetotorquers | U9/U10 variante PWPR | Térmica | Aplicar consideraciones térmicas según encapsulado real: el PW no posee la mejora térmica PowerPAD de PWP. | Pérdida máxima por calcular | Limitación del fabricante TI | TI DRV8833 SLVSAR1E Rev.E, sección 10.1 y figura 10, pág. 15 | https://www.ti.com/lit/ds/symlink/drv8833.pdf | Confirmar footprint PWP/HTSSOP y disipación para corriente de bobinas. | Revisar MPN completo, footprint y balance de potencia. | Definida; pendiente de implementación | TI diferencia PW sin pad térmico y PWP con pad térmico. Confirmar PWP para DRV8833PWPR y geometría del pad.
PCB-020 | RF-008 | Actuadores / ruedas | SW1–SW3 TPS22919DCKR, +5V_ACT | Corriente / térmica | Verificar por cada rueda corriente real frente a capacidad de switch; dimensionar pistas de +5V_RW1/2/3 según cobre y caída admisible. | I_switch máx continua 1,5 A (ficha TI); I_RW por definir | Límite componente + inferencia de diseño | TI TPS22919 Rev.B, resumen características / ficha de producto (página de fabricante) | https://www.ti.com/product/TPS22919 | Ancho individual por presupuesto RW y espesor de Cu; trazas breves. | Comparar ICD de ruedas, cálculos y DRC. | Definida; pendiente de implementación | El valor 1,5 A no establece la corriente requerida de rueda ni el ancho de pista.
PCB-021 | RF-007; RI-003 | Sensores / ADC solar | U8 ADS8168, entradas analógicas y digitales | Integridad de señal | Separar trayectos analógicos sensibles de interfaces digitales conmutadas y acercar red RC/referencia al ADC conforme layout ilustrado por TI. | Sin impedancia/longitud fijada en figura | Inferencia apoyada en layout TI | TI ADS816x SBAS817D Rev.D, figura 8-8, pág. 74 | https://www.ti.com/lit/ds/symlink/ads8168.pdf | Agrupar señales analógicas SUN_1...SUN_6; posicionar referencia y desacoplos localmente. | Inspección frente a figura 8-8, revisión de ruido previsto. | Definida; pendiente de implementación | La figura es ejemplo de layout, no exige por sí sola R/C específicos ni una distancia mínima.
PCB-022 | RF-013; RNF-007 | Todas las alimentaciones | +12V_PROT, +5V_ACT, +3V3 | Caída de tensión | Dimensionar ancho de pistas conforme corriente máxima, espesor del cobre, incremento térmico y caída de tensión permitida. | Ancho y ΔV por calcular; requiere stackup y presupuesto EPS | Cálculo de ingeniería pendiente | TI TPS6213xA-Q1 SLVSCC2E Rev.E, sección 12.1 y figura 55, pág. 30 | https://www.ti.com/lit/gpn/TPS62133A-Q1 | Definir clases de redes Power en Altium tras el cálculo. | Cálculo documentado + DRC. | Definida; pendiente de implementación | NO asignar un ancho sin definir cobre y corriente; referencia TI usada solo para principio de pistas de baja impedancia.
PCB-023 | RNF-006; RNF-007 | Interferencias / analogía | SW de U13/U14, ADC, I2C/SPI | EMI / integridad | Mantener nodos SW de alto dV/dt alejados de VOS/FB y señales analógicas; gestionar rutas de retorno. | Separación por definir con stackup/layout | Recomendación TI e inferencia | TI TPS6213xA-Q1 SLVSCC2E Rev.E, sección 12.1 y figura 55, pág. 30 | https://www.ti.com/lit/gpn/TPS62133A-Q1 | Ubicar buck lejos del frente de medición analógico; plano de retorno continuo. | Revisión EMC pre-layout y DRC orientado a geometría. | Definida; pendiente de implementación
PCB-024 | RF-013; RNF-007 | Potencia / rieles | +12V_PROT; +5V_ACT; +3V3 | Dimensionamiento de pistas | Dimensionar sección de cobre de cada riel por corriente, elevación térmica y caída de tensión; no asignar ancho solo por amperaje. | PENDIENTE: I de diseño (A), Cu (µm), ΔT admisible (°C), ΔV admisible (mV), longitud (mm). | Cálculo de ingeniería; parámetro dependiente de stackup | IPC-2152 (metodología orientativa); TI TPS6213xA-Q1 Rev.E, §12.1, pág.30, https://www.ti.com/lit/ds/symlink/tps62133a-q1.pdf | Crear reglas Width por clase de red solamente después de cálculo sustentado. | Revisar cálculo por riel, DRC Width y caída estimada. | Pendiente de verificación | Pendiente de stackup y presupuesto de corriente.
PCB-025 | RF-013; RNF-007 | Potencia / rieles | +12V_PROT -> U13/U14, +5V_ACT -> ruedas/magnetorquers | Caída de tensión | Establecer límite de caída en redes de alimentación de acuerdo con margen funcional de cargas; verificar tramo ida+retorno. | PENDIENTE: ΔVmax (mV o %), Imax (A), longitud y resistencia del trayecto (Ω). | Cálculo de ingeniería; no umbral impuesto por TI | TI TPS6213xA-Q1 Rev.E §12.1, pág.30 (trayectos cortos/baja resistencia), https://www.ti.com/lit/ds/symlink/tps62133a-q1.pdf | Calcular Vdrop=I·R incluyendo conectores, vías y retornos. | Hoja de cálculo resistivo y revisión del layout. | Pendiente de verificación | Criterio definitivo requiere tolerancia eléctrica del sistema.
PCB-026 | RF-013; RNF-006 | Potencia / buck 5 V | U13 SW1–SW3, L2, C67 | Lazo de conmutación | Minimizar área del lazo de alta di/dt y tamaño del cobre SW; no conducir SW en paralelo próximo a FB/VOS. | Cualitativo: recorrido corto/compacto; sin longitud límite impuesta en mm. | Recomendación explícita del fabricante | TI TPS6213xA-Q1 Rev.E, §12.1, pág.30, fig.55, https://www.ti.com/lit/ds/symlink/tps62133a-q1.pdf | Agrupar U13-L2-C67 y ubicar feedback fuera del nodo SW. | Inspección layout comparado con fig.55. | Pendiente de verificación | Verificar además corrientes de retorno.
PCB-027 | RF-013; RNF-006 | Potencia / buck 3V3 | U14, C70/C71, L3, C72/C73 | Lazo de conmutación | Capacitor VIN-PGND muy cercano, conductor ancho y corto; SW-L3-COUT-PGND con área mínima; VOS alejado del nodo SW. | Cualitativo: compactación y separación funcional; sin mm fijos en datasheet. | Recomendación explícita del fabricante | TI TPS6216x Rev.E, §11.1, pág.26, fig.42, https://www.ti.com/lit/ds/symlink/tps62162.pdf | Definir ubicación relativa y conexiones de retorno antes del ruteo general. | Comparar con fig.42; verificación visual y DRC. | Pendiente de verificación | Revisar disponibilidad de plano de GND continuo.
PCB-028 | RF-008; RNF-007 | Magnetorquers | U9/U10 VM, VCP, VINT; C49–C56 | Desacoplamiento | Situar 10 µF cerámico bajo ESR de VM a GND; 10 nF VM-VCP; 2.2 µF VINT-GND, físicamente junto a pines correspondientes. | 10 µF VM; 0.01 µF VM-VCP con tensión nominal 16 V recomendada; 2.2 µF VINT con tensión nominal 6.3 V recomendada. | Recomendación cuantitativa TI | TI DRV8833 Rev.E, §10.1, pág.15, fig.10, https://www.ti.com/lit/ds/symlink/drv8833.pdf | Ubicar capacitores y unir retornos por trayectos cortos de baja inductancia. | Comprobar valores/ratings y distancias visuales. | Pendiente de verificación | Cuidado: confirmar encapsulado DRV8833PWPR y pinout real antes del layout.
PCB-029 | RF-008; RA-001 | Magnetorquers | U9/U10 DRV8833PWPR | Disipación térmica | Dimensionar cobre y conducción térmica para encapsulado real. No asumir pad expuesto PowerPAD para la opción PW sin validar la hoja de datos. | PENDIENTE: pérdida (W), T_amb (°C), RθJA real y área cobre; encapsulado PW no térmicamente mejorado. | Advertencia explícita TI + verificación de MPN | TI DRV8833 Rev.E, §10.1.1, pág.15, nota encapsulado PW; https://www.ti.com/lit/ds/symlink/drv8833.pdf | Comprobar footprint y conexión del pad 17 que aparece en símbolo antes de fabricación. | Datasheet package drawing + revisión SchLib/PcbLib. | Pendiente de verificación | CRÍTICO: existe posible discrepancia entre PWPR y símbolo con pin térmico 17.
PCB-030 | RNF-006; RNF-007 | Plano de retorno / señales | GND, AGND, +3V3A, buses SPI/CAN | Continuidad de retorno | Evitar interrumpir planos de retorno bajo señales sensibles y conmutadas; analizar cada cruce de partición y vías de retorno. | PENDIENTE: geometría y número de capas del stackup. | Inferencia de ingeniería y buenas prácticas SI/EMC | TI TPS6216x Rev.E §11.1, pág.26 (retornos de alta di/dt), https://www.ti.com/lit/ds/symlink/tps62162.pdf | Definir plano(s) y puente(s) de retorno de acuerdo con topología eléctrica aprobada. | Inspección de plano de referencia, DRC y revisión ERC. | Pendiente de verificación | Antes de rutear, resolver generación de +3V3A y vínculo AGND/GND.
PCB-031 | RR-001; RI-003 | Mecánica y conectores | J2–J7, PCB ADCS CubeSat 1U | Keepout / taladros | Comprobar cuerpos, alturas, taladros, orientación de pines y espacio de montaje de conectores frente al ICD y al volumen disponible. | PENDIENTE: coordenadas, altura máxima, tolerancias mecánicas, diámetro de perforación y keepout. | Restricción de integración; cifras pendientes de planos oficiales | Planos mecánicos exactos de Molex y ICD RW0; no asignar dimensión sin consultar dibujo vigente. | Crear áreas keepout y revisión 3D; revisar conflicto con estructura 1U. | DRC mecánico y comparación dimensional CAD/ICD. | Pendiente de verificación | Requiere revisar dimensiones exactas de todos los conectores.
