valenjess/CubeSat/P3/Cubesat_Valentina_Sebastian.xlsx

Sheet: Portada
CubeSat 1U - Monitoreo multiespectral de cultivos de cafe
Sebastián Zuluaga y Valentina Gaviria | Link repositorio (https://github.com/valenjess/CubeSat/upload/main)
Criterio de fuentes: únicamente documentos suministrados para el proyecto/laboratorio.
Los valores no soportados documentalmente se mantienen como TBD y se indica cómo cerrarlos.
No se incorporan datos de páginas web, productos comerciales o referencias externas.
Consideraciones CubeSat
Vida útil nominal | 6 meses
Tipo de órbita de referencia | Circular, heliosincrona (SSO), ~550 km de altitud
Localidad | Medellin, Colombia
Carga util | Camara multiespectral para analisis experimental de regiones/lotes de café
Generacion de energia | Paneles solares
Almacenamiento de energia | Baterias recargables
Control de orientacion | Sensores y actuadores (ADCS activo)
Comunicacion | Bidireccional con tierra
Propulsion | Ausente (no se incluye en el diseno)
Software | No se implementa durante el curso; se especifica pero no se codifica/verifica en ejecucion
Contenido del libro
1. Matriz de requisitos
2. Especificaciones tecnicas y matriz de trazabilidad
3. Distribucion de funciones entre hardware y software
4. Alternativas de arquitectura
5. Criterios de comparacion y seleccion
Terminología
SSO | Órbita heliosíncrona
OBD | Diagnóstico a Bordo
FOV | Field Of View
TT&C | Telemetry, Tracking and Command
CDS | Especificación de Diseño de CubeSat
EPS | Sistema de Energía Eléctrica
Apuntamiento nadir | consiste en orientar un instrumento, sensor o cámara directamente hacia abajo, de forma perpendicular a la superficie del suelo u objeto de estudio.
swath | anchura de la franja de terreno que la cámara logra capturar en el suelo a medida que se desplaza.
ECC | Error-Correcting Code
FDIR | Detección, Aislamiento y Recuperación de Fallos
FMECA | Análisis de Modos de Falla, Efectos y Criticidad
CDS | Especificación de Diseño de CubeSat
TBD | Por determinar

Sheet: Matriz de requisitos
ID | Tipo | Subsistema | Título | Requisito | Origen o justificación | Prioridad | Criterio de aceptación | Fuente / referencia
RF-001 | Funcional | OBC / C&DH | Ejecución de telecomandos | El OBC deberá recibir, validar, decodificar y ejecutar los telecomandos autorizados provenientes de la estación terrena. | Función explícita del OBC en la misión. Se elimina la selección prematura de MCU, frecuencia de reloj y RTOS, esos elementos se derivarán posteriormente de la carga de procesamiento. | Alta | La arquitectura y el presupuesto de procesamiento demuestran capacidad suficiente para recibir, validar, ejecutar y confirmar los comandos definidos, sin exigir implementación de software en esta práctica. | Proyecto UD34; Práctica 3; ECSS-E-ST-20C §4.1.3
RF-002 | Funcional | Carga útil / OBC | Control de adquisición de la cámara | El sistema deberá permitir iniciar, configurar y finalizar las adquisiciones de la cámara multiespectral mediante el sistema de procesamiento. | El proyecto exige electrónica para controlar la cámara y recibir sus datos. | Alta | El diagrama funcional y la distribución HW-SW identifican las señales, interfaces y funciones necesarias para controlar la adquisición. | Proyecto UD34, descripción de sistemas electrónicos
RF-003 | Funcional | Carga útil / OBC | Recepción de datos de la cámara | El sistema deberá recibir los datos generados por la cámara durante una adquisición válida y entregarlos al subsistema de almacenamiento. | El proyecto exige recibir y almacenar los datos de la cámara; la interfaz digital y el volumen de información son decisiones de diseño. | Alta | La arquitectura de datos identifica la interfaz cámara-OBC/almacenamiento y demuestra compatibilidad con la tasa de datos estimada. | Proyecto UD34
RF-004 | Funcional | OBC / Almacenamiento | Almacenamiento de datos de carga útil | El sistema deberá almacenar las imágenes y los metadatos asociados generados entre oportunidades de descarga, sin exceder la capacidad disponible. | La capacidad de almacenamiento debe derivarse del volumen de datos de la cámara y de la disponibilidad de los enlaces con la estación de Medellín; no se fija arbitrariamente una órbita completa. | Alta | El presupuesto de almacenamiento considera el volumen máximo de datos entre descargas y demuestra capacidad disponible con el margen de diseño definido. | Proyecto UD34; Práctica 3
RF-005 | Funcional | OBC / C&DH | Gestión de modos de operación | El sistema de procesamiento deberá gestionar los modos de operación definidos para la misión y las transiciones entre ellos. | La operación del satélite requiere coordinar adquisición, comunicaciones, potencia, ADCS y recuperación ante anomalías. | Alta | La máquina de estados propuesta identifica modos, condiciones de entrada/salida y funciones habilitadas en cada modo. | Proyecto UD34; Práctica 3
RF-006 | Funcional | OBC / EPS | Entrada en modo seguro | El sistema deberá disponer de una función automática de entrada a un modo seguro ante condiciones críticas definidas de energía o funcionamiento. | Protege las funciones esenciales y permite recuperación. Las condiciones exactas y umbrales se definirán a partir del presupuesto de potencia y la arquitectura EPS. | Alta | La arquitectura muestra las señales de detección, la lógica de transición y las cargas que deben permanecer o desconectarse en modo seguro. | Proyecto UD34; ECSS-E-ST-20C §5.2 y §5.7
RF-007 | Funcional | ADCS | Determinación de actitud | El ADCS deberá proporcionar información suficiente para determinar la orientación del CubeSat en los ejes necesarios para la misión. | El proyecto exige sensores para determinar la orientación y deja la selección de sensores al estudiante. | Alta | El presupuesto de sensores y la arquitectura de adquisición demuestran que las variables necesarias para la determinación de actitud están disponibles. | Proyecto UD34
RF-008 | Funcional | ADCS | Control y estabilización de actitud | El ADCS deberá modificar y estabilizar la orientación del CubeSat en los ejes requeridos mediante los actuadores seleccionados, sin utilizar propulsión. | La misión no incluye propulsión y exige sensores y actuadores para determinar y modificar la orientación. | Alta | La arquitectura identifica sensores, actuadores, electrónica de control, potencia e interfaces necesarias para ejecutar posteriormente los algoritmos de control. | Proyecto UD34
RF-009 | Funcional | ADCS / Carga útil | Apuntamiento de la cámara | El ADCS deberá orientar la cámara aproximadamente hacia la Tierra durante las ventanas de adquisición definidas por la misión. | El proyecto exige orientar la cámara aproximadamente hacia la Tierra. El valor numérico de precisión se derivará posteriormente de FOV, resolución y desempeño ADCS; no se fija aún 0,5°/0,15°. | Alta | La especificación de apuntamiento se deriva de la cámara seleccionada y el presupuesto de desempeño del ADCS demuestra cumplimiento. | Proyecto UD34; Práctica 3
RF-010 | Funcional | EPS | Generación de energía solar | El EPS deberá generar energía mediante paneles solares suficiente para las fases de operación definidas de la misión. | La alimentación de la misión se obtiene mediante paneles solares y la arquitectura puede utilizar paneles fijos o desplegables. | Alta | El presupuesto de potencia y energía demuestra que la generación disponible cubre las demandas de las fases consideradas con el margen definido. | Proyecto UD34; ECSS-E-ST-20C §5.2
RF-011 | Funcional | EPS | Almacenamiento de energía | El EPS deberá almacenar energía mediante baterías recargables suficiente para cubrir las demandas de las fases sin generación solar y los picos de carga previstos. | El proyecto exige baterías recargables y el balance energético debe considerar eclipses y cargas de misión. | Alta | El presupuesto de energía demuestra suficiencia de la batería para el peor caso considerado, incluyendo las reservas definidas. | Proyecto UD34; ECSS-E-ST-20C §5.2.2.2
RF-012 | Funcional | EPS | Recarga de batería | El EPS deberá recargar la batería a partir de la energía disponible de los paneles solares y gestionar la carga dentro de los límites de la batería seleccionada. | El proyecto exige explícitamente la función de recarga; la estrategia y topología serán decisiones de arquitectura. | Alta | El diagrama de potencia identifica la cadena de carga y los límites de tensión, corriente y temperatura se derivan de la batería seleccionada. | Proyecto UD34; ECSS-E-ST-20C §5.6
RF-013 | Funcional | EPS | Conversión y distribución de potencia | El EPS deberá convertir y distribuir las tensiones requeridas por los subsistemas y proporcionar protección en las ramas de alimentación. | El proyecto exige conversión, distribución y protección de los circuitos. | Alta | El presupuesto de potencia y el diagrama de distribución identifican cada riel, carga, corriente y elemento de protección. | Proyecto UD34; ECSS-E-ST-20C §5.7 y §5.8
RF-014 | Funcional | EPS / OBC | Supervisión de potencia | El sistema deberá medir y reportar las variables necesarias para supervisar el estado del bus de potencia y los recursos energéticos. | ECSS requiere monitorizar corriente del bus primario, tensión del bus y evolución de los recursos de potencia/energía. | Alta | La tabla de telemetría identifica tensión, corriente y variables energéticas, sus rangos, resolución y frecuencia de actualización. | ECSS-E-ST-20C §4.1.4c-d
RF-015 | Funcional | Carga útil | Captura multiespectral | La carga útil deberá adquirir imágenes multiespectrales de regiones productoras de café durante las condiciones de captura definidas por la misión. | Es la función principal de la misión. Las bandas, resolución e interfaz son decisiones de diseño que deben justificarse; no se impone rojo+NIR ni NDVI como requisito del producto. | Alta | La especificación de la cámara identifica bandas, resolución, interfaz y volumen de datos, y la arquitectura demuestra que son compatibles con ADCS, almacenamiento, potencia y comunicaciones. | Proyecto UD34
RF-016 | Funcional | OBC / TT&C | Telemetría del estado del sistema | El sistema deberá generar telemetría suficiente para supervisar el estado de los subsistemas y localizar condiciones que puedan afectar el desempeño de la misión. | El proyecto define la telemetría como información sobre tensiones, corrientes, temperaturas y estado de subsistemas. El estándar ECSS exige trazabilidad de configuración y fallos relevantes. | Alta | La matriz de telemetría cubre variables de estado, identificación del subsistema y condición operacional de las cadenas de adquisición. | Proyecto UD34; ECSS-E-ST-20C §4.1.4a-b
RF-017 | Funcional | OBC / TT&C | Confirmación de telecomandos | Todo telecomando ejecutable deberá producir una indicación de éxito o fallo que pueda ser reportada mediante telemetría. | Permite verificar desde tierra la ejecución de comandos y es coherente con la necesidad de operar mediante ventanas de comunicación. | Alta | La definición del protocolo de comandos/telemetría incluye un campo o mensaje de confirmación para cada comando ejecutable. | Proyecto UD34; ECSS-E-ST-20C §4.1.3
RF-018 | Funcional | OBC / C&DH | Detección, aislamiento y recuperación de fallos | El sistema deberá identificar las condiciones de fallo relevantes para la misión y ejecutar las acciones de recuperación definidas para cada una. | El presupuesto de potencia y la arquitectura deben considerar escenarios FDIR, la práctica exige identificar funciones de software aunque no se implementen. | Alta | La FMECA y la máquina de estados relacionan cada fallo relevante con detección, aislamiento, acción de recuperación y telemetría. | Práctica 3; ECSS-E-ST-20C §5.2.2.2d
RF-019 | Funcional | OBC / C&DH | Supervisión de subsistemas | El OBC deberá recibir y procesar la información necesaria para supervisar EPS, ADCS, carga útil, almacenamiento y comunicaciones. | Derivado de las funciones centrales exigidas al sistema de procesamiento. | Alta | El diagrama de bloques y la tabla de interfaces muestran las señales de supervisión y control de cada subsistema. | Proyecto UD34
RI-001 | Interfaz | TT&C / Comunicaciones | Enlace bidireccional con la estación de Medellín | El sistema de comunicaciones deberá permitir recibir comandos desde la estación terrena de referencia y transmitir telemetría y datos de carga útil hacia ella. | La misión establece una estación terrestre de referencia en Medellín y comunicación bidireccional. | Alta | El presupuesto de enlace y la arquitectura de comunicaciones demuestran compatibilidad con la estación de referencia para las condiciones de operación definidas. | Proyecto UD34
RI-002 | Interfaz | TT&C / Comunicaciones | Presupuesto de enlace | El enlace de comunicaciones deberá proporcionar una tasa de datos y un margen de enlace suficientes para las cantidades de telemetría y carga útil que deban transmitirse durante las ventanas de contacto consideradas. | La tasa de datos debe derivarse del volumen de información, duración de contacto, frecuencia seleccionada, potencia, antenas y técnica de transmisión. | Alta | El presupuesto de enlace documentado cierra en potencia y tasa de datos para el peor caso de enlace considerado, con un margen definido y justificado. | Proyecto UD34; Práctica 3
RI-003 | Interfaz | Sistema / PCBs | Compatibilidad de interfaces internas | Las interfaces entre tarjetas y subsistemas deberán ser compatibles en alimentación, niveles eléctricos, señales, dirección, protocolo y velocidad. | La integración requiere interfaces coherentes entre potencia, cómputo, sensores, cámara, memoria, actuadores y comunicaciones. | Alta | Existe una tabla de interfaces con origen, destino, señal, niveles, alimentación, protocolo, velocidad y conector para cada enlace. | Proyecto UD34; ECSS-E-ST-20C §5.4
RI-004 | Interfaz | TT&C / Almacenamiento | Integridad de datos transmitidos | El sistema deberá disponer de un mecanismo para detectar errores en comandos y datos transmitidos entre el CubeSat y la estación terrena. | La integridad de las comunicaciones es necesaria para evitar que errores de enlace produzcan comandos inválidos o datos de carga útil corruptos. | Alta | La arquitectura del protocolo identifica el mecanismo de detección de errores y su aplicación a las tramas de comando y datos. | Derivado del flujo TT&C; ECSS-E-ST-20C §4.1.3
RNF-001 | No funcional | Sistema | Contención de fallo simple | Ningún fallo único de hardware identificado deberá propagarse de forma indeterminada hacia componentes, circuitos o interfaces vecinas ni impedir las protecciones previstas. | ECSS exige contención y verificación por análisis de la propagación de fallos simples. | Alta | La FMECA identifica los fallos simples relevantes y demuestra por análisis la contención de sus efectos. | ECSS-E-ST-20C §4.2.1.1a
RNF-002 | No funcional | OBC / C&DH | Margen de procesamiento y memoria | La arquitectura deberá reservar margen suficiente de memoria y carga de procesador para las funciones previstas, de acuerdo con la política de márgenes adoptada. | ECSS recomienda 50 % mínimo en PDR para partes nuevas de software embarcado y 25 % al lanzamiento; en este curso se usa como referencia de dimensionamiento, no como requisito de ejecución de software. | Media | El presupuesto de procesamiento y memoria documenta capacidad requerida, capacidad seleccionada y margen resultante. | ECSS-E-ST-20C §4.2.2.2b; Práctica 3
RNF-003 | No funcional | EPS | Margen de potencia y energía | El presupuesto de potencia y energía deberá incluir un margen de sistema de al menos 5 % sobre la potencia y energía disponibles en el peor caso considerado, incluyendo la pérdida mínima de una cadena solar y una celda de batería según el criterio aplicable. | ECSS establece un margen mínimo de 5 % y exige considerar fallos y fases de misión. Un margen mayor podrá adoptarse como decisión de diseño y deberá justificarse. | Alta | El presupuesto documentado presenta margen >=5 % en los casos de análisis aplicables y registra cualquier margen adicional adoptado. | ECSS-E-ST-20C §5.2.2.2c-e
RNF-004 | No funcional | EPS | Tolerancia a fallo de una celda de batería | Si la arquitectura de batería se diseña para tolerar un fallo simple, deberá mantener la capacidad de operación especificada con una celda en circuito abierto o en cortocircuito. | ECSS establece este requisito para baterías que deban tolerar un fallo simple; es coherente con la estrategia de tolerancia a fallo del sistema. | Alta | El análisis de batería demuestra el comportamiento ante los dos modos de fallo de una celda considerados. | ECSS-E-ST-20C §5.6.2e
RNF-005 | No funcional | EPS | Protección de batería | La batería y su electrónica de monitoreo y control deberán impedir o mitigar sobretemperatura, sobrecorriente, cortocircuito, sobrecarga, sobredescarga y otros modos de fallo de batería aplicables. | ECSS exige estas funciones de seguridad y su gestión conforme a ECSS-Q-ST-40. | Alta | El esquema de protección identifica cada condición, el mecanismo de detección y la acción de protección correspondiente. | ECSS-E-ST-20C §5.6.5.2; ECSS-Q-ST-40
RNF-006 | No funcional | Sistema / EMC | Margen de interferencia electromagnética | Los puntos críticos de compatibilidad electromagnética deberán cumplir los márgenes mínimos aplicables a su categoría de criticidad. | ECSS establece 20 dB para circuitos críticos de seguridad y 6 dB para circuitos críticos de misión. La criticidad de los circuitos deberá identificarse antes de aplicar el margen. | Alta | La clasificación de criticidad y el análisis EMC documentan los puntos críticos y demuestran el margen correspondiente. | ECSS-E-ST-20C §6.3.1
RNF-007 | No funcional | Sistema / PCB | Integridad de señal y potencia | La arquitectura y el diseño posterior de PCB deberán preservar la integridad de las señales y de la alimentación en las interfaces identificadas como críticas. | El proyecto exige atención especial a señales digitales de alta velocidad, cámara, memoria, convertidores conmutados y RF. | Alta | Para cada interfaz crítica se documentan las restricciones relevantes de retorno, desacoplamiento, impedancia, longitud, separación o filtrado según la tecnología seleccionada. | Proyecto UD34; Práctica 3
RNF-008 | No funcional | Almacenamiento / TT&C | Integridad de datos almacenados | El sistema deberá detectar la corrupción de datos de carga útil y de información de control durante almacenamiento o transferencia. | Necesario para evitar pérdida silenciosa de imágenes y para garantizar que los datos descargados puedan validarse. | Media | La arquitectura de almacenamiento y comunicación identifica mecanismos de detección de corrupción y su ubicación en el flujo de datos. | Derivado de la misión y del flujo de datos
RA-001 | Ambiental | Sistema / Térmico | Ambiente térmico | Los componentes seleccionados deberán operar dentro de los límites de temperatura previstos para su ubicación durante las condiciones de operación consideradas. | El proyecto utiliza el entorno orbital como contexto de diseño, pero no exige un análisis térmico avanzado, por ello los límites internos se derivarán posteriormente. | Alta | El presupuesto térmico preliminar relaciona el rango esperado en cada ubicación con los rangos de operación de los componentes seleccionados. | Proyecto UD34; Práctica 3
RA-002 | Ambiental | Sistema / Componentes | Entorno de radiación | La selección de componentes deberá considerar la exposición a radiación esperada para la misión de seis meses en la órbita de referencia y los modos de fallo relevantes. | El proyecto permite simplificar el análisis de radiación, pero no eliminar las funciones esenciales ni generar inconsistencias. | Media | Se documenta una evaluación preliminar de susceptibilidad a radiación para los componentes críticos y las mitigaciones consideradas. | Proyecto UD34; Práctica 3
RA-003 | Ambiental | Sistema / Estructura | Venteo y despresurización | Los volúmenes internos cerrados deberán permitir el venteo requerido durante el ascenso de acuerdo con el estándar y el dispensador seleccionados. | El CDS exige considerar el venteo durante el ascenso. El valor geométrico definitivo depende del volumen interno y del dispensador. | Media | El diseño mecánico identifica volúmenes cerrados y documenta su solución de venteo conforme al estándar/dispensador seleccionado. | CubeSat Design Specification Rev. 14.1 §2.5.2
RA-004 | Ambiental | Sistema / EMC | Compatibilidad EMC con lanzamiento | El diseño deberá ser compatible con los requisitos EMC aplicables durante las fases de prelanzamiento y lanzamiento del dispensador/lanzador seleccionado. | ECSS remite estos requisitos al manual del lanzador y al ICD aplicable; el proveedor todavía no está definido. | Media | Revisión de diseño contra el ICD/manual del lanzador seleccionado o, mientras esté TBD, registro explícito de la restricción pendiente. | ECSS-E-ST-20C §6.3.2.2a
RR-001 | Restricción | Sistema | Formato CubeSat 1U | El sistema completo deberá mantenerse dentro de la envolvente, masa y restricciones de interfaz mecánica correspondientes al formato 1U y al dispensador seleccionado. | El proyecto fija formato 1U y exige consultar el estándar seleccionado para las dimensiones definitivas. | Alta | Inspección dimensional, de masa y de interfaces contra el CDS y el dispensador seleccionado. | Proyecto UD34; CubeSat Design Specification Rev. 14.1
RR-002 | Restricción | Software / Proceso | Software no implementado en el curso | Las funciones de software de vuelo deberán especificarse y asignarse a HW/SW, pero no se implementarán durante esta práctica. | Restricción explícita del alcance académico. | Alta | La hoja de distribución HW-SW documenta las funciones de software y las necesidades de hardware sin exigir código funcional. | Proyecto UD34; Práctica 3
RR-003 | Restricción | Sistema | Vida útil nominal de seis meses | Los presupuestos y decisiones de diseño deberán utilizar seis meses como horizonte nominal de misión. | Es un supuesto mínimo establecido explícitamente por el proyecto. | Alta | Los presupuestos de energía, degradación y desempeño que requieran horizonte temporal utilizan seis meses. | Proyecto UD34
RR-004 | Restricción | OBC / C&DH | Armado para comandos críticos | Los comandos de criticidad alta que puedan modificar funciones sensibles deberán requerir una condición previa de armado/permiso antes de su ejecución. | ECSS exige barreras de seguridad para evitar la ejecución inadvertida de comandos críticos; el mecanismo concreto se definirá en la arquitectura. | Alta | La definición del protocolo muestra que un comando crítico no puede ejecutarse sin la condición de armado correspondiente. | ECSS-E-ST-20C §4.1.3h
RR-005 | Restricción | EPS / Integración | Deployment switch | El sistema de potencia deberá incorporar al menos un interruptor de despliegue que, mientras el CubeSat esté integrado en el dispensador, desconecte eléctricamente las funciones alimentadas. | Requisito eléctrico del CDS para evitar activación durante integración. | Alta | El esquema eléctrico demuestra desconexión de las funciones alimentadas en el estado actuado del switch. | CubeSat Design Specification Rev. 14.1 §2.3.2
RR-006 | Restricción | EPS / Integración | RBF | El sistema deberá incorporar un RBF que corte la alimentación del CubeSat cuando esté insertado. | Requisito del CDS para mantener el satélite sin funciones alimentadas antes de la integración/despliegue. | Alta | Inspección del esquema y prueba funcional del circuito de RBF demuestran el corte de alimentación definido. | CubeSat Design Specification Rev. 14.1 §2.3.5
RR-007 | Restricción | TT&C / RF | Inhibición de transmisión RF | El sistema de comunicaciones deberá disponer de al menos tres inhibiciones independientes que impidan una transmisión RF inadvertida. | El CDS exige al menos tres inhibiciones independientes; un temporizador no cuenta como inhibición independiente. | Alta | El diagrama de RF identifica tres caminos de inhibición eléctricamente independientes y se verifica su efecto sobre la transmisión. | CubeSat Design Specification Rev. 14.1 §2.3.7
RR-008 | Restricción | TT&C / RF | Retardo de transmisión posterior al despliegue | El sistema no deberá generar ni transmitir señales RF antes del tiempo mínimo establecido por el estándar de misión adoptado después del despliegue orbital. | El CDS Rev. 14.1 establece 45 minutos como referencia. | Alta | La arquitectura de inhibición y temporización demuestra que la transmisión permanece bloqueada durante el periodo requerido. | CubeSat Design Specification Rev. 14.1 §2.4.5
RR-009 | Restricción | Integración / Mecánica | Centro de gravedad | La distribución de los componentes deberá mantener el centro de gravedad dentro de los límites aplicables al formato 1U y al dispensador seleccionado. | La distribución de baterías, PCBs, cámara, sensores y otros elementos afecta la integración mecánica y la compatibilidad con el lanzador. | Media | El modelo de masa y la distribución mecánica documentan la posición del centro de gravedad y su cumplimiento frente al estándar/dispensador. | CubeSat Design Specification Rev. 14.1
RN-001 | Normativo | Sistema | Aplicación de referencias normativas | Las restricciones normativas con consecuencia directa sobre el hardware deberán identificarse y trazarse hacia el diseño, utilizando el CDS y las normas ECSS aplicables al alcance del proyecto. | La práctica indica utilizar normas cuando tengan consecuencias directas sobre el hardware; no se pretende convertir el proyecto académico en una certificación de vuelo. | Alta | La matriz de trazabilidad normativa identifica cada requisito normativo aplicable, su fuente y el elemento de diseño afectado. | Práctica 3; CDS Rev. 14.1; ECSS-E-ST-20C
RN-002 | Normativo | Sistema / Confiabilidad | FMECA de fallos relevantes | El diseño deberá utilizar un análisis FMECA para identificar fallos relevantes, sus efectos, mecanismos de detección, aislamiento y recuperación, y las funciones críticas afectadas. | La FMECA soporta la estrategia de tolerancia a fallo y las decisiones de protección y arquitectura. | Alta | La FMECA incluye los bloques críticos del sistema y tiene trazabilidad hacia RNF-001, RF-006 y RF-018. | ECSS-E-ST-20C §4.2.1; Práctica 3
RN-003 | Normativo | EPS | Seguridad de batería | La seguridad de la batería deberá gestionarse conforme a los requisitos aplicables de ECSS-Q-ST-40. | ECSS-E-ST-20C §5.6.5.2a establece esta referencia para la gestión de seguridad de baterías. | Alta | La selección y arquitectura de protección de la batería presentan trazabilidad a los requisitos aplicables de ECSS-Q-ST-40. | ECSS-E-ST-20C §5.6.5.2a

Sheet: 2. Especificaciones tecnicas
ID | Requisitos asociados | Parámetro técnico | Valor / rango / tolerancia | Unidad | Estado | Fundamento y trazabilidad | Método de verificación | Dependencias / cómo se cierra
ET-01 | RF-001 | Tiempo de respuesta/ejecución de telecomando | TBD | ms | TBD justificado | La latencia no puede fijarse antes de seleccionar la arquitectura OBC, protocolo y carga de procesamiento. La guía exige derivar las necesidades de procesamiento y temporización a partir de las funciones. | Análisis de carga; posteriormente prueba | Cerrar con arquitectura OBC, protocolo, temporización y carga computacional.
ET-02 | RF-015 | Resolución espacial en tierra (GSD) | TBD; debe justificarse | m/píxel | TBD justificado | El proyecto exige justificar la resolución de las imágenes y establece que la misión observa regiones o lotes de café, no plantas individuales. No se fija un valor numérico porque los documentos suministrados no imponen uno, aún así se tiene un estimado de una extensión promedio de los cultivos de 1.4 a 1.6 ha. | Análisis de misión y selección de cámara/óptica | Cerrar al seleccionar cámara, óptica, FOV y criterio de observación.
ET-03 | RF-015 | Cobertura por imagen (swath) | TBD | km × km | TBD justificado | La cobertura por imagen depende del FOV y de la geometría de la cámara. Los documentos suministrados no fijan un FOV de cámara concreto. | Análisis geométrico con cámara seleccionada | Cerrar conjuntamente con ET-02 y la selección de cámara/óptica.
ET-04 | RF-009 | Error de apuntamiento de la cámara | TBD | ° (criterio de desempeño a definir) | TBD justificado | El proyecto exige orientar la cámara aproximadamente hacia la Tierra, pero no fija una precisión angular. El valor deberá derivarse de la cámara seleccionada, FOV, resolución y desempeño requerido del ADCS. | Análisis de desempeño ADCS | Cerrar con cámara/FOV y arquitectura ADCS.
ET-05 | RF-009 | Error de conocimiento de actitud | TBD | ° (3σ) | TBD justificado | Se mantiene TBD. El knowledge depende de accuracy, sensores de actitud y estimador previsto. No se conserva como dato de un producto comercial no documentado en los archivos suministrados. | Análisis de estimación de actitud | Cerrar con ET-04 y sensores/estimador de actitud.
ET-06 | RF-003, RF-015 | Volumen de datos por imagen capturada | TBD | MB/imagen | TBD justificado | Depende de resolución del sensor, número de bandas, profundidad radiométrica, formato de almacenamiento y posible compresión. Se resuelve al seleccionar la configuración espectral y de adquisición. | Análisis de volumen de datos | Cerrar con resolución, bandas, bits y formato.
ET-07 | RF-004 | Capacidad de almacenamiento a bordo | TBD | MB o GB | TBD justificado | Debe cubrir el volumen máximo de datos entre oportunidades de descarga y el margen de almacenamiento definido. Depende de ET-06 y del plan de observación/descarga. | Análisis; demostración posterior | Cerrar con ET-06 y máximo de capturas entre descargas.
ET-08 | RI-001, RI-002 | Duración efectiva de los pases sobre la estación de Medellín | TBD | min/pase | TBD justificado | Requiere definir geometría orbital, elevación mínima operativa, orientación de antena y restricciones del enlace. La guía no exige un análisis orbital exhaustivo, por lo que se utilizará un cálculo preliminar defendible. | Análisis orbital simplificado | Cerrar con máscara de elevación y geometría orbital simplificada.
ET-09 | RI-002 | Margen de enlace de bajada | TBD | dB | TBD justificado | Los documentos suministrados no fijan un margen numérico de enlace para esta misión. El margen debe obtenerse del presupuesto completo de enlace. | Presupuesto de enlace; prueba cuando corresponda | Cerrar con potencia RF, ganancias, pérdidas, sensibilidad, tasa, modulación/codificación y condiciones del enlace.
ET-10 | RI-002 | Tasa de datos de bajada necesaria | TBD | kbps | TBD justificado | Debe derivarse del volumen de datos que se necesita descargar y del tiempo de contacto disponible, considerando eficiencia de protocolo y margen de red. | Análisis de comunicaciones | Depende de ET-06, ET-08 y eficiencia de enlace.
ET-11 | RF-011, RNF-003 | Capacidad energética mínima de batería para eclipse | TBD | Wh | TBD justificado | Debe cubrir la demanda energética durante el peor caso de eclipse y los modos operativos aplicables, incluyendo margen y escenarios de fallo definidos por el presupuesto de energía. | Análisis; presupuesto de energía | Depende de perfil de carga, eclipse y margen energético.
ET-12 | RR-001 | Masa máxima total | ≤ 2.00 | kg | Cerrado | El CDS Rev. 14.1 establece para 1U una masa típica máxima de 2,00 kg y señala que debe verificarse la capacidad específica del dispensador. | Pesaje; inspección | Verificar además capacidad del dispensador.
ET-13 | RR-001 | Envolvente dimensional 1U | Según dibujos CDS Rev. 14.1 y dispensador seleccionado | mm | Cerrado | El CDS exige que la configuración y dimensiones físicas conformen los dibujos aplicables del Apéndice B. No se sustituye por una simplificación de 100×100×100 mm. | Inspección dimensional | Verificar contra dibujos CDS y dispensador.
ET-14 | RR-009 | Centro de gravedad respecto al centro geométrico | X,Y,Z: ±2 | cm | Cerrado | Para 1U, el CDS Rev. 14.1 especifica ±2 cm en cada eje respecto al centro geométrico. | Análisis de masa; inspección | Verificar después de distribución de masas.
ET-15 | RR-001 | Protrusión máxima en superficies restringidas | ≤ 6.5 | mm | Cerrado | El CDS limita a 6,5 mm la protrusión normal desde el plano del riel en las superficies indicadas. | Inspección dimensional | Verificar en CAD/inspección.
ET-16 | RR-006 | Protrusión máxima del RBF con el pin insertado | ≤ 6.5 | mm | Cerrado | El CDS Rev. 14.1 establece que el RBF no debe sobresalir más de 6,5 mm respecto a la superficie del riel cuando está completamente insertado. | Inspección dimensional | Verificar en CAD/inspección del RBF.
ET-17 | RR-005 | Número mínimo de deployment switches | ≥ 1 | switch | Cerrado | El CDS exige como mínimo un deployment switch, actuado durante la integración en el dispensador. | Inspección; revisión del esquema | Cerrar en arquitectura EPS/integración.
ET-18 | RR-005 | Desconexión eléctrica con deployment switch actuado | Desconexión eléctrica del sistema de potencia respecto a las funciones alimentadas | — | Cerrado | CDS Rev. 14.1 §2.3.2.1: en estado actuado, el deployment switch debe desconectar eléctricamente el sistema de potencia de las funciones alimentadas. | Análisis de arquitectura; prueba funcional | Cerrar en arquitectura EPS y prueba funcional.
ET-19 | RR-005 | Reinicio al estado previo al lanzamiento tras retorno del deployment switch | Sí | — | Cerrado | CDS Rev. 14.1 §2.3.2.4: si el deployment switch retorna al estado actuado, el satélite debe volver al estado previo al lanzamiento, incluidos los temporizadores de transmisión y despliegue. | Análisis de estados; prueba funcional posterior | Cerrar en máquina de estados de potencia/TT&C.
ET-20 | RR-007 | Inhibiciones independientes de transmisión RF | ≥ 3 | inhibiciones | Cerrado | CDS Rev. 14.1 §2.3.7: al menos tres inhibiciones RF independientes para impedir transmisión inadvertida; un temporizador no cuenta como inhibición independiente. | Revisión del esquema; prueba funcional | Cerrar en arquitectura RF con tres barreras físicas.
ET-21 | RR-008 | Tiempo mínimo antes de generar/transmitir RF después del despliegue | ≥ 45 | min | Cerrado | El CDS Rev. 14.1 establece que el CubeSat no debe generar ni transmitir una señal antes de 45 min después del despliegue orbital. | Análisis de temporización; prueba funcional | Cerrar en lógica de arranque/TT&C.
ET-22 | RR-007 | Inhibiciones independientes para estructuras desplegables | ≥ 3 (si existen elementos desplegables) | inhibiciones | Condicional | CDS Rev. 14.1 §2.3.8: al menos tres inhibiciones independientes para impedir la liberación inadvertida de estructuras desplegables como antenas o paneles solares. | Revisión de arquitectura; prueba funcional | Aplica solo si existen desplegables.
ET-23 | RR-007 | Retardo mínimo de despliegue de elementos desplegables | ≥ 30 (si aplica) | min | Condicional | CDS Rev. 14.1 §2.4.4: los elementos desplegables deben esperar un mínimo de 30 min después de la activación del/de los deployment switch(es) durante la expulsión. | Análisis de temporización; prueba | Aplica solo si existen desplegables.
ET-24 | RN-001 | Pérdida total de masa por materiales (TML) | ≤ 1.0 | % | Cerrado | CDS Rev. 14.1 §2.1.7.1: TML ≤1.0 %. | Hoja de datos/certificación de materiales | Verificar materiales seleccionados.
ET-25 | RN-001 | Material condensable (CVCM) | ≤ 0.1 | % | Cerrado | CDS Rev. 14.1 §2.1.7.2: CVCM ≤0.1 %. | Hoja de datos/certificación de materiales | Verificar materiales seleccionados.
ET-26 | RN-001 | Campo magnético adicional de imanes pasivos | ≤ 0.5 | Gauss sobre el campo terrestre, fuera de la envolvente estática | Cerrado | CDS Rev. 14.1 §2.1.8: campo de imanes pasivos ≤0.5 Gauss sobre el campo terrestre, fuera de la envolvente estática. | Análisis; medición si aplica | Verificar si se usan imanes permanentes.
ET-27 | RNF-003 | Margen de potencia y energía disponible | ≥ 5 | % | Cerrado | ECSS-E-ST-20C §5.2.2.2e: margen de sistema no menor que 5 % sobre potencia y energía disponibles en aceptación. | Análisis; presupuesto de potencia/energía | Cerrar con presupuesto de potencia/energía.
ET-28 | RNF-002 | Margen de memoria y carga de procesador | ≥ 50 en PDR; ≥ 25 al lanzamiento | % | Cerrado como criterio de dimensionamiento | La matriz adopta como política de dimensionamiento la recomendación ECSS para nuevos desarrollos: 50 % mínimo en PDR y 25 % al lanzamiento. | Análisis; presupuesto de procesamiento y memoria | Usar en dimensionamiento de procesamiento.
ET-29 | RNF-002 | Margen de throughput de redes internas | ≥ 50 en PDR; sin overflow en tiempo real | % | Cerrado como criterio de dimensionamiento | La matriz adopta como política de dimensionamiento la recomendación ECSS: 50 % mínimo en PDR sobre throughput promedio y ausencia de overflow en tiempo real. | Análisis; presupuesto de interfaces | Usar en dimensionamiento de buses internos.
ET-30 | RNF-006 | Margen EMC en circuitos críticos | ≥ 20 seguridad; ≥ 6 misión | dB | Cerrado | ECSS-E-ST-20C §6.3.1.3: 20 dB para circuitos críticos de seguridad y 6 dB para circuitos críticos de misión. | Análisis EMC; medición cuando corresponda | Aplicar por criticidad al diseño EMC.
ET-31 | RA-001 | Rango de temperatura de operación requerido de los componentes | TBD; debe cubrir el rango térmico interno derivado | °C | TBD justificado | Se corrige la especificación anterior -40 a +85 °C: ese valor imponía una clase COTS sin haber derivado el ambiente interno. Primero se estima el rango térmico del CubeSat y después se seleccionan componentes que lo cubran. | Análisis térmico preliminar; hojas de datos | Derivar rango térmico interno y seleccionar componentes.
ET-32 | RA-003 | Relación volumen ventable/área de venteo | < 50.8 m (2000 in) según CDS | unidad del criterio CDS | Cerrado | CDS Rev. 14.1 §2.1.9: criterio de venteo expresado como relación volumen ventable/área de venteo. | Análisis de venteo; inspección | Aplicar al volumen interno y área de venteo.
ET-33 | RNF-005 | Protección del circuito de batería durante carga/descarga | Evitar condiciones de celdas desequilibradas | — | Cerrado como requisito; parámetros TBD | CDS Rev. 14.1 §2.3.6 exige protección del circuito de batería durante carga/descarga para evitar condiciones de celdas desequilibradas. Los umbrales concretos se derivan de la batería seleccionada. | Revisión de esquema; análisis; prueba | Cerrar umbrales y circuitos con la celda/BMS seleccionados.
ET-34 | RNF-004 | Tolerancia a fallo de una celda | Operación con 1 celda abierta o en corto (si se exige tolerancia a fallo simple) | — | Condicional | Condicional: la necesidad de tolerancia a fallo simple se decidirá mediante la estrategia de confiabilidad y FMECA. Si se adopta, se dimensionará la batería/topología para el caso definido. | Análisis de fallo; prueba si aplica | Cerrar después del FMECA.
ET-35 | RNF-007, RI-003 | Interfaces internas documentadas | 100 % de interfaces críticas con origen, destino, señal/protocolo, características eléctricas preliminares y tasa/volumen definidos; el conector específico podrá permanecer TBD cuando dependa de componentes aún no seleccionados | — | Cerrado | La guía exige que las interfaces se definan antes del diseño esquemático. La especificación queda cerrada como criterio de arquitectura, aunque los valores concretos de cada interfaz se derivarán posteriormente. | Revisión documental; ICD interno | Cerrar antes del esquemático mediante ICD.
ET-36 | RF-010, RNF-003 | Potencia disponible del arreglo solar | TBD; ≥ demanda de potencia + margen | W | TBD justificado | Debe derivarse del presupuesto de potencia y energía, las condiciones orbitales simplificadas, área disponible, eficiencia y degradación. ECSS exige que el arreglo satisfaga el balance de energía durante la vida operacional. | Análisis; presupuesto de potencia/energía | Depende de cargas, eclipse, eficiencia, degradación y área solar.
ET-37 | RF-011, RNF-003 | Energía utilizable de batería | TBD; ≥ demanda de energía de los modos sin generación + margen | Wh | TBD justificado | Debe derivarse del peor caso de eclipse y del perfil de cargas. No se fija una capacidad arbitraria. | Análisis; presupuesto de energía | Depende de carga durante eclipse y capacidad útil.
ET-38 | RF-013 | Rieles de alimentación internos | TBD; uno por cada tensión requerida por los subsistemas | V | TBD justificado | La cantidad y valores de los buses de alimentación dependen de los componentes seleccionados. Deben definirse antes del esquemático para garantizar compatibilidad de interfaces. | Análisis; diagrama de potencia | Depende de tensiones reales de componentes.
ET-39 | RI-003 | Niveles lógicos de interfaces digitales | TBD; compatibles extremo a extremo | V | TBD justificado | Depende de las tecnologías de procesamiento, sensores, memoria y transceptores seleccionadas. No debe fijarse 3,3 V o 5 V antes de cerrar la arquitectura. | Revisión de hojas de datos; análisis | Depende de hojas de datos de cada extremo.
ET-40 | RI-003 | Protocolos de comunicación internos | TBD por interfaz (SPI/I²C/UART/CAN u otro) | — | TBD justificado | La guía exige definir protocolo y responsabilidades, pero la selección depende de la arquitectura y de las necesidades de cada subsistema. | Revisión de arquitectura; ICD interno | Depende de arquitectura OBC, payload, ADCS, EPS y TT&C.
ET-41 | RF-015 | Bandas espectrales de la misión | TBD; deben seleccionarse y justificarse según la misión | — | TBD justificado | El proyecto exige una cámara multiespectral y permite al equipo determinar las bandas espectrales. La selección debe justificarse y ser compatible con la misión y con el resto de subsistemas. | Revisión de misión; análisis espectral; hoja de datos de la cámara seleccionada | Cerrar antes de seleccionar/validar la cámara final; debe ser compatible con resolución, datos, procesamiento, energía y comunicaciones.
ET-42 | RF-003, RF-015 | Profundidad radiométrica por muestra | TBD | bits/muestra | TBD justificado | La profundidad de datos afecta directamente el volumen generado por la cámara y, por tanto, almacenamiento, procesamiento y comunicaciones. El proyecto no fija un número. | Hoja de datos de cámara; análisis de volumen de datos | Cerrar junto con ET-06 y la cámara seleccionada.
ET-43 | RF-003, RF-015 | Formato de datos de imagen | TBD | — | TBD justificado | El formato de almacenamiento/transmisión debe definirse para calcular el volumen de datos y establecer la interfaz entre cámara, procesamiento y almacenamiento. El proyecto no impone un formato concreto. | Hoja de datos; ICD; análisis de datos | Cerrar junto con ET-06, ET-07 y la interfaz cámara-OBC/almacenamiento.
ET-44 | RF-002 | Control de adquisición de cámara | Debe permitir iniciar, configurar y finalizar la adquisición de imágenes; señales y protocolo concretos TBD | — | Cerrado como criterio / parámetros TBD | RF-002; HW/SW-06; IF-07 | Revisión de arquitectura/ICD y posteriormente prueba funcional | Se cierra al definir la interfaz concreta de la cámara y el diseño detallado de la electrónica
ET-45 | RF-008 | Capacidad funcional de control de actitud | Sensores de actitud + estimación/control + actuadores; desempeño angular y capacidad de control TBD | — | Cerrado como arquitectura / desempeño TBD | RF-008; A-13; arquitectura ADCS | Análisis de desempeño ADCS y posteriormente prueba funcional | Se cierra al definir sensores, actuadores, dinámica de control y parámetros de desempeño
ET-46 | RA-002 | Consideración del entorno de radiación | Evaluación preliminar de susceptibilidad de componentes críticos y posibles mitigaciones; valores TID/SEE TBD | — | Criterio cerrado / análisis detallado posterior | RA-002; alcance de Práctica 3 | Revisión documental y análisis de componentes | Se cierra al seleccionar componentes y realizar el análisis de radiación correspondiente

Sheet: 2.2 Trazabilidad Req-Espec
Requisito | Especificaciones asociadas | Cobertura | Comentario
RA-001 | ET-31 | Cubierto | Trazado a una o más especificaciones técnicas.
RF-002 | ET-44 | Cubierto | La especificación define la interfaz y funciones necesarias para iniciar, configurar y finalizar la adquisición de la cámara.
RA-003 | ET-32 | Cubierto | Trazado a una o más especificaciones técnicas.
RF-001 | ET-01 | Cubierto | Trazado a una o más especificaciones técnicas.
RF-003 | ET-06, ET-42, ET-43 | Cubierto | Trazado a una o más especificaciones técnicas.
RF-004 | ET-07 | Cubierto | Trazado a una o más especificaciones técnicas.
RF-008 | ET-45 | Cubierto | La especificación establece la arquitectura funcional necesaria para modificar y reducir movimientos no deseados mediante ADCS.
RF-009 | ET-04, ET-05 | Cubierto | Trazado a una o más especificaciones técnicas.
RF-010 | ET-36 | Cubierto | Trazado a una o más especificaciones técnicas.
RF-011 | ET-11, ET-37 | Cubierto | Trazado a una o más especificaciones técnicas.
RF-013 | ET-38 | Cubierto | Trazado a una o más especificaciones técnicas.
RF-015 | ET-02, ET-03, ET-06, ET-41 | Cubierto | Trazado a una o más especificaciones técnicas.
RI-001 | ET-08 | Cubierto | Trazado a una o más especificaciones técnicas.
RI-002 | ET-08, ET-09, ET-10 | Cubierto | Trazado a una o más especificaciones técnicas.
RI-003 | ET-35, ET-39, ET-40 | Cubierto | Trazado a una o más especificaciones técnicas.
RN-001 | ET-24, ET-25, ET-26 | Cubierto | Trazado a una o más especificaciones técnicas.
RNF-002 | ET-28, ET-29 | Cubierto | Trazado a una o más especificaciones técnicas.
RNF-003 | ET-11, ET-27, ET-36, ET-37 | Cubierto | Trazado a una o más especificaciones técnicas.
RNF-004 | ET-34 | Cubierto | Trazado a una o más especificaciones técnicas.
RNF-005 | ET-33 | Cubierto | Trazado a una o más especificaciones técnicas.
RNF-006 | ET-30 | Cubierto | Trazado a una o más especificaciones técnicas.
RNF-007 | ET-35 | Cubierto | Trazado a una o más especificaciones técnicas.
RR-001 | ET-12, ET-13, ET-15 | Cubierto | Trazado a una o más especificaciones técnicas.
RR-005 | ET-17, ET-18, ET-19 | Cubierto | Trazado a una o más especificaciones técnicas.
RR-006 | ET-16 | Cubierto | Trazado a una o más especificaciones técnicas.
RR-007 | ET-20, ET-22, ET-23 | Cubierto | Trazado a una o más especificaciones técnicas.
RR-008 | ET-21 | Cubierto | Trazado a una o más especificaciones técnicas.
RR-009 | ET-14 | Cubierto | Trazado a una o más especificaciones técnicas.
RF-005 | — | Verificación/arquitectura | Se verifica principalmente mediante arquitectura, FMECA, HW-SW, protocolo o documentación normativa; no exige necesariamente un valor numérico independiente en esta etapa.
RF-006 | — | Verificación/arquitectura | Se verifica principalmente mediante arquitectura, FMECA, HW-SW, protocolo o documentación normativa; no exige necesariamente un valor numérico independiente en esta etapa.
RF-007 | — | Verificación/arquitectura | Se verifica principalmente mediante arquitectura, FMECA, HW-SW, protocolo o documentación normativa; no exige necesariamente un valor numérico independiente en esta etapa.
RF-012 | — | Verificación/arquitectura | Se verifica principalmente mediante arquitectura, FMECA, HW-SW, protocolo o documentación normativa; no exige necesariamente un valor numérico independiente en esta etapa.
RF-014 | — | Verificación/arquitectura | Se verifica principalmente mediante arquitectura, FMECA, HW-SW, protocolo o documentación normativa; no exige necesariamente un valor numérico independiente en esta etapa.
RF-016 | — | Verificación/arquitectura | Se verifica principalmente mediante arquitectura, FMECA, HW-SW, protocolo o documentación normativa; no exige necesariamente un valor numérico independiente en esta etapa.
RF-017 | — | Verificación/arquitectura | Se verifica principalmente mediante arquitectura, FMECA, HW-SW, protocolo o documentación normativa; no exige necesariamente un valor numérico independiente en esta etapa.
RF-018 | — | Verificación/arquitectura | Se verifica principalmente mediante arquitectura, FMECA, HW-SW, protocolo o documentación normativa; no exige necesariamente un valor numérico independiente en esta etapa.
RF-019 | — | Verificación/arquitectura | Se verifica principalmente mediante arquitectura, FMECA, HW-SW, protocolo o documentación normativa; no exige necesariamente un valor numérico independiente en esta etapa.
RI-004 | — | Verificación/arquitectura | Se verifica principalmente mediante arquitectura, FMECA, HW-SW, protocolo o documentación normativa; no exige necesariamente un valor numérico independiente en esta etapa.
RNF-001 | — | Verificación/arquitectura | Se verifica principalmente mediante arquitectura, FMECA, HW-SW, protocolo o documentación normativa; no exige necesariamente un valor numérico independiente en esta etapa.
RNF-008 | — | Verificación/arquitectura | Se verifica principalmente mediante arquitectura, FMECA, HW-SW, protocolo o documentación normativa; no exige necesariamente un valor numérico independiente en esta etapa.
RA-002 | ET-46 | Cubierto | Se establece el criterio de considerar radiación en componentes críticos sin exigir en esta práctica un análisis aeroespacial avanzado.
RA-004 | — | Verificación/arquitectura | Se verifica principalmente mediante arquitectura, FMECA, HW-SW, protocolo o documentación normativa; no exige necesariamente un valor numérico independiente en esta etapa.
RR-002 | — | Verificación/arquitectura | Se verifica principalmente mediante arquitectura, FMECA, HW-SW, protocolo o documentación normativa; no exige necesariamente un valor numérico independiente en esta etapa.
RR-003 | — | Verificación/arquitectura | Se verifica principalmente mediante arquitectura, FMECA, HW-SW, protocolo o documentación normativa; no exige necesariamente un valor numérico independiente en esta etapa.
RR-004 | — | Verificación/arquitectura | Se verifica principalmente mediante arquitectura, FMECA, HW-SW, protocolo o documentación normativa; no exige necesariamente un valor numérico independiente en esta etapa.
RN-002 | — | Verificación/arquitectura | Se verifica principalmente mediante arquitectura, FMECA, HW-SW, protocolo o documentación normativa; no exige necesariamente un valor numérico independiente en esta etapa.
RN-003 | — | Verificación/arquitectura | Se verifica principalmente mediante arquitectura, FMECA, HW-SW, protocolo o documentación normativa; no exige necesariamente un valor numérico independiente en esta etapa.

Sheet: Distribucion HW-SW
ID | Función | Implementación | Recursos HW | Responsabilidad SW | Procesamiento | Memoria | Almacenamiento | Interfaces | Temporización | TBD / por cerrar
HW/SW-01 | Recepción, decodificación y ejecución de telecomandos | HW + SW | Unidad de procesamiento, interfaz de comunicación con TT&C, memoria/buffers para recepción. | Recepción y validación de tramas, identificación de comandos, validación de parámetros, ejecución, generación de confirmación de éxito/fallo. | Medio | Código, tablas y buffers de recepción | Eventual para registros | TT&C ↔ OBC; OBC → subsistemas | Relevante; valor TBD | Protocolo concreto, interfaz física y requisito temporal exacto.
HW/SW-02 | Gestión de modos, detección y recuperación de fallos | HW + SW | Unidad de procesamiento, señales de estado de EPS, ADCS, payload, almacenamiento y comunicaciones; mecanismos de supervisión/protección que se definan. | Máquina de estados, condiciones de entrada/salida, detección de anomalías, transición a modo seguro, recuperación, reporte de fallos. | Medio | Estados, parámetros y tablas | Eventual para eventos/fallos | EPS/ADCS/Payload/Storage/TT&C ↔ OBC; OBC → subsistemas | Supervisión y transición; valor TBD | Mecanismo específico de watchdog/protección y tiempos de respuesta.
HW/SW-03 | Determinación/estimación de actitud | HW + SW | Sensores de actitud,electrónica de adquisición/interfaz,unidad de procesamiento, alimentación. | Adquisición; validación; procesamiento; estimación/fusión de actitud; actualización de la información de orientación. | Medio/alto | Variables de estimación y buffers | No esencial; depende de telemetría | Sensores → OBC/ADCS; estimación → controlador | Crítica para la estimación; valor TBD | Sensores concretos, algoritmo de estimación y tasas de actualización.
HW/SW-04 | Control de actitud | HW + SW | Actuadores de actitud, electrónica de accionamiento, unidad de procesamiento, interfaces de control. | Cálculo de error; algoritmo de control; generación de comandos a actuadores; gestión de modos de control. | Medio/alto | Variables y parámetros de control | No esencial | Estimación → controlador; controlador → actuadores; ADCS ↔ OBC | Crítica para el control; valor TBD | Tipo de actuadores y algoritmo de control.
HW/SW-05 | Gestión y supervisión de potencia | HW + SW | Generación solar, batería, carga, conversión, distribución, protección,medición eléctrica y conmutación necesaria. | Supervisión; adquisición de variables; gestión de estados; reporte; detección de condiciones anómalas; coordinación con modo seguro. | Bajo/medio | Estados y parámetros | Eventual para eventos | Paneles → EPS; EPS ↔ batería; EPS → cargas; EPS → OBC | Supervisión/protección; valor TBD | Arquitectura concreta de conversión, carga, medición y control.
HW/SW-06 | Control y adquisición de imágenes multiespectrales | HW + SW | Cámara/sensor multiespectral; óptica; elementos espectrales por seleccionar; electrónica de interfaz; alimentación; camino de datos. | Configuración; inicio/finalización de adquisición; control de parámetros; recepción; identificación de capturas; entrega al almacenamiento. | Medio/alto | Buffers de adquisición | Alto | OBC → cámara; cámara → OBC/almacenamiento; ADCS → lógica de captura | Crítica para adquisición; valor TBD | Bandas, resolución, profundidad radiométrica, interfaz, formato y tasa de datos.
HW/SW-07 | Gestión y almacenamiento de datos | HW + SW | Memoria no volátil; interfaz de memoria; alimentación y protección. | Lectura/escritura; organización; identificación; gestión de espacio; detección de errores; preparación para transmisión. | Medio | Buffers de lectura/escritura | Alto/crítico | Payload → almacenamiento; OBC ↔ almacenamiento; almacenamiento → TT&C | Depende de adquisición y descarga; valor TBD | Tecnología/capacidad de memoria, estrategia de organización y requisitos de integridad.
HW/SW-08 | Comunicación TT&C | HW + SW | Transceptor(es); antena(s); electrónica/interfaz RF; interfaz digital con OBC; alimentación. | Protocolo; transmisión/recepción; framing; identificación; detección de errores; gestión de comandos y telemetría; acceso a datos de payload. | Medio | Buffers de transmisión/recepción | Acceso a datos de payload | OBC ↔ TT&C; TT&C ↔ estación terrestre; almacenamiento → TT&C | Dependiente de ventanas de comunicación; valores TBD | Banda/frecuencia, transceptor, antena, protocolo, tasa y parámetros de enlace.
HW/SW-09 | Adquisición y generación de telemetría | HW + SW | Sensores/canales de adquisición para tensión, corriente, temperatura y estados de subsistemas; acondicionamiento/interfaz. | Adquisición; conversión; validación; organización; identificación; empaquetado; preparación para transmisión; detección de condiciones anómalas. | Bajo/medio | Buffers | Eventual según estrategia de registro | EPS/ADCS/Payload/Storage → OBC; OBC → TT&C | Dependiente de frecuencia de actualización; valor TBD | Sensores/canales concretos y frecuencia de actualización.

Sheet: Subsistemas
SUBSISTEMAS FUNCIONALES
ID | Subsistema | Función principal
SUB-01 | Procesamiento y C&DH | Coordinar la operación del satélite, ejecutar funciones de software de vuelo, gestionar modos, comandos, telemetría, FDIR y coordinación de subsistemas.
SUB-02 | EPS | Generar, almacenar, convertir, distribuir y supervisar la energía eléctrica del satélite.
SUB-03 | ADCS | Determinar y modificar la orientación del satélite mediante sensores, procesamiento y actuadores.
SUB-04 | Payload | Adquirir imágenes multiespectrales para la misión.
SUB-05 | Almacenamiento y gestión de datos | Recibir, conservar, organizar y entregar imágenes y datos para su posterior transmisión.
SUB-06 | TT&C | Recibir telecomandos y transmitir telemetría e imágenes entre el satélite y la estación terrestre.
RELACIONES ENTRE SUBSISTEMAS
Origen | Destino | Tipo de relación | Propósito
SUB-01 C&DH | SUB-02 EPS | Datos / control | Supervisión y gestión del estado de potencia.
SUB-01 C&DH | SUB-03 ADCS | Datos / control | Órdenes, modos, coordinación y recepción del estado de actitud.
SUB-01 C&DH | SUB-04 Payload | Datos / control | Configuración, control de adquisición y recepción de estado/datos.
SUB-01 C&DH | SUB-05 Storage | Datos / control | Gestión del almacenamiento y acceso a datos.
SUB-01 C&DH | SUB-06 TT&C | Datos / control | Gestión de telecomandos, telemetría y comunicaciones.
SUB-04 Payload | SUB-05 Storage | Datos | Transferencia y conservación de imágenes.
SUB-05 Storage | SUB-06 TT&C | Datos | Entrega de datos de carga útil para su transmisión.
FLUJOS DE POTENCIA, DATOS Y CONTROL
Origen | Destino | Tipo de flujo | Propósito
Paneles solares | EPS | Potencia | Generación de energía eléctrica.
EPS | C&DH | Potencia | Alimentación del procesamiento.
EPS | ADCS | Potencia | Alimentación del control de actitud.
EPS | Payload | Potencia | Alimentación de la carga útil.
EPS | Storage | Potencia | Alimentación del almacenamiento.
EPS | TT&C | Potencia | Alimentación del sistema de comunicaciones.
TT&C | C&DH | Datos / control | Telecomandos provenientes de la estación terrestre.
C&DH | TT&C | Datos / control | Telemetría y gestión de transmisión.
C&DH | ADCS | Control / datos | Órdenes y modos de control de actitud.
ADCS | C&DH | Datos | Estado e información de actitud.
C&DH | Payload | Control / datos | Configuración e inicio de adquisición.
Payload | Storage | Datos | Imágenes y datos asociados.
C&DH | Storage | Datos / control | Gestión de almacenamiento.
Storage | TT&C | Datos | Datos de carga útil para descarga.
ELEMENTOS EXTERNOS Y ELEMENTOS FUNCIONALES ASOCIADOS
Elemento | Subsistema relacionado | Relación / función
Estación terrestre | TT&C | Comandos hacia el satélite; recepción de telemetría e imágenes.
Paneles solares | EPS | Generación de energía eléctrica.
Sensores ADCS | ADCS | Información para determinar la orientación.
Actuadores ADCS | ADCS | Modificación de la orientación del satélite.
Cámara / carga útil | Payload | Adquisición de imágenes multiespectrales.
Batería | EPS | Almacenamiento de energía.

Sheet: Alternativas
MATRIZ DE ALTERNATIVAS DESARROLLADAS
ID | Decisión | Alternativa | Descripción arquitectónica | Ventajas | Limitaciones / compromisos | Impactos principales | Compatibilidad / restricciones | Qué queda para etapas posteriores
A-01 | Procesamiento | C&DH centralizado | El OBC/C&DH concentra gestión de modos, FDIR, telemetría, control del payload, almacenamiento, coordinación ADCS, supervisión EPS y gestión TT&C. | Menor cantidad de procesadores; menor complejidad de sincronización; gestión global más sencilla. | Mayor concentración de funciones en C&DH; mayor dependencia del procesamiento central; mayor concentración de interfaces. | Carga de procesamiento concentrada en C&DH; almacenamiento y comunicaciones dependen del nodo central. | Compatible con RF-005, RF-006, RF-019 y con la función central de coordinación establecida en el proyecto. | Se comparará en Selección y Comparación de arquitecturas frente a procesamiento local complementario.
A-02 | Procesamiento | C&DH central + procesamiento local | Se mantiene el C&DH como coordinador principal, pero algunos subsistemas ejecutan localmente tareas específicas de adquisición, procesamiento o supervisión. | Descarga de tareas del OBC; mayor modularidad funcional; posibilidad de reducir determinados tráficos internos. | Más electrónica; mayor complejidad de interfaces, sincronización y FDIR; consumo potencialmente mayor. | Distribuye carga computacional; puede reducir tráfico hacia C&DH en funciones locales. | Mantiene el requisito de procesamiento central; no elimina la coordinación central. | Se comparará por consumo, complejidad, procesamiento, integración y riesgo.
A-03 | División HW/PCB | Arquitectura integrada de 2 PCB | PCB de potencia (EPS) + PCB de aviónica que integra C&DH e interfaces principales de ADCS, Payload, Storage y TT&C. | Menos tarjetas y conectores; integración más directa; menor cantidad de interconexiones PCB-PCB. | Mayor densidad electrónica; mayor concentración funcional; mayor interacción entre dominios de potencia, digital y comunicaciones. | Concentra procesamiento e interfaces en una tarjeta de aviónica; EPS queda separado. | Compatible con la exigencia de considerar una PCB de potencia y una PCB de cómputo. | La división definitiva debe comprobar espacio, potencia, interfaces, EMC, ensamblaje y prueba.
A-04 | División HW/PCB | Arquitectura modular de 3 o más PCB | Separa funcionalmente EPS, C&DH y comunicaciones/interfaz, pudiendo mantener Payload/ADCS como módulos según la partición final. | Mayor modularidad; facilita pruebas por bloque; permite separar dominios sensibles. | Más conectores e interfaces; mayor complejidad de integración; posible aumento de volumen de interconexiones. | Distribuye funciones y puede reducir interferencias entre dominios, pero aumenta las interconexiones. | Compatible con el proyecto; la guía pide considerar división de hardware entre diferentes PCB. | Debe comprobarse contra espacio, masa, potencia, EMC, ensamblaje y prueba.
A-05 | Comunicaciones internas | Organización centralizada | Los subsistemas se relacionan principalmente con C&DH; el OBC coordina el intercambio de información. | Estructura sencilla; control central de datos y estados; menor complejidad conceptual. | Más interfaces concentradas en C&DH; mayor dependencia del nodo central; posible concentración de tráfico. | El tráfico interno converge principalmente en C&DH. | Coherente con RF-019, donde el OBC supervisa EPS, ADCS, Payload, Storage y comunicaciones. | El protocolo concreto se mantiene TBD hasta cerrar arquitectura e interfaces.
A-06 | Comunicaciones internas | Organización modular | Se establece una interconexión interna más distribuida, permitiendo que determinadas funciones intercambien información sin que todo el tráfico dependa de una única ruta central. | Mayor modularidad; puede reducir determinadas cargas del OBC; facilita expansión funcional. | Mayor complejidad de arbitraje, prioridades, sincronización y gestión de fallos; más interfaces. | Distribuye tráfico entre subsistemas, pero aumenta la necesidad de definir responsabilidades de comunicación. | Compatible con la guía como alternativa de organización interna; no fija todavía un protocolo específico. | La selección de SPI/I²C/UART/CAN u otro se mantiene TBD según ET-40.
A-07 | Payload | Payload integrado | La electrónica de la cámara/carga útil se integra estrechamente con C&DH; el procesamiento general permanece centralizado. | Menor cantidad de electrónica independiente; coordinación sencilla; menor complejidad funcional. | Mayor dependencia de C&DH; el procesamiento de datos puede incrementar la carga central; interfaces de datos concentradas. | Datos de cámara pasan hacia procesamiento/almacenamiento central. | Compatible con la cámara multiespectral y con la arquitectura de procesamiento central. | La tecnología de cámara, bandas y formato de datos permanecen TBD.
A-08 | Payload | Payload con electrónica local | La carga útil incorpora electrónica local para adquisición, gestión de datos y, si se justifica posteriormente, preprocesamiento. | Descarga determinadas tareas del C&DH; mayor autonomía funcional del payload; posible preprocesamiento. | Más electrónica, consumo y complejidad; requiere definir interfaces de alta velocidad. | Parte del procesamiento y gestión de datos ocurre cerca de la cámara antes del almacenamiento/transmisión. | Compatible siempre que C&DH conserve la coordinación de la misión. | La profundidad, formato y volumen de datos siguen abiertos y deben cerrarse con la cámara seleccionada.
A-09 | EPS | EPS con distribución centralizada | Generación solar, almacenamiento en batería, conversión y distribución concentradas en el EPS, con supervisión desde C&DH. | Arquitectura sencilla; menor cantidad de bloques; supervisión centralizada. | Mayor concentración funcional en EPS; una falla en una etapa central puede afectar varias cargas; menor flexibilidad. | Potencia generada y distribuida desde un bloque central hacia C&DH, ADCS, Payload, Storage y TT&C. | Coherente con la generación solar, batería y entrada a modo seguro dependiente de condiciones de energía. | El número y valores de rieles de alimentación permanecen TBD hasta seleccionar componentes (ET-38).
A-10 | EPS | EPS modular/distribuido | Gestión de batería y distribución con dominios de conversión/adaptación asociados a diferentes cargas. | Mayor flexibilidad; adaptación por carga; posibilidad de aislar dominios. | Más convertidores y componentes; mayor complejidad, puntos potenciales de fallo y exigencia EMC. | Distribuye la conversión y gestión de potencia entre dominios de carga. | Compatible con la necesidad de supervisar y proteger cargas y con la futura definición de rieles. | Los valores de tensión y arquitectura de conversión deben derivarse de los componentes seleccionados.
A-11 | TT&C | Un enlace bidireccional | Un sistema de comunicaciones gestiona telecomandos, telemetría y datos de carga útil. | Menor hardware; menor consumo potencial; menor complejidad. | El mismo sistema debe atender operación y descarga de imágenes; la tasa disponible puede limitar la misión. | Telecomandos y telemetría llegan/salen por el mismo sistema que transporta datos de payload. | Compatible con RI-001, que exige enlace bidireccional con la estación de Medellín. | La frecuencia, tasa y margen se deben cerrar mediante presupuesto de enlace (RI-002).
A-12 | TT&C | Enlaces diferenciados | Se separa funcionalmente el enlace de operación/telemetría de un enlace de mayor capacidad para datos de carga útil. | Permite separar tráfico crítico y datos; puede facilitar mayor capacidad para imágenes. | Más hardware RF; mayor consumo, complejidad, masa/volumen e integración. | Separa rutas de datos según función, con mayor capacidad potencial para payload. | Compatible con la guía, que permite estudiar uno o varios enlaces con tierra. | No se fija todavía UHF, banda S ni otra banda; deben justificarse mediante presupuesto de enlace.
A-13 | ADCS | ADCS activo con magnetorquers | Sensores de actitud + estimación/control + magnetorquers como actuadores para el control de actitud de la misión; el nivel de estabilización y la precisión alcanzable quedan condicionados al desempeño que se cierre posteriormente. | Menor complejidad mecánica; ausencia de actuadores rotativos; arquitectura relativamente sencilla. | Los magnetorquers dependen del campo magnético local y su capacidad de control está condicionada por la dinámica orbital. El desempeño de estabilización y apuntamiento deberá demostrarse posteriormente mediante el análisis de desempeño del ADCS. | Requiere adquisición de sensores, procesamiento de estimación/control y alimentación de actuadores. | Compatible con RF-007, RF-008 y RF-009; mantiene ADCS activo y sin propulsión. | La selección concreta de sensores y el desempeño de apuntamiento se cierran posteriormente.
A-14 | ADCS | ADCS activo con magnetorquers + actuación inercial | Sensores + estimación/control + magnetorquers + actuadores inerciales adicionales. | Mayor capacidad y flexibilidad de control; posibilidad de complementar mecanismos de actuación. | Mayor masa, consumo y complejidad; introduce partes móviles y mayor exigencia de integración. | Añade recursos de potencia, control y estructura asociados a la actuación inercial. | Compatible con RF-008 y RF-009; no introduce propulsión. | No se fija todavía una tecnología/componente específico de actuador inercial.
SUBDECISIONES QUE NO SE ELEVAN A ALTERNATIVAS PRINCIPALES
Tema | Estado en fase de Planteamiento | Razón | Cierre previsto
Paneles solares fijos/desplegables | Subdecisión EPS | La guía pide alternativas arquitectónicas; el tipo de panel puede estudiarse dentro de la arquitectura EPS. | Comparación y selección de arquitectura, junto con presupuesto de potencia y restricciones mecánicas.
Filtros fijos/rueda de filtros | Subdecisión Payload | La guía indica que no es necesario crear alternativas para cada componente. | Cuando se concrete la cámara y la misión espectral.
Protocolos internos (SPI/I²C/UART/CAN u otro) | TBD | La matriz definitiva indica que depende de la arquitectura y de las necesidades de cada interfaz (ET-40). | Después de seleccionar arquitectura e interfaces.
Bandas/frecuencias de TT&C | TBD | No deben fijarse sin presupuesto de enlace y necesidades de datos. | Comparación y selección de arquitectura mediante presupuesto de enlace.
Niveles lógicos y rieles de alimentación | TBD | Dependen de los componentes extremos y de la arquitectura seleccionada. | Antes del esquemático/ICD definitivo.
Sensores y actuadores concretos de ADCS | TBD | El proyecto deja la selección al equipo; aquí solo se comparan arquitecturas generales. | Después de selección y presupuesto de desempeño ADCS.
Cámara, bandas y formato de datos | TBD | La matriz definitiva mantiene estas especificaciones abiertas hasta seleccionar la cámara. | Con selección de payload y presupuesto de datos.
MAPA VISUAL DE LAS ALTERNATIVAS
Representación conceptual para facilitar la posterior comparación. No constituye selección.

Sheet: Selección
8.1–8.7 — MATRICES DE COMPARACIÓN
ID | Decisión | Criterio | Peso (%) | A alternativa | B alternativa | Justificación A | Justificación B | Calif. A (1–5) | Calif. B (1–5)
8.1 | Procesamiento | Cumplimiento funcional | 25 | A-01 — C&DH centralizado | A-02 — C&DH central + procesamiento local | El proyecto exige un sistema de procesamiento central que supervise las funciones principales. | Ambas alternativas pueden cumplir la función central requerida. | 5 | 5
8.1 | Procesamiento | Complejidad | 20 | A-01 — C&DH centralizado | A-02 — C&DH central + procesamiento local | Menor cantidad de bloques y coordinación entre procesadores. | Añade procesadores/interconexiones y coordinación adicional. | 5 | 3
8.1 | Procesamiento | Integración | 15 | A-01 — C&DH centralizado | A-02 — C&DH central + procesamiento local | Arquitectura directamente alineada con el esquema central. | Requiere integrar y coordinar procesamiento distribuido. | 5 | 3
8.1 | Procesamiento | Potencia | 10 | A-01 — C&DH centralizado | A-02 — C&DH central + procesamiento local | Evita consumo asociado a procesamiento local adicional. | Introduce consumo adicional potencial. | 5 | 3
8.1 | Procesamiento | Interfaces | 10 | A-01 — C&DH centralizado | A-02 — C&DH central + procesamiento local | Menos interfaces de coordinación entre procesadores. | Mayor número de interfaces internas. | 4 | 3
8.1 | Procesamiento | Riesgo técnico | 10 | A-01 — C&DH centralizado | A-02 — C&DH central + procesamiento local | Arquitectura más directa respecto al requisito documentado. | Mayor complejidad de integración. | 4 | 3
8.1 | Procesamiento | Distribución de recursos | 10 | A-01 — C&DH centralizado | A-02 — C&DH central + procesamiento local | Centraliza recursos; puede concentrar carga. | Permite distribuir carga entre nodos. | 3 | 4
8.2 | División HW/PCB | Cumplimiento | 20 | A-03 — 2 PCB | A-04 — 3 o más PCB | Es compatible con la partición mínima considerada: potencia y cómputo. | También es compatible. | 5 | 5
8.2 | División HW/PCB | Complejidad | 20 | A-03 — 2 PCB | A-04 — 3 o más PCB | Menor número de tarjetas e interconexiones. | Mayor cantidad de tarjetas e interconexiones. | 5 | 3
8.2 | División HW/PCB | Integración/prueba | 15 | A-03 — 2 PCB | A-04 — 3 o más PCB | Menos tarjetas que integrar, aunque concentra funciones. | La modularidad puede facilitar pruebas por bloques. | 4 | 5
8.2 | División HW/PCB | Integridad de señal/EMC | 15 | A-03 — 2 PCB | A-04 — 3 o más PCB | Exige buena partición física y de layout dentro de las dos tarjetas. | Mayor libertad para separar dominios sensibles. | 3 | 4
8.2 | División HW/PCB | Interconexiones/espacio | 15 | A-03 — 2 PCB | A-04 — 3 o más PCB | Menos conectores e interconexiones. | Mayor número de interconexiones. | 4 | 3
8.2 | División HW/PCB | Modularidad/aislamiento | 15 | A-03 — 2 PCB | A-04 — 3 o más PCB | Menor aislamiento físico entre funciones. | Mayor separación de funciones. | 3 | 4
8.3 | Comunicaciones internas | Cumplimiento | 20 | A-05 — Organización centralizada | A-06 — Organización modular | Coherente con el C&DH central requerido. | También puede cumplir. | 5 | 5
8.3 | Comunicaciones internas | Complejidad | 20 | A-05 — Organización centralizada | A-06 — Organización modular | Menor estructura de coordinación entre nodos. | Introduce mayor estructura de comunicación. | 4 | 3
8.3 | Comunicaciones internas | Interfaces | 15 | A-05 — Organización centralizada | A-06 — Organización modular | Menor cantidad de interfaces de coordinación. | Más interfaces entre módulos. | 4 | 3
8.3 | Comunicaciones internas | Coherencia con C&DH | 15 | A-05 — Organización centralizada | A-06 — Organización modular | Coincide directamente con la arquitectura central. | Se aleja de la organización central seleccionada. | 5 | 3
8.3 | Comunicaciones internas | Integración | 15 | A-05 — Organización centralizada | A-06 — Organización modular | Integración directa con el C&DH. | Mayor trabajo de integración. | 5 | 3
8.3 | Comunicaciones internas | Modularidad/aislamiento | 15 | A-05 — Organización centralizada | A-06 — Organización modular | Menor aislamiento funcional. | Mayor modularidad. | 3 | 4
8.4 | Payload | Cumplimiento | 25 | A-07 — Payload integrado | A-08 — Electrónica local | Cumple la cadena cámara → procesamiento → almacenamiento → transmisión. | También puede cumplir. | 5 | 5
8.4 | Payload | Complejidad | 20 | A-07 — Payload integrado | A-08 — Electrónica local | Menor cantidad de electrónica local adicional. | Añade electrónica y coordinación local. | 5 | 3
8.4 | Payload | Potencia | 15 | A-07 — Payload integrado | A-08 — Electrónica local | Evita consumo adicional de procesamiento local. | Puede aumentar la demanda de potencia. | 5 | 3
8.4 | Payload | Integración | 15 | A-07 — Payload integrado | A-08 — Electrónica local | Integra el payload con el C&DH central. | Requiere integrar electrónica local adicional. | 5 | 3
8.4 | Payload | Escalabilidad de manejo de datos | 15 | A-07 — Payload integrado | A-08 — Electrónica local | Menos capacidad local dedicada para procesamiento. | Puede distribuir procesamiento del payload. | 3 | 5
8.4 | Payload | Riesgo | 10 | A-07 — Payload integrado | A-08 — Electrónica local | Arquitectura más directa. | Mayor complejidad de integración. | 4 | 3
8.5 | EPS | Cumplimiento | 25 | A-09 — Distribución centralizada | A-10 — EPS modular/distribuido | Cubre generación, almacenamiento, conversión, distribución, protección y supervisión. | También puede cubrirlas. | 5 | 5
8.5 | EPS | Complejidad | 20 | A-09 — Distribución centralizada | A-10 — EPS modular/distribuido | Menor cantidad de bloques de gestión distribuida. | Mayor estructura de coordinación. | 5 | 3
8.5 | EPS | Gestión de potencia | 20 | A-09 — Distribución centralizada | A-10 — EPS modular/distribuido | Centraliza la gestión. | Puede distribuir funciones de gestión. | 3 | 4
8.5 | EPS | Espacio/interconexiones | 15 | A-09 — Distribución centralizada | A-10 — EPS modular/distribuido | Menos módulos e interconexiones. | Más módulos e interconexiones. | 5 | 4
8.5 | EPS | Integración | 10 | A-09 — Distribución centralizada | A-10 — EPS modular/distribuido | Integración directa con el resto de aviónica. | Mayor complejidad de integración. | 4 | 3
8.5 | EPS | Protección/aislamiento | 10 | A-09 — Distribución centralizada | A-10 — EPS modular/distribuido | Puede implementar protección centralizada. | Puede aislar funciones por módulos. | 4 | 4
8.6 | TT&C | Cumplimiento | 25 | A-11 — Un enlace bidireccional | A-12 — Enlaces diferenciados | Puede cumplir el enlace bidireccional exigido, sujeto a presupuesto. | También puede cumplir. | 5 | 5
8.6 | TT&C | Capacidad de datos | 20 | A-11 — Un enlace bidireccional | A-12 — Enlaces diferenciados | Debe validarse contra volumen de imágenes, tiempo de contacto y tasa requerida. | Ofrece mayor flexibilidad potencial para separar funciones. | 3 | 5
8.6 | TT&C | Potencia | 20 | A-11 — Un enlace bidireccional | A-12 — Enlaces diferenciados | Menor cantidad de cadenas RF. | Más cadenas RF potencialmente. | 5 | 3
8.6 | TT&C | Masa/volumen | 15 | A-11 — Un enlace bidireccional | A-12 — Enlaces diferenciados | Menos hardware RF. | Mayor hardware RF potencial. | 5 | 3
8.6 | TT&C | Integración | 10 | A-11 — Un enlace bidireccional | A-12 — Enlaces diferenciados | Menor cantidad de cadenas e interfaces. | Mayor complejidad de integración. | 4 | 2
8.6 | TT&C | Riesgo | 10 | A-11 — Un enlace bidireccional | A-12 — Enlaces diferenciados | Arquitectura más simple. | Más elementos e interfaces. | 4 | 3
8.7 | ADCS | Cumplimiento funcional | 25 | A-13 — Magnetorquers | A-14 — Magnetorquers + actuación inercial | Incluye sensores y actuadores para determinar y modificar orientación. | También cumple la estructura funcional. | 5 | 5
8.7 | ADCS | Potencia | 20 | A-13 — Magnetorquers | A-14 — Magnetorquers + actuación inercial | Evita consumo adicional de actuación inercial. | Añade consumo asociado a actuación adicional. | 4 | 3
8.7 | ADCS | Masa/volumen | 20 | A-13 — Magnetorquers | A-14 — Magnetorquers + actuación inercial | Menor hardware adicional. | Añade hardware adicional. | 5 | 3
8.7 | ADCS | Complejidad | 15 | A-13 — Magnetorquers | A-14 — Magnetorquers + actuación inercial | Arquitectura de actuación más sencilla. | Mayor complejidad de control e integración. | 5 | 3
8.7 | ADCS | Integración | 10 | A-13 — Magnetorquers | A-14 — Magnetorquers + actuación inercial | Menor cantidad de elementos. | Mayor cantidad de elementos. | 4 | 3
8.7 | ADCS | Riesgo | 10 | A-13 — Magnetorquers | A-14 — Magnetorquers + actuación inercial | Menos elementos a integrar. | Mayor complejidad de integración. | 4 | 3
RESULTADOS DE LAS COMPARACIONES
ID | Decisión | Puntaje A | Puntaje B | Selección | Estado | Comentario / condición
8.1 | Procesamiento | 4.6 | 3.6 | A-01 — C&DH centralizado | CERRADO | Se selecciona A-01. El procesamiento local queda como posibilidad de reapertura si el dimensionamiento posterior demuestra que el C&DH central no satisface la carga requerida.
8.2 | División HW/PCB | 4.1 | 4 | A-03 — 2 PCB | CERRADO | Se selecciona A-03 por su menor complejidad e interconexión. Condición: el layout debe preservar los dominios de potencia, digital, cámara, memoria y RF.
8.3 | Comunicaciones internas | 4.35 | 3.55 | A-05 — Organización centralizada | CERRADO | Se selecciona A-05. El protocolo concreto permanece TBD y deberá definirse cuando se concreten las interfaces.
8.4 | Payload | 4.6 | 3.8 | A-07 — Payload integrado | CERRADO | Se selecciona A-07. Condición: si el presupuesto posterior de datos demuestra que la carga supera la capacidad razonable del C&DH, la decisión podrá reabrirse.
8.5 | EPS | 4.4 | 3.95 | A-09 — Distribución centralizada | CERRADO | Se selecciona A-09. Esta decisión no define todavía si los paneles serán fijos o desplegables.
8.6 | TT&C | 4.4 | 3.8 | A-11 — Un enlace bidireccional (condicionado) | CONDICIONADO | Selección provisional de arquitectura base. NO se cierra definitivamente hasta validar volumen de datos, duración de pases y tasa de bajada mediante el presupuesto de comunicaciones/enlace.
8.7 | ADCS | 4.6 | 3.4 | A-13 — Magnetorquers | CERRADO | Se selecciona A-13. La selección concreta de sensores, estimador y actuadores debe demostrar posteriormente el desempeño de orientación requerido.
Justificación de los pesos de evaluación |  | Los pesos utilizados en las matrices de selección se establecieron considerando las restricciones y objetivos definidos para la misión CubeSat 1U y el alcance de la Práctica 3. El criterio de cumplimiento funcional recibe una ponderación alta debido a que la alternativa seleccionada debe satisfacer las funciones principales de la misión. La complejidad e integración reciben también una ponderación relevante debido a que la arquitectura debe ser implementable y mantener una integración coherente entre subsistemas y PCBs. La potencia, masa, volumen e interfaces se consideran debido a las restricciones físicas y energéticas propias de un CubeSat 1U. Finalmente, el riesgo y la distribución arquitectónica permiten considerar las consecuencias de implementación y las dependencias entre subsistemas. Los pesos no representan una medición física, sino una herramienta de decisión para comparar de forma trazable las alternativas consideradas.
ARQUITECTURA RESULTANTE
Bloque | Decisión seleccionada | Implicación arquitectónica
Procesamiento | A-01 — C&DH centralizado | El C&DH coordina EPS, ADCS, payload, almacenamiento y comunicaciones.
HW/PCB | A-03 — 2 PCB | PCB 1 orientada a EPS; PCB 2 orientada a aviónica/C&DH y sus interfaces.
Comunicaciones internas | A-05 — Centralizada | El C&DH actúa como coordinador central; protocolos concretos quedan TBD.
Payload | A-07 — Integrado | La cámara se integra con el procesamiento central y el almacenamiento.
EPS | A-09 — Centralizado | Gestión central de generación, batería, conversión, distribución, protección y supervisión.
TT&C | A-11 — Un enlace bidireccional | Arquitectura base; requiere validación mediante presupuesto de datos/enlace.
ADCS | A-13 — Magnetorquers | Arquitectura activa basada en sensores + estimación/control + magnetorquers.
LIMITACIONES, TBD Y CONDICIONES DE CIERRE
Tema | Estado | Condición / dependencia
TT&C | TBD / condicionado | Validar volumen de imágenes, duración de pases y tasa de bajada antes de cerrar definitivamente A-11.
Payload | Condicionado | Validar resolución, bandas, profundidad radiométrica, formato/compresión, volumen de datos y carga sobre C&DH.
ADCS | Condicionado a validación de desempeño | La arquitectura se selecciona; la selección de sensores, estimador y actuadores debe demostrar el desempeño requerido.
PCB | Cerrado con condición de layout | Preservar integridad de señal y alimentación, especialmente en cámara, memoria, convertidores y RF.
Protocolos internos | TBD | Se definirán al concretar interfaces y necesidades de cada subsistema.
Componentes concretos | Fuera del cierre de este paso | Se seleccionarán en etapas posteriores; este paso define arquitectura, no referencias comerciales.

Sheet: Arquitectura
ARQUITECTURA SELECCIONADA
Bloque | Selección | Función arquitectónica
Procesamiento | C&DH centralizado | Coordina cámara, sensores, actuación, EPS, almacenamiento y comunicaciones.
PCB 1 | EPS / potencia | Generación/entrada solar, gestión de batería, conversión, distribución, protección y supervisión de potencia.
PCB 2 | Aviónica / C&DH | Procesamiento, memoria, almacenamiento, interfaces de payload, ADCS, EPS y TT&C.
Comunicaciones internas | Organización centralizada | El C&DH actúa como coordinador central; protocolos concretos se definirán posteriormente.
Payload | Integrado | Cámara multiespectral integrada funcionalmente con C&DH y almacenamiento.
TT&C | Un enlace bidireccional | Permite telemetría, imágenes y comandos; la capacidad final queda condicionada al presupuesto de enlace.
ADCS | Sensores + control + magnetorquers | Permite determinar y modificar la orientación; el desempeño deberá validarse posteriormente.
DIVISIÓN FÍSICA EN PCBs
Elemento | PCB | Justificación / relación con arquitectura
Generación y gestión de potencia | PCB 1 — EPS | Separa la gestión de potencia de la aviónica y permite concentrar conversión, distribución y protección.
Batería / interfaz de batería | PCB 1 — EPS | La batería pertenece funcionalmente al sistema de potencia.
C&DH | PCB 2 — Aviónica | Es el núcleo de procesamiento y coordinación del sistema.
Almacenamiento | PCB 2 — Aviónica | Debe estar próximo al procesamiento y al flujo de datos del payload.
Interfaces de cámara | PCB 2 — Aviónica | Se mantiene próxima al procesamiento y almacenamiento; requiere atención a integridad de señal.
Interfaces ADCS | PCB 2 — Aviónica | Centraliza adquisición de sensores y control de actuación.
Interfaz TT&C | PCB 2 — Aviónica | Centraliza comunicaciones y conexión al sistema RF/antena.
INTERFACES PRINCIPALES
ID | Origen | Destino | Función | Tipo | Dirección | Señal / protocolo | Características eléctricas preliminares | Tasa / volumen | Observaciones
IF-01 | Paneles solares | PCB 1 — EPS | Entrada de energía generada | Potencia | → | Interfaz eléctrica de generación | Tensión/corriente TBD por dimensionamiento de EPS | — | La arquitectura exige generación solar.
IF-02 | Batería | PCB 1 — EPS | Almacenamiento y entrega de energía | Potencia | ↔ | Interfaz eléctrica batería | Tensión/corriente/condiciones de carga TBD | — | La batería forma parte del EPS.
IF-03 | PCB 1 — EPS | PCB 2 — Aviónica | Alimentación de aviónica | Potencia | → | Riel(es) de alimentación | Tensiones, corrientes y protecciones TBD | — | Interfaz crítica entre PCBs; debe cerrarse antes del esquemático.
IF-04 | PCB 2 — Aviónica | Cámara multiespectral | Alimentación de cámara | Potencia | → | Interfaz eléctrica | Tensión/corriente TBD según cámara seleccionada | — | La alimentación se entrega desde la aviónica alimentada por EPS.
IF-05 | PCB 2 — Aviónica | ADCS / sensores | Alimentación de sensores | Potencia | → | Interfaz eléctrica | Tensión/corriente TBD según sensores | — | Debe respetar requisitos de los sensores seleccionados posteriormente.
IF-06 | PCB 2 — Aviónica | ADCS / actuadores | Alimentación de actuación | Potencia | → | Interfaz eléctrica | Tensión/corriente/pulsos TBD según actuador y driver | — | La potencia se distribuye desde EPS a través de la aviónica.
IF-07 | C&DH | Cámara multiespectral | Configuración, disparo y recepción de imágenes | Datos/control | ↔ | Protocolo TBD | Niveles eléctricos y señales TBD | Volumen TBD | Depende de resolución, bandas, formato y cámara seleccionada.
IF-08 | C&DH | Almacenamiento | Escritura/lectura de imágenes y datos | Datos | ↔ | Protocolo TBD | Niveles/interfaz TBD | Volumen TBD | Debe dimensionarse conjuntamente con payload y comunicaciones.
IF-09 | Sensores ADCS | C&DH | Mediciones para determinación de actitud | Datos | → | Protocolo TBD | Niveles eléctricos TBD | Tasa TBD | Depende de sensores y estrategia de estimación.
IF-10 | C&DH | Drivers / magnetorquers | Comandos de actuación | Control | → | Interfaz de control TBD | Niveles/corriente/pulsos TBD | Tasa TBD | La arquitectura selecciona magnetorquers; el driver concreto se definirá después.
IF-11 | C&DH | PCB 1 — EPS | Supervisión y posibles comandos de potencia | Datos/control | ↔ | Protocolo TBD | Niveles eléctricos TBD | Tasa TBD | Incluye telemetría de estado; funciones exactas a cerrar con el diseño de EPS.
IF-12 | C&DH | Transceptor TT&C | Telemetría, comandos y datos de payload | Datos/control | ↔ | Protocolo/interfaz TBD | Niveles eléctricos TBD | Tasa TBD | La arquitectura selecciona un enlace bidireccional; el transceptor aún no está seleccionado.
IF-13 | Transceptor TT&C | Antena | Transmisión/recepción RF | RF | ↔ | Interfaz RF TBD | Impedancia/otros parámetros TBD | Tasa RF TBD | Depende del transceptor, frecuencia y antena seleccionados.
IF-14 | Antena | Estación terrestre | Enlace TT&C | RF | ↔ | Enlace inalámbrico TBD | Frecuencia/potencia TBD | Tasa TBD | Debe validarse mediante presupuesto básico de enlace.
IF-15 | C&DH | Estación terrestre | Comandos y telemetría a nivel de sistema | Datos/control | ↔ | A través de TT&C | No aplica a nivel eléctrico directo | Tasa TBD | Representa el flujo lógico extremo a extremo.
FRONTERA HARDWARE / SOFTWARE
Función | Implementación | Recursos HW | Responsabilidad del software futuro
Procesamiento y gestión de misión | Mixta | C&DH, memoria, periféricos | Ejecutar modos, secuencias, gestión de estados y tareas.
Adquisición de sensores | Mixta | Sensores, acondicionamiento/interfaz, entradas del C&DH | Configurar, leer y procesar mediciones.
Control de cámara | Mixta | Cámara e interfaz digital | Configurar adquisición, iniciar capturas y gestionar datos.
Almacenamiento | Mixta | Memoria/medio de almacenamiento e interfaz | Gestionar archivos, escritura, lectura y disponibilidad.
ADCS | Mixta | Sensores, C&DH, drivers y magnetorquers | Estimación/control y generación de comandos de actuación.
Supervisión EPS | Mixta | Medición, protección, convertidores y C&DH | Interpretar telemetría, estados y aplicar lógica de gestión.
TT&C | Mixta | Transceptor, antena, interfaces C&DH | Gestionar comandos, telemetría y flujo de datos.
Protección eléctrica | Hardware | Protecciones y distribución EPS | Solo supervisión/gestión a nivel lógico cuando aplique.
Conversión y distribución de potencia | Hardware | Convertidores, batería, distribución y protección | Supervisar variables y estados desde el C&DH.
REGLAS DE INTEGRIDAD Y CIERRE
Tema | Estado | Decisión / condición
Trazabilidad diagrama ↔ interfaces | CERRADO | Las interfaces IF-01 a IF-15 representan las conexiones funcionales principales del diagrama.
Cruce entre PCBs | CERRADO | La interfaz crítica explícita es IF-03: PCB 1 EPS → PCB 2 Aviónica. IF-11 representa supervisión/control en sentido lógico entre ambas.
Protocolos concretos | TBD JUSTIFICADO | No se seleccionan sin conocer los componentes/interfaz concreta; se cerrarán en la etapa de diseño detallado.
Tensiones de interfaces | TBD JUSTIFICADO | Deben derivarse del dimensionamiento y de las hojas de datos de los componentes que se seleccionen.
Cámara / datos | TBD JUSTIFICADO | Resolución, bandas, formato, volumen y tasa deben cerrarse conjuntamente con almacenamiento y TT&C.
TT&C | CONDICIONADO | El enlace bidireccional es la arquitectura base; debe validarse mediante presupuesto de datos y enlace.
ADCS | CONDICIONADO | La arquitectura de magnetorquers queda seleccionada, pero el desempeño de orientación debe validarse posteriormente.
Componentes concretos | FUERA DEL ALCANCE DE LA ARQUITECTURA | La guía indica que esta etapa no pretende seleccionar inmediatamente todos los componentes ni diseñar los circuitos.
CONCLUSIÓN DE LA ARQUITECTURA
La arquitectura seleccionada queda formalizada en dos PCBs: una tarjeta de EPS/potencia y una tarjeta de aviónica/C&DH. Las conexiones funcionales de potencia, datos, control y RF han sido identificadas; las interfaces concretas permanecen TBD únicamente cuando dependen de componentes o dimensionamientos todavía no definidos.
DIAGRAMA FUNCIONAL DE REFERENCIA — TRAZABILIDAD CON LA TABLA

Sheet: Presupuestos
PRESUPUESTO PRELIMINAR DE POTENCIA Y RECURSOS
ID | Subsistema | Potencia nominal | Potencia máxima | Ciclo de actividad estimado | Energía estimada | Masa estimada | Volumen asignado | Fuente de la estimación | Estado / observaciones
P10-01 | C&DH / OBC | TBD | TBD | Alta / según modo | TBD | TBD | TBD | Arquitectura seleccionada + documentación suministrada de aviónica para referencia | TBD justificado. La carga depende de OBC, memoria, interfaces y temporización finalmente seleccionadas.
P10-02 | EPS | TBD | TBD | Continua | TBD | TBD | TBD | Proyecto CubeSat + arquitectura + documentación suministrada de potencia | TBD justificado. Debe integrar generación, batería, conversión, distribución, protección y supervisión.
P10-03 | ADCS / sensores | TBD | TBD | Variable por modo | TBD | TBD | TBD | Arquitectura seleccionada: ADCS con magnetorquers; documentación GNC suministrada como referencia | Arquitectura cerrada a nivel funcional; sensores, driver y parámetros eléctricos concretos siguen TBD.
P10-04 | Magnetorquers | TBD | TBD | Intermitente | TBD | TBD | TBD | Documentación GNC suministrada; componente concreto aún no seleccionado | No se congela un consumo comercial. La carga se cerrará con torque requerido, actuador y driver.
P10-05 | Payload / cámara multiespectral | TBD | TBD | Solo adquisición | TBD | TBD | TBD | Proyecto CubeSat + matriz definitiva de especificaciones | GSD, FOV/swath, bandas, profundidad, formato, volumen y potencia deben cerrarse conjuntamente.
P10-06 | Almacenamiento de payload | TBD | TBD | Adquisición / descarga | TBD | TBD | TBD | Matriz definitiva de especificaciones + arquitectura C&DH | Capacidad depende del volumen por imagen y del máximo de capturas entre descargas.
P10-07 | TT&C / comunicaciones | TBD | TBD | Según pases y transferencia | TBD | TBD | TBD | Proyecto CubeSat + SOA de comunicaciones suministrado | Enlace bidireccional es la arquitectura base, condicionado al presupuesto de datos/enlace.
P10-08 | Batería | TBD | TBD | Carga/descarga según órbita | TBD | TBD | TBD | Arquitectura EPS + matriz definitiva de especificaciones | No se selecciona batería antes de cerrar perfil de potencia/energía y escenario de eclipse.
P10-09 | Generación solar | TBD | TBD | Durante iluminación | TBD | TBD | TBD | Arquitectura EPS + documentación de potencia suministrada | La potencia útil debe cerrarse considerando iluminación, orientación, pérdidas, degradación y margen.
P10-10 | Estructura / integración | — | — | — | — | TBD | TBD | Restricción 1U y documentación CubeSat suministrada | Masa y volumen finales dependen de componentes, PCB, cámara, batería, radio, antenas y cableado.
PRESUPUESTO DE INFORMACIÓN — PAYLOAD Y COMUNICACIONES
ID | Fuente de datos | Datos por adquisición | Adquisiciones estimadas | Volumen acumulado | Almacenamiento requerido | Tasa mínima de transferencia | Fuente | Estado | Observaciones
D10-01 | Cámara multiespectral | TBD MB/imagen | TBD | TBD MB | TBD MB/GB | TBD kbps | Matriz definitiva: ET-06 a ET-10 | TBD justificado | Depende de resolución, bandas, profundidad radiométrica, formato y compresión; luego de número de capturas y tiempo de contacto.
D10-02 | Telemetría | TBD | TBD | TBD | TBD | TBD | Arquitectura C&DH / TT&C | TBD justificado | Volumen no impuesto por los documentos; se definirá con el conjunto de variables de telemetría.
D10-03 | Telecomandos / ACK | TBD | TBD | TBD | No aplica como almacenamiento de payload | TBD | Arquitectura C&DH / TT&C | TBD justificado | La latencia depende de OBC, protocolo y carga; ET-01 permanece TBD.
RELACIONES DE CÁLCULO Y TRAZABILIDAD
ID | Magnitud | Relación / ecuación | Resultado actual | Unidad | Depende de | Estado | Uso en el presupuesto | Fuente | Nota de cierre
CALC-01 | Datos por imagen | D_img = N_x × N_y × N_bandas × bits/muestra ÷ 8 | TBD | MB/imagen | GSD, FOV, sensor, bandas, bits, formato | ABIERTO | Almacenamiento y tasa de bajada | Matriz definitiva ET-06 | No se conserva 2.765 MB como valor definitivo.
CALC-02 | Almacenamiento | S_req ≥ D_img × N_capturas_entre_descargas + datos_aux + margen | TBD | MB/GB | ET-06 + plan de observación/descarga | ABIERTO | Dimensionar memoria no volátil | Matriz definitiva ET-07 | No se fija una capacidad sin conocer volumen y plan de descarga.
CALC-03 | Tasa mínima de bajada | R_min ≥ D_acumulados / t_contacto; luego incluir eficiencia y margen | TBD | kbps | ET-06 + ET-08 + eficiencia de enlace | ABIERTO | Seleccionar/validar TT&C | Matriz definitiva ET-10 | ET-08 y ET-10 siguen TBD.
CALC-04 | Potencia total | P_total = Σ P_subsistemas + pérdidas + margen | TBD | W | OBC, ADCS, cámara, TT&C, EPS, modos | ABIERTO | Dimensionar EPS y batería | Guía + arquitectura | No se adopta 1.25 W como consumo final.
CALC-05 | Energía de modo | E_modo = P_modo × t_modo | TBD | Wh | Potencia y duración de cada modo | ABIERTO | Perfil energético | Guía + arquitectura | Debe evaluarse por modo de operación.
CALC-06 | Batería | E_bat,usable ≥ E_eclipse + margen | TBD | Wh | P_eclipse, duración eclipse, eficiencia, DoD, margen | ABIERTO | Dimensionar batería | Matriz definitiva ET-11/ET-37 | El escenario de eclipse no se congela todavía.
CALC-07 | Masa total | M_total = Σ m_componentes + estructura + cableado + margen | ≤ 2 kg | kg | Componentes finales | RESTRICCIÓN | Control de viabilidad 1U | CDS Rev. 14.1 suministrado | Restricción global del sistema.
CALC-08 | Volumen total | V_total ≤ volumen útil 1U, considerando interfaces, montaje y márgenes | ≤ 1U | L / cm³ | PCB, cámara, batería, radio, antenas, estructura | RESTRICCIÓN | Control de integración | Proyecto + CDS suministrados | Debe verificarse físicamente en diseño posterior.
CALC-09 | Margen de potencia/energía | P_generación_usable ≥ P_cargas + pérdidas + margen | ≥ margen definido por norma/proyecto | W / Wh | Balance EPS completo | ABIERTO | Validar generación + batería | Matriz definitiva / ECSS suministrada | No se congela un valor comercial de panel.
CALC-10 | Margen de procesamiento | Capacidad disponible ≥ demanda prevista × (1 + margen) | TBD | % | Carga SW, OBC, memoria, interfaces | ABIERTO | Validar C&DH | Matriz definitiva / ECSS suministrada | Se cierra con arquitectura OBC y carga computacional.
5. CÁLCULOS EXPLORATORIOS AUDITADOS — NO SON VALORES DEFINITIVOS
ID | Escenario anterior | Cálculo | Resultado | Estado | Motivo de no congelación | Acción definitiva
AUD-10-01 | 943×733, 2 bandas, 16 bits | 943×733×2×16/8 | 2.764.876 bytes ≈ 2.765 MB | EXPLORATORIO | La matriz definitiva mantiene GSD, bandas, profundidad y formato como TBD. | Usar D_img=TBD hasta seleccionar cámara/configuración.
AUD-10-02 | Órbita 550 km; eclipse simplificado | T ≈ 95.65 min; eclipse ≈ 35.61 min | 95.65 min / 35.61 min | EXPLORATORIO | El cálculo no sustituye el escenario orbital necesario para cerrar ET-08 y energía. | No usar como requisito ni como capacidad final de batería.
AUD-10-03 | C&DH 0.46 W + sensor 0.04 W + 3 magnetorquers × 0.25 W | 0.46+0.04+0.75 | 1.25 W | REFERENCIA PARCIAL | Faltan cámara, TT&C, otros sensores, pérdidas y márgenes; componentes no seleccionados. | Mantener solo como orden de magnitud documental, no como P_total.
6. TRAZABILIDAD DEL PRESUPUESTO
Elemento | Requisito / especificación | Arquitectura relacionada | Presupuesto que lo cierra | Estado | Próximo cierre
Cámara | RF-003, RF-015 / ET-02, ET-03, ET-06 | Payload integrado en PCB 2 | Datos + almacenamiento + potencia | TBD | Seleccionar cámara/óptica
Almacenamiento | RF-004 / ET-07 | C&DH centralizado en PCB 2 | Volumen acumulado | TBD | Definir capturas entre descargas
TT&C | RI-002 / ET-08, ET-09, ET-10 | Enlace bidireccional condicionado | Datos + enlace + potencia | CONDICIONADO | Cerrar pase y tasa; luego transceptor
ADCS | RF-009 / ET-04, ET-05 | Magnetorquers + sensores + C&DH | Potencia + desempeño | CONDICIONADO | Cerrar sensores/estimador/actuadores
EPS | RF-006 / ET-11, ET-36, ET-37 | PCB 1 EPS | Potencia + energía + batería + solar | TBD | Cerrar perfil de potencia y energía
Masa/volumen | Restricciones 1U | Dos PCB + estructura + subsistemas | Masa + volumen | RESTRICCIÓN | Actualizar al seleccionar componentes
7. CONTROL DE CIERRE DE PRESUPUESTO
ID | Control | Estado | Resultado / decisión | Acción pendiente | Fuente
C-10-01 | Potencia nominal/máxima/ciclo/energía/mass/volume incluidos | OK | Tabla principal sigue el formato de la guía. | Cerrar valores al seleccionar componentes. | Guía lab003, Presupuesto
C-10-02 | Datos por adquisición/adquisiciones/acumulado/storage/tasa incluidos | OK | Tabla de información incluida; valores dependientes permanecen TBD. | Cerrar cámara y plan de descarga. | Guía + matriz definitiva
C-10-03 | Generación, batería, almacenamiento, procesamiento y comunicación acoplados | OK | Relaciones de cálculo explícitas y trazabilidad cruzada. | Cerrar parámetros dependientes. | Guía + arquitectura
C-10-04 | No usar cifras invalidadas por la versión documental definitiva | CORREGIDO | GSD, bandas, datos/imagen, eclipse y potencia total no se presentan como valores finales. | Ninguna en esta etapa. | Matriz definitiva
C-10-05 | TBD justificados | OK | Cada TBD indica dependencia y próximo cierre. | Continuar con selección/dimensionamiento posterior. | Matriz definitiva
C-10-06 | Fuentes limitadas a documentos suministrados | OK | No se incorporan valores externos de Internet. | Mantener criterio en pasos siguientes. | Regla metodológica del proyecto
REFERENCIAS CUANTITATIVAS DE ORDEN DE MAGNITUD — NO SON VALORES DE DISEÑO
Área | Referencia documental | Dato de referencia | Valor | Unidad | Uso en el presupuesto | Estado
Procesamiento | NASA Small Spacecraft State of the Art 2026, Table 8-4 — C3S Electronics OBC | Consumo medido en modo de prueba, usando eMMC como almacenamiento masivo | 0.46 | W | Referencia de orden de magnitud para el presupuesto de potencia del procesamiento | No es selección ni valor de diseño
Procesamiento | NASA Small Spacecraft State of the Art 2026, Table 8-4 — Alén Space DARA OBC | Consumo máximo reportado | 0.28 | W | Referencia de orden de magnitud para comparar el consumo del bloque C&DH | No es selección ni valor de diseño
ADCS | NASA Small Spacecraft State of the Art 2026, Table 5-4 — NewSpace Systems NCTR-M003 | Potencia pico del magnetorquer | 0.25 | W | Referencia de orden de magnitud para el presupuesto de potencia de actuación ADCS | No es selección ni valor de diseño
ADCS | NASA Small Spacecraft State of the Art 2026, Table 5-4 — ZARM Technik MT0.2-1 | Potencia del magnetorquer | 0.135–0.25 | W | Referencia de rango para evaluar el orden de magnitud del consumo de actuación | No es selección ni valor de diseño
EPS | NASA Small Spacecraft State of the Art 2026, Table 3-8 — GomSpace P31U | Potencia máxima de salida | 30 | W | Referencia de orden de magnitud para comprobar la escala del sistema EPS | No es selección ni valor de diseño
EPS | NASA Small Spacecraft State of the Art 2026, Table 3-8 — GomSpace P31U | Eficiencia máxima | 96 | % | Referencia para considerar pérdidas de conversión en el presupuesto energético | No es selección ni valor de diseño
Comunicaciones | NASA Small Spacecraft State of the Art 2025, Table 9-3 — ISISPACE TRXVU | Tasa mínima de datos | 9.6 | kbps | Referencia de orden de magnitud para contrastar el presupuesto de comunicaciones | No es selección ni valor de diseño
Comunicaciones | NASA Small Spacecraft State of the Art 2025, Table 9-3 — NanoAvionics SatCOM UHF | Intervalo de tasa de datos | 2.4–38.4 | kbps | Referencia de rango para contrastar la tasa mínima requerida | No es selección ni valor de diseño
NOTA DE USO DE LAS REFERENCIAS: Los valores anteriores se incorporan únicamente como referencias cuantitativas de orden de magnitud obtenidas de los documentos SOA suministrados para el curso. No representan componentes seleccionados para el CubeSat, no sustituyen el presupuesto de diseño y no cierran las especificaciones que permanecen TBD. Su función es comprobar que las magnitudes preliminares de potencia, procesamiento, ADCS y comunicaciones se encuentran dentro de rangos técnicamente observados en sistemas SmallSat. La selección de componentes y la verificación mediante hojas de datos corresponden a la etapa de diseño electrónico detallado.
8. FUENTES DOCUMENTALES UTILIZADAS
• lab003_2598575_20262.pdf — guía de la Práctica 3.
• Matriz_CubeSat_FINAL_DOCUMENTAL_Requisitos_Especificaciones.xlsx — versión definitiva de requisitos/especificaciones y control de fuentes.
• Matriz_CubeSat_FINAL_Requisitos_Especificaciones.xlsx — trazabilidad y versiones previas utilizadas durante la consolidación.
• Arquitectura_Seleccionada — dos PCB e interfaces.
• Sustentacion_Especificaciones_Tecnicas — cálculos exploratorios.
• Proyecto CubeSat UD34 2026.pdf — misión, 1U, órbita de referencia, estación, payload y subsistemas.
• CDS REV14_1 2022-02-09.pdf — restricciones CubeSat de masa, volumen e integración.
• ECSS-E-ST-20C-Rev.2 (8 April 2022).pdf — criterios suministrados para márgenes y recursos.
• 3-soa-power-2026-final.pdf, 5-soa-gnc-2026-final.pdf, 9-soa-comm-2025-final.pdf, 8-smallsat-avionics-2026-final.pdf — referencias de estado del arte suministradas; no se usan para imponer valores finales.

Sheet: Revisión
ID | Tipo | Tema | Descripción | Evidencia / origen | Impacto | Estado | Acción de cierre | Etapa de cierre
R-01 | Riesgo | Procesamiento centralizado | La arquitectura concentra las funciones de procesamiento y gestión en el C&DH centralizado. | Selección arquitectónica del Paso 8 y distribución HW/SW | Posible cuello de botella de procesamiento o memoria si la carga aumenta. | Identificado | Dimensionar procesamiento, memoria y carga computacional según las funciones definitivas. | Diseño detallado
R-02 | Riesgo | Complejidad de PCB | La arquitectura utiliza dos PCB y concentra funciones de aviónica, almacenamiento, payload, ADCS y TT&C en la PCB de aviónica. | Arquitectura seleccionada del Paso 9 | Mayor densidad de señales e interfaces y mayor complejidad de integración. | Identificado | Verificar distribución física, alimentación, señales, integridad y compatibilidad de interfaces. | Diseño de PCB
R-03 | Riesgo | Capacidad de TT&C | La capacidad necesaria de transmisión depende del volumen definitivo de información y de la oportunidad de comunicación. | Paso 8 y presupuesto de comunicaciones del Paso 10 | Podría existir una capacidad insuficiente para descargar toda la información generada. | Condicionado | Cerrar datos por adquisición, volumen acumulado, tiempo de contacto y presupuesto de enlace. | Dimensionamiento de comunicaciones
R-04 | Riesgo | Carga útil | Los parámetros definitivos de la carga útil aún no están completamente definidos. | Especificaciones técnicas: GSD, swath, bandas, resolución y formato permanecen TBD. | Los parámetros de carga útil afectan directamente datos, almacenamiento, procesamiento y comunicaciones. | Abierto | Seleccionar y justificar la cámara y derivar sus parámetros de desempeño. | Diseño de carga útil
R-05 | Riesgo | Desempeño ADCS | Los magnetorquers fueron seleccionados a nivel arquitectónico, pero los componentes y parámetros de desempeño todavía no están cerrados. | Paso 8 y Paso 9 | El sistema podría no alcanzar el desempeño de orientación requerido. | Abierto | Definir sensores, estimación, control y actuadores y verificar el desempeño del ADCS. | Diseño ADCS
R-06 | Riesgo | Presupuesto energético | El presupuesto completo de potencia y energía todavía depende de componentes y perfiles de operación no definidos. | Paso 10 | Existe riesgo de insuficiencia energética durante operación y eclipse. | Abierto | Cerrar cargas, ciclo de actividad, generación solar, batería y márgenes. | Diseño EPS
R-07 | Riesgo | Interfaces internas | Algunas interfaces físicas y lógicas permanecen TBD. | Distribución HW/SW y arquitectura del Paso 9 | Podrían aparecer incompatibilidades durante la integración. | Abierto | Definir señales, niveles eléctricos, protocolos y condiciones de interfaz en el ICD. | Diseño detallado
R-08 | Riesgo | Integridad y compatibilidad de señales | La coexistencia de cámara, memoria, procesamiento, conversión de potencia y TT&C requiere validación posterior. | Arquitectura de dos PCB y distribución HW/SW | Posibles problemas de integridad de señal, ruido o compatibilidad durante el diseño físico. | Identificado | Realizar análisis de integridad de señal, distribución de potencia y compatibilidad electromagnética durante el diseño de PCB. | Diseño de PCB
L-01 | Limitación | GSD | El GSD no está definido en la versión documental definitiva. | Matriz definitiva de requisitos y especificaciones | No permite cerrar completamente la resolución espacial de la misión ni algunos parámetros de la cámara. | TBD | Definirlo a partir de la cámara, óptica y requisitos de observación. | Diseño de carga útil
L-02 | Limitación | Swath | El ancho de franja de observación permanece TBD. | Matriz definitiva de requisitos y especificaciones | No permite cerrar completamente la cobertura por adquisición. | TBD | Derivarlo a partir de la geometría de la cámara y los parámetros orbitales. | Diseño de carga útil
L-03 | Limitación | Bandas espectrales | Las bandas espectrales no se fijan como rojo/NIR en la versión documental definitiva. | Matriz definitiva de requisitos y especificaciones | No permite cerrar el número de canales ni el volumen definitivo de datos. | TBD | Seleccionar y justificar las bandas requeridas para la misión. | Diseño de carga útil
L-04 | Limitación | Volumen de datos | El volumen definitivo por adquisición permanece TBD. | Matriz definitiva y presupuesto del Paso 10 | No permite cerrar definitivamente almacenamiento y tasa de transmisión. | TBD | Derivarlo después de cerrar resolución, bandas, profundidad radiométrica y formato. | Diseño de carga útil
L-05 | Limitación | Análisis orbital | La duración y frecuencia de las oportunidades de comunicación no están cerradas mediante un análisis orbital detallado. | Presupuesto del Paso 10 | No permite determinar definitivamente la tasa de transmisión requerida. | TBD | Realizar el análisis orbital simplificado correspondiente al escenario de misión. | Análisis orbital
L-06 | Limitación | Selección de componentes | La Práctica 3 establece la arquitectura, pero no cierra todos los componentes electrónicos concretos. | Alcance de la Práctica 3 | Los valores definitivos de masa, volumen, potencia y desempeño de algunos subsistemas permanecen abiertos. | Deliberado | Realizar la selección de componentes durante la etapa de diseño detallado. | Práctica siguiente
L-07 | Limitación | Diseño esquemático | No se ha realizado todavía el diseño esquemático ni el diseño físico de las PCB. | Alcance de la Práctica 3 | Las características eléctricas y físicas definitivas aún no pueden verificarse. | Deliberado | Desarrollar esquemáticos, selección de componentes y diseño de PCB en la siguiente etapa. | Práctica siguiente
AP-01 | Pendiente | GSD | Definir el GSD definitivo. | ET-02 | Es necesario para cerrar la prestación espacial de la carga útil. | TBD | Seleccionar cámara y óptica y calcular el GSD. | Próxima etapa
AP-02 | Pendiente | Swath | Definir el ancho de franja de observación. | ET-03 | Es necesario para caracterizar la cobertura de cada adquisición. | TBD | Derivar a partir de la geometría de cámara y misión. | Próxima etapa
AP-03 | Pendiente | Bandas espectrales | Definir las bandas espectrales de la carga útil. | Especificaciones técnicas | Determina la información espectral obtenida y afecta el volumen de datos. | TBD | Seleccionar y justificar las bandas de acuerdo con la misión. | Próxima etapa
AP-04 | Pendiente | Formato y profundidad radiométrica | Definir profundidad, formato y representación de las imágenes. | Especificaciones técnicas | Afecta directamente el volumen de información y almacenamiento. | TBD | Definirlos con la selección de la cámara. | Próxima etapa
AP-05 | Pendiente | Almacenamiento | Dimensionar la capacidad de almacenamiento necesaria. | ET-07 y presupuesto del Paso 10 | Depende del volumen por imagen y de la cantidad máxima de adquisiciones entre descargas. | TBD | Calcular el peor caso y añadir el margen correspondiente. | Próxima etapa
AP-06 | Pendiente | Duración de pases | Determinar la duración efectiva de las oportunidades de comunicación. | ET-09 y presupuesto del Paso 10 | Es necesaria para dimensionar la tasa mínima de transmisión. | TBD | Realizar análisis orbital simplificado. | Próxima etapa
AP-07 | Pendiente | Margen de enlace | Definir el margen de enlace requerido. | ET-09 | Es necesario para verificar la viabilidad del enlace TT&C. | TBD | Realizar presupuesto de enlace con los parámetros del sistema de comunicaciones. | Próxima etapa
AP-08 | Pendiente | Tasa de bajada | Determinar la tasa mínima necesaria para descargar la información generada. | ET-10 | Depende del volumen de datos y del tiempo disponible de comunicación. | TBD | Calcularla a partir del peor caso de datos y tiempo de contacto. | Próxima etapa
AP-09 | Pendiente | Potencia total | Completar el presupuesto de potencia del sistema. | Paso 10 | Es necesario para cerrar EPS, batería y generación solar. | TBD | Integrar las potencias de todos los subsistemas y sus ciclos de actividad. | Próxima etapa
AP-10 | Pendiente | Batería | Dimensionar la capacidad energética de la batería. | Paso 10 | Es necesaria para garantizar operación durante los periodos sin generación solar. | TBD | Usar el perfil de cargas, escenario de eclipse, eficiencia y margen. | Próxima etapa
AP-11 | Pendiente | Generación solar | Dimensionar la generación solar necesaria. | Paso 10 | Es necesaria para garantizar el balance energético del sistema. | TBD | Realizar el balance entre generación, cargas, almacenamiento y márgenes. | Próxima etapa
AP-12 | Pendiente | Sensores ADCS | Definir los sensores concretos del sistema de determinación de actitud. | Paso 8 y Paso 9 | Se necesitan para cerrar el desempeño del ADCS. | TBD | Seleccionar sensores y verificar compatibilidad con los requisitos de actitud. | Próxima etapa
AP-13 | Pendiente | Control ADCS | Definir los parámetros y estrategia definitiva de control de actitud. | Distribución HW/SW y arquitectura | Es necesario para verificar el desempeño requerido. | TBD | Desarrollar y verificar el algoritmo de control con el modelo ADCS. | Próxima etapa
AP-14 | Pendiente | Actuadores ADCS | Seleccionar los magnetorquers concretos y sus parámetros eléctricos. | Selección arquitectónica del Paso 8 | Es necesario para cerrar potencia, masa, volumen e interfaces. | TBD | Realizar dimensionamiento y selección del componente. | Próxima etapa
AP-15 | Pendiente | Protocolos internos | Definir los protocolos de comunicación entre los subsistemas y PCB. | Distribución HW/SW y Paso 9 | Es necesario para cerrar las interfaces de hardware y software. | TBD | Definir las interfaces en el ICD del sistema. | Próxima etapa
AP-16 | Pendiente | Componentes electrónicos | Seleccionar los componentes concretos de los subsistemas. | Alcance de la Práctica 3 | Permitirá cerrar valores reales de masa, volumen, potencia e interfaces. | TBD | Realizar selección durante el diseño electrónico detallado. | Práctica siguiente
