valenjess/CubeSat/(list of files, drawings)

Other design files:
P4/Altium/ADCS_CubeSat_1U_Zuluaga_Gaviria/00_ADCS_TOP.SchDoc
P4/Altium/ADCS_CubeSat_1U_Zuluaga_Gaviria/10_Control.SchDoc
P4/Altium/ADCS_CubeSat_1U_Zuluaga_Gaviria/20_Sensores.SchDoc
P4/Altium/ADCS_CubeSat_1U_Zuluaga_Gaviria/21_IMU.SchDoc
P4/Altium/ADCS_CubeSat_1U_Zuluaga_Gaviria/22_Magnetometro.SchDoc
P4/Altium/ADCS_CubeSat_1U_Zuluaga_Gaviria/23_Solar_TIA.SchDoc
P4/Altium/ADCS_CubeSat_1U_Zuluaga_Gaviria/30_Actuadores.SchDoc
P4/Altium/ADCS_CubeSat_1U_Zuluaga_Gaviria/31_Ruedas.SchDoc
P4/Altium/ADCS_CubeSat_1U_Zuluaga_Gaviria/32_Magnetor.SchDoc
P4/Altium/ADCS_CubeSat_1U_Zuluaga_Gaviria/40_CANFD.SchDoc
P4/Altium/ADCS_CubeSat_1U_Zuluaga_Gaviria/50_POWER.SchDoc
P4/Altium/ADCS_CubeSat_1U_Zuluaga_Gaviria/51_INPUT_PROTECTION.SchDoc
P4/Altium/ADCS_CubeSat_1U_Zuluaga_Gaviria/52_BUCK_5V.SchDoc
P4/Altium/ADCS_CubeSat_1U_Zuluaga_Gaviria/53_BUCK_3V3.SchDoc
P4/Altium/ADCS_CubeSat_1U_Zuluaga_Gaviria/54_ANALOG_POWER.SchDoc
P4/Altium/ADCS_CubeSat_1U_Zuluaga_Gaviria/ADCS_CubeSat_1U.PrjPcb
P4/Altium/ADCS_CubeSat_1U_Zuluaga_Gaviria/Adquicision_Analogica.SchDoc
P4/Altium/ADCS_CubeSat_1U_Zuluaga_Gaviria/Components - 23.10.26 - 21.13/4_7KR.PcbLib
P4/Altium/ADCS_CubeSat_1U_Zuluaga_Gaviria/Components - 23.10.26 - 21.13/4_7KR.SchLib
P4/Altium/ADCS_CubeSat_1U_Zuluaga_Gaviria/Components - 23.10.26 - 21.41/4_7µFX7R.PcbLib
P4/Altium/ADCS_CubeSat_1U_Zuluaga_Gaviria/Components - 23.10.26 - 21.41/4_7µFX7R.SchLib
P4/Altium/ADCS_CubeSat_1U_Zuluaga_Gaviria/Components - 23.10.26 - 21.49/1_µFX7R.SchLib
P4/Altium/ADCS_CubeSat_1U_Zuluaga_Gaviria/Components - 23.10.26 - 21.49/1_µFX7RPcbLib.PcbLib
P4/Altium/ADCS_CubeSat_1U_Zuluaga_Gaviria/Components - 23.10.26 - 22.35/0_1uF.PcbLib
P4/Altium/ADCS_CubeSat_1U_Zuluaga_Gaviria/Components - 23.10.26 - 22.35/0_1uF.SchLib
P4/Altium/ADCS_CubeSat_1U_Zuluaga_Gaviria/Components - 24.10.26 - 17.33/2_2uH.PcbLib
P4/Altium/ADCS_CubeSat_1U_Zuluaga_Gaviria/Components - 24.10.26 - 17.33/2_2uH.SchLib
P4/Altium/ADCS_CubeSat_1U_Zuluaga_Gaviria/Components - 24.10.26 - 17.59/10uF_25V.PcbLib
P4/Altium/ADCS_CubeSat_1U_Zuluaga_Gaviria/Components - 24.10.26 - 17.59/10uF_25V.SchLib
P4/Altium/ADCS_CubeSat_1U_Zuluaga_Gaviria/Components - 24.10.26 - 18.05/100nF_25V.PcbLib
P4/Altium/ADCS_CubeSat_1U_Zuluaga_Gaviria/Components - 24.10.26 - 18.05/100nF_25V.SchLib
P4/Altium/ADCS_CubeSat_1U_Zuluaga_Gaviria/Components - 24.10.26 - 18.19/3_3nF.PcbLib
P4/Altium/ADCS_CubeSat_1U_Zuluaga_Gaviria/Components - 24.10.26 - 18.19/3_3nF.SchLib
P4/Altium/ADCS_CubeSat_1U_Zuluaga_Gaviria/Components - 24.10.26 - 18.31/100KR.PcbLib
P4/Altium/ADCS_CubeSat_1U_Zuluaga_Gaviria/Components - 24.10.26 - 18.31/100KR.SchLib
P4/Altium/ADCS_CubeSat_1U_Zuluaga_Gaviria/Components - 24.10.26 - 20.10/TPS62162DSGT.PcbLib
P4/Altium/ADCS_CubeSat_1U_Zuluaga_Gaviria/Components - 24.10.26 - 20.10/TPS62162DSGT.SchLib
P4/Altium/ADCS_CubeSat_1U_Zuluaga_Gaviria/Components - 24.10.26 - 20.38/10uF_25V.PcbLib
P4/Altium/ADCS_CubeSat_1U_Zuluaga_Gaviria/Components - 24.10.26 - 20.38/10uF_25V.SchLib
P4/Altium/ADCS_CubeSat_1U_Zuluaga_Gaviria/Components - 24.10.26 - 20.41/Components - 24.10.26 - 20.41.PcbLib
P4/Altium/ADCS_CubeSat_1U_Zuluaga_Gaviria/Components - 24.10.26 - 20.41/Components - 24.10.26 - 20.41.SchLib
P4/Altium/ADCS_CubeSat_1U_Zuluaga_Gaviria/Components - 24.10.26 - 21.27/TPS22919DCKR.PcbLib
P4/Altium/ADCS_CubeSat_1U_Zuluaga_Gaviria/Components - 24.10.26 - 21.27/TPS22919DCKR.SchLib
P4/Altium/ADCS_CubeSat_1U_Zuluaga_Gaviria/Components - 25.10.26 - 13.54/DRV8833PWPR.PcbLib
P4/Altium/ADCS_CubeSat_1U_Zuluaga_Gaviria/Components - 25.10.26 - 13.54/DRV8833PWPR.SchLib
P4/Altium/ADCS_CubeSat_1U_Zuluaga_Gaviria/Components - 25.10.26 - 14.07/47KR_0_1W.PcbLib
P4/Altium/ADCS_CubeSat_1U_Zuluaga_Gaviria/Components - 25.10.26 - 14.07/47KR_0_1W.SchLib
P4/Altium/ADCS_CubeSat_1U_Zuluaga_Gaviria/Components - 25.10.26 - 14.16/10uF_10V.PcbLib
P4/Altium/ADCS_CubeSat_1U_Zuluaga_Gaviria/Components - 25.10.26 - 14.16/10uF_10V.SchLib
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
