valenjess/CubeSat/(commit log)

2026-09-29 Add files via upload
    Requisitos, especificaciones y arquitectura
    [Cubesat_Valentina_Sebastian.xlsx]
2026-10-07 Add files via upload
    Se adjuntan las fuentes bibliográficas de las cuales se extrajo información relevante, estas son adicionales a las proporcionadas en la plataforma ingenia.
2026-10-27 Add files via upload
    Carga de datasheets principales.
2026-10-27 Se añade la matriz de restricciones
    La matriz guarda relación con las especificaciones de la Práctica 3.
2026-10-27 Add files via upload
    Hoja de cálculo con matrices sobre: listado de componentes, Pinout del MCU, correcciones y criterios, presupuesto de potencia y notas de cierre.
2026-10-27 Se añade tabla BOM
2026-10-27 Delete P4/Calculos directory
    Se elimina ítem de cálculos, estos se incluyen en la matriz de restricciones
